treydufrene/meiosis_dev/README.md

# meiosis_dev
development code for meiosis project
