treydufrene/meiosis_dev/LaTeX/cdr/4.2.5.tex

The mechanical parts list and budget is shown in Table \ref{tab:mechbom} below.

\begin{table}[htp]
  \center
  \caption{Mechanical Parts List}
  \label{tab:mechbom}
\begin{tabular}{c|c|c|c|C{2cm}}
Part & Quantity & Individual price & Transaction Cost & Cost to MEIOSIS \\\hline
M3x30mm Screws & 2 & \$5.99 & \$11.98 & \$11.98 \\
M3 Locking nuts & 1 & \$7.99 & \$7.99 & \$7.99 \\
TRiREAK AC Bearing & 7 & \$9.00 & \$63.00 & \$63.00 \\
Thrust Bearing & 1 & \$7.99 & \$7.99 & \$7.99 \\
Skateboard Bearings & 1 & \$5.29 & \$5.29 & \$5.29 \\
MX-64T Servo & 3 & \$299.90 & \$899.70 & \$0 \\
MX-12W Servo & 3 & \$65.90 & \$197.70 & \$197.70 \\
AX-12A Servo* & 1 & \$44.90 & \$44.90 & \$44.90 \\
Hatchbox PLA & 2 Spools & \$19.99/Spool & \$39.98 & \$0 \\
& & \textbf{Total Cost} & \$1,278.53 & \$338.85 \\
\end{tabular}\\
\small{*: Not Yet Purchased}
\end{table}

As shown by Table \ref{tab:mechbom} above, the total cost of the budget is over \$1,200, although the actual cost to the MEIOSIS team is less than this due to the availability of parts in the robotics lab.
