treydufrene/meiosis_dev/LaTeX/cdr/introduction.tex

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

\section*{Notation}\vspace{-\baselineskip}
\renewcommand{\arraystretch}{2.25}
\begin{tabular}{rcl}
\large%
\(
{}^{\text{\scriptsize Frame}}_{\text{\scriptsize From}}~{r}~_{\text{\scriptsize To}}
\)\normalsize &:& Direction Vectors\\
\(
{}^{\text{\scriptsize From}}~{T}~_{\text{\scriptsize To}}
\)\normalsize &:& Direction Cosine (Transformation) Matrices \\
\(c_{\theta_{nm}}\)&:& \( \cos(\theta_n + \theta_m)\)\\
\(s_{\theta_{nm}}\)&:& \( \sin(\theta_n + \theta_m)\) \\
\end{tabular}
\renewcommand{\arraystretch}{1}
\newpage
\pagenumbering{arabic}
\section{Introduction}
Robotics is a rapidly growing field, yet numerous potential innovators for the discipline are never exposed to it. While many industrial style manipulators are available for commercial applications, their cost is so high that they are not practical for educational purposes. With the intention of making robotics education more accessible to classrooms, the Manipulator for Educational Institutions with Open Source Integrated Systems (MEIOSIS) initially aimed to provide robotics classes with an accurate and precise manipulator for cost lower than traditional manipulators. The goal of MEIOSIS is now to provide an accurate and repeatable manipulator, given the capstone team budget. MEIOSIS is designed to be 3D printed by the end-user to increase accessibility of the manipulator and will be modifiable to help create an increased understanding of robotics. The following document details the entirety of the design process, from conceptual design and definition of requirements to final implementation and testing.
