treydufrene/meiosis_dev/LaTeX/cdr/sysdynamics.tex

The motor equation (\ref{eq:fin}) gives an expression for the motor torques, however the system dynamics are defined in terms of geometric joint angles. The inclusion of harmonic gearboxes is taken care of by equation \ref{eq:A}.

\begin{equation}
  \gamma = A\theta\quad \text{where}~~A=\left[\begin{array}{cccccc}
  -1/20 & 0 & {0} & {0} & {0} & {0} \\
   0 & -1/39 & {0} & {0} & {0} & {0} \\
    {0} & {0} & -1/39 & {0} & {0} & {0} \\
    {0} & {0} & {0} & -1/20 & {0} & {0} \\
     {0} & {0} & {0} & {0} & -1/20 & 0\\
      {0} & {0} & {0} & {0} & 0 & -1/20
    \end{array}\right]
\label{eq:A}
\end{equation}
The gear ratios for the harmonics are taken care of by the diagonal entries in the matrix shown in equation \ref{eq:A} above. The motor angles can then be solved for using the inverse of the A matrix, as shown in equation \ref{eq:Ainv}.
\begin{equation}
\theta=A^{-1} \gamma
\label{eq:Ainv}
\end{equation}
It is important to note that the virtual work done by the joint torques ($F_{\gamma}$) and the virtual work done by the motor torques ($F_{\theta}$) are equal. Using equation (\ref{eq:Ainv}), a linear relation between the joint torques and motor torques can be determined.
\[
\begin{aligned}
  \delta W = F_{\theta}^{T} \delta \theta&=F_{\gamma}^{T} \delta \gamma, \text { where } \delta \gamma=A \delta \theta \\
  F_{\theta}^{T} \delta \theta &= F_{\gamma}^{T}(A \delta \theta) \\
  F_{\theta}^{T}&=F_{\gamma}^{T} A\\
  \left(F_{\theta}^{T}\right)^{T}&=\left(F_{\gamma}^{T} A\right)^{T}\\
  F_{\theta}=A^{T} F_{\gamma} &\Leftrightarrow F_{\gamma}=A^{-T} F_{\theta}\qquad\quad
\end{aligned}
\]
Using this equation, a relation can be determined between the motor dynamics and the system dynamics given in equation (\ref{eq:fin}) and equation (\ref{eq:eoms}) respectively.

\[
H(\gamma) \ddot{\gamma}+d(\gamma, \dot{\gamma})+G(\gamma)=-A^{-T}\left(C_1A^{-1} \ddot{\gamma}+C_2 A^{-1} \dot{\gamma}+C_3 \theta_{d}- C_3A^{-1} \gamma\right)
\]
\begin{equation}
\ddot{\gamma}=H(\gamma)^{-1}\left(-A^{-T}\left(C_1 A^{-1} \ddot{\gamma}+C_2 A^{-1} \dot{\gamma}+C_3 \theta_{d}-C_3A^{-1} \gamma\right)-d(\gamma, \dot{\gamma})-G(\gamma)\right)
\label{eq:gddot}
\end{equation}

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
