treydufrene/meiosis_dev/LaTeX/cdr/coverpage.tex

\begin{titlepage}
\flushleft
\doublespacing\center
\Large
% \null\vspace{3cm}
\null\vfill

\textbf{Detailed Design Report}
\vspace{4ex}\normalsize

Trey Dufrene \hfill Zack Johnson \hfill David Orcutt \hfill Alan Wallingford \hfill Ryan Warner
\vfill
\vspace{0.8cm}
  \normalsize
  Submitted in Partial Fulfillment of the Requirements of: \\
  ME420 Detailed Design of Robotic Systems -- Spring 2020\\

  \vspace{0.6cm}
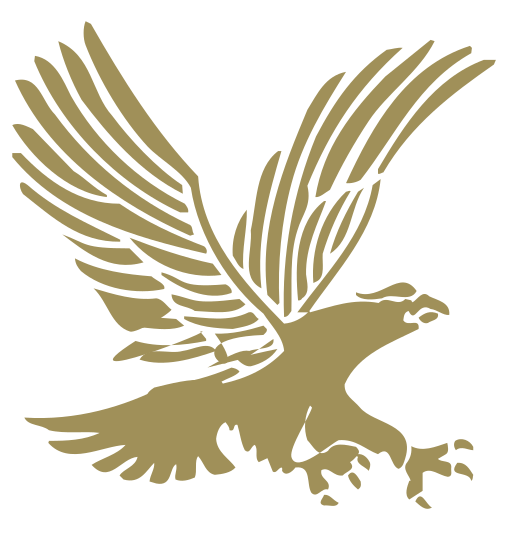
[picture p25: LaTeX/report/images/univ.png]
  
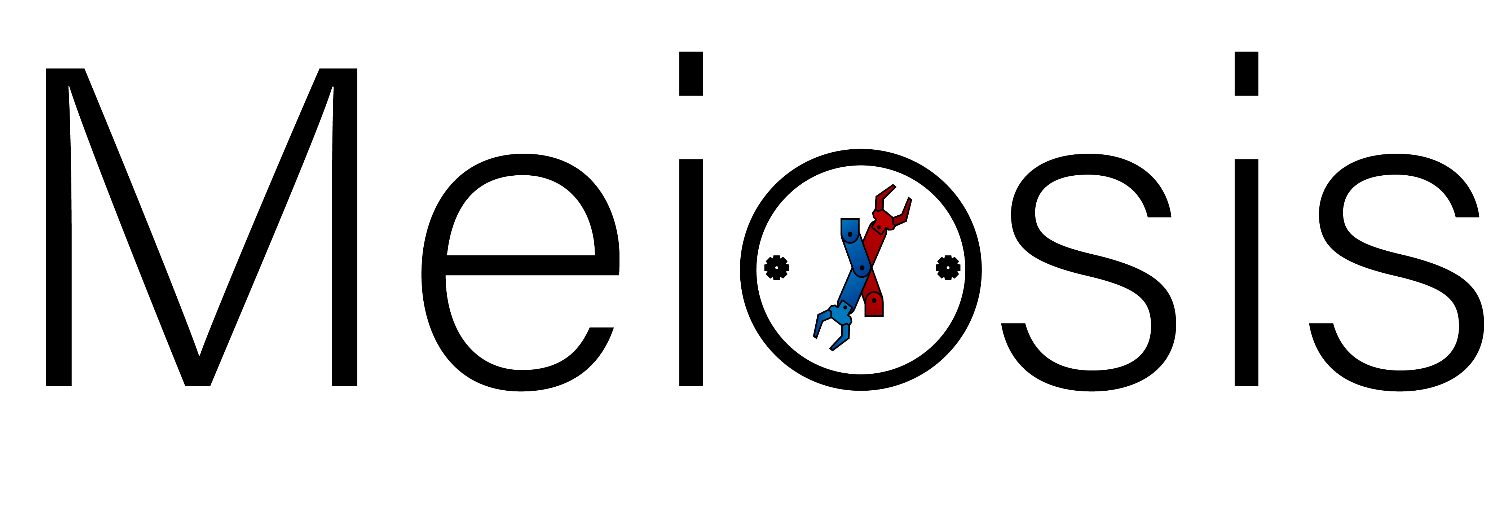
[picture p26: LaTeX/GCD/images/text.png]
  
  \vspace{.2ex}\onehalfspacing
  College of Engineering\\
  Embry-Riddle Aeronautical University\\
  Prescott, AZ\\
\end{titlepage}

% \begin{titlepage}
% \flushleft
% \doublespacing
% \Large
% \textsc{Final Report} \\
% \normalsize
% Trey Dufrene, Alan Wallingford, David Orcutt, Ryan Warner, Zack Johnson
% \vfill
% \center
% \includegraphics[width=.45\textwidth]{logo}
% \vfill
% \flushleft
% ME 407 \\
% Preliminary Design of Robotic Systems \\
% Embry-Riddle Aeronautical University \\
% \vspace{2ex}
% \begin{minipage}[c]{.5\textwidth}
% \flushleft
% \includegraphics[width=.95\textwidth]{erau}
% \end{minipage}%
% \begin{minipage}[c]{.5\textwidth}
% \flushright
% \includegraphics[width=.8\textwidth]{text}
% \end{minipage}
% \end{titlepage}
