treydufrene/meiosis_dev/LaTeX/cdr/hdg.tex

\begin{lstlisting}[frame=lines,style=Matlab-editor,basicstyle = \mlttfamily, caption={H, D, and G Calculations}]
function [H, d, G] = Meiosis_HdG(gamma,gammadot)

    %       Mass Parameters
    %Mass(kg)
    m{1} = 0.13954848;      %Link 1
    m{2} = 1.14358921;      %Link 2
    m{3} = 1.00606970;      %Link 3
    m{4} = 0.26834265;      %Link 4
    m{5} = 0.03933179;      %Link 5
    m{6} = 0.19893937;
    m{7} = 0.24224704;      %Gear 1
    m{8} = 0.24224704;      %Gear 2
    m{9} = 0.05035795;      %Gear 3
    m{10} = 0.05035795;

    %Center of mass for each link (m)
    rcm{1} = [ 0.00000000; 0.00000000;-0.02792483];     %Link 1
    rcm{2} = [ 0.00007758; 0.15623908;-0.00011610];     %Link 2
    rcm{3} = [-0.01528806; 0.07006082; 0.00110335];     %Link 3
    rcm{4} = [ 0.00000000; 0.03163485; 0.00000000];     %Link 4
    rcm{5} = [ 0.00000000; 0.00630115; 0.00000000];     %Link 5
    rcm{6} = [ 0.00000000;-0.03626349;-0.00034373];     %Link 6
    rcm{7} = [-0.02271539;-0.00001560; 0.00001565];     %Gear 1
    rcm{8} = [ 0.02271539;-0.00001560;-0.00001565];     %Gear 2
    rcm{9} = [-0.00678010; 0.00000000; 0.00000000];     %Gear 3
    rcm{10}= [ 0.00678010; 0.00000000; 0.00000000];     %Gear 4

    Gam{1} = rcm{1}*m{1};
    Gam{2} = rcm{2}*m{2};
    Gam{3} = rcm{3}*m{3};
    Gam{4} = rcm{4}*m{4};
    Gam{5} = rcm{5}*m{5};
    Gam{6} = rcm{6}*m{6};
    Gam{7} = rcm{7}*m{7};
    Gam{8} = rcm{8}*m{8};
    Gam{9} = rcm{9}*m{9};
    Gam{10} = rcm{10}*m{10};

    %Inertia Matrices
	J{1} = [ 0.00015462  0.00000000  0.00000000;        %Link 1
	         0.00000000	 0.00016692  0.00000000;
	         0.00000000	 0.00000000  0.00003819];
    J{2} = [ 0.03894999 -0.00002305  0.00000000;        %Link 2
            -0.00002305  0.00589287  0.00001585;
             0.00000000  0.00001585  0.04414151];
    J{3} = [ 0.01143098  0.00169728  0.00000008;        %Link 3
	         0.00169728	 0.00185484 -0.00021794;
	         0.00000008	-0.00021794  0.01259229];
    J{4} = [ 0.00063966  0.00000000  0.00000000;        %Link 4
	         0.00000000	 0.00069715  0.00000000;
	         0.00000000	 0.00000000  0.00108401];
    J{5} = [ 0.00000851  0.00000000  0.00000000;        %Link 5
	         0.00000000	 0.00001467  0.00000000;
	         0.00000000	 0.00000000  0.00002081];
    J{6} = [ 0.00036378  0.00000000  0.00000000;        %Link 6
	         0.00000000	 0.00007212 -0.00000173;
	         0.00000000	-0.00000173  0.00034916];
    J{7} = [ 0.00014269 -0.00000005  0.00000005;        %Gear 1
	        -0.00000005	 0.00029726  0.00000000;
	         0.00000005	 0.00000000  0.00029726];
    J{8} = [ 0.00014269  0.00000005  0.00000005;        %Gear 2
	         0.00000005	 0.00029726  0.00000000;
	         0.00000005	 0.00000000  0.00029726];
    J{9} = [ 0.00003333  0.00000000  0.00000000;        %Gear 3
	         0.00000000	 0.00001986  0.00000000;
	         0.00000000	 0.00000000  0.00001986];
    J{10}= [ 0.00003333  0.00000000  0.00000000;        %Gear 4
	         0.00000000	 0.00001986  0.00000000;
	         0.00000000	 0.00000000  0.00001986];

    %          Forward kinematics
    %Relative Positions
    rBfromI =  [ 0.00000000; 0.00000000; 0.00000000];
    r1fromB =  [ 0.00000000; 0.00000000; 0.12275000];
    r2from1 =  [ 0.00000000; 0.00000000; 0.00000000];
    r3from2 =  [ 0.00000000; 0.26000000; 0.00000000];
    r4from3 =  [ 0.00000000; 0.20000000; 0.00000000];
    r5from4 =  [ 0.00000000; 0.07000000; 0.00000000];
    r6from5 =  [ 0.00000000; 0.09600000; 0.00000000];
    rG1from1 = [ 0.09055000; 0.00000000; 0.00000000];
    rG2from1 = [-0.09055000; 0.00000000; 0.00000000];
    rG3from5 = [ 0.04700000; 0.00000000; 0.00000000];
    rG4from5 = [-0.04700000; 0.00000000; 0.00000000];

    %Store orientations in cell array
    rn{1} = r1fromB;
    rn{2} = r2from1;
    rn{3} = r3from2;
    rn{4} = r4from3;
    rn{5} = r5from4;
    rn{6} = r6from5;
    rn{7} = rG1from1;
    rn{8} = rG2from1;
    rn{9} = rG3from5;
    rn{10} = rG4from5;

    %Orientations wrt I
    TB = eye(3);
    T{1} = TB*rotz(gamma(1));
    T{2} = T{1}*rotx(gamma(2));
    T{3} = T{2}*rotx(gamma(3));
    T{4} = T{3}*roty(gamma(4));
    T{5} = T{4}*rotx(gamma(5));
    T{6} = T{5}*roty(gamma(6));
    T{7} = T{1}*rotx(gamma(1));           %Gear 1
    T{8} = T{1}*rotx(-gamma(1));          %Gear 2
    T{9} = T{5}*rotx(-gamma(6));          %Gear 3
    T{10} = T{5}*rotx(gamma(6));          %Gear 4

    %Positions wrt I
    rB = rBfromI;
    r{1} = rB + TB*r1fromB;
    r{2} = r{1} + T{1}*r2from1;
    r{3} = r{2} + T{2}*r3from2;
    r{4} = r{3} + T{3}*r4from3;
    r{5} = r{4} + T{4}*r5from4;
    r{6} = r{5} + T{5}*r6from5;
    r{7} = r{1} + T{1}*rG1from1;        %Gear 1
    r{8} = r{1} + T{1}*rG2from1;        %Gear 2
    r{9} = r{5} + T{5}*rG3from5;        %Gear 3
    r{10}= r{5} + T{5}*rG4from5;        %Gear 4

    %              Recursive Kinematics
    Jb0 = zeros(6);
    Jbdot0 = zeros(6);

    for ii = 1:10
        if ii == 1
            Jmat = Jb0;
            wI = Jmat(1:3,:)*gammadot;
            [Jb{ii},Jbdot{ii}] = Next_GeoJac_Meiosis(Jb0,Jbdot0,gamma,gammadot,TB,rn{ii},zeros(3,1),wI,ii);
        elseif ii == 7
            Jmat = Jb{1};
            wI = Jmat(1:3,:)*gammadot;
            [Jb{ii},Jbdot{ii}] = Next_GeoJac_Meiosis(Jb{1},Jbdot{1},gamma,gammadot,T{1},rn{ii},zeros(3,1),wI,ii);
        elseif ii == 8
            Jmat = Jb{1};
            wI = Jmat(1:3,:)*gammadot;
            [Jb{ii},Jbdot{ii}] = Next_GeoJac_Meiosis(Jb{1},Jbdot{1},gamma,gammadot,T{1},rn{ii},zeros(3,1),wI,ii);
        elseif ii == 9
            Jmat = Jb{5};
            wI = Jmat(1:3,:)*gammadot;
            [Jb{ii},Jbdot{ii}] = Next_GeoJac_Meiosis(Jb{1},Jbdot{5},gamma,gammadot,T{5},rn{ii},zeros(3,1),wI,ii);
        elseif ii == 10
            Jmat = Jb{5};
            wI = Jmat(1:3,:)*gammadot;
            [Jb{ii},Jbdot{ii}] = Next_GeoJac_Meiosis(Jb{1},Jbdot{5},gamma,gammadot,T{5},rn{ii},zeros(3,1),wI,ii);
        else
            Jmat = Jb{ii-1};
            wI = Jmat(1:3,:)*gammadot;
            [Jb{ii},Jbdot{ii}] = Next_GeoJac_Meiosis(Jb{ii-1},Jbdot{ii-1},gamma,gammadot,T{ii-1},rn{ii},zeros(3,1),wI,ii);
        end

        Jmat = Jb{ii};
        wI = Jmat(1:3,:)*gammadot;

        Hmat = Jb{ii}.'*[J{ii},skew(Gam{ii})*T{ii}.';T{ii}*skew(Gam{ii}).',m{ii}*eye(3)]*Jb{ii};
        dvec = Jb{ii}.'*[J{ii},skew(Gam{ii})*T{ii}.';T{ii}*skew(Gam{ii}).',m{ii}*eye(3)]*Jbdot{ii}*gammadot + Jb{ii}.'*[cross(wI,J{ii}*wI);T{ii}*cross(wI,cross(wI,Gam{ii}))];
        g = Jb{ii}.'*[cross(rcm{ii},T{ii}.'*[0;0;-m{ii}*9.81]);[0;0;-m{ii}*9.81]];

        if ii == 1
            H = Hmat;
            d = dvec;
            G = g;
        else
            H = H + Hmat;
            d = d + dvec;
            G = G + g;
        end
    end

end
\end{lstlisting}
