treydufrene/meiosis_dev/LaTeX/templates/template.tex

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

\begin{document}
\normalem
\input{coverpage}
\pagenumbering{roman}
% \begin{abstract}
  % Wordy words
% \end{abstract}
{\tableofcontents\let\clearpage\relax\listoffigures\let\clearpage\relax\listoftables}
\clearpage
\newpage

% \section*{List Of Acronyms and Abbreviations}

% \begin{tabular}{rl}
%   $G$~:&Center of gravity of the bar \\
%   $\ell_0$~:& Spring unstretched length  \\
%   $\delta$~:& Spring deflection \\
%   $k$~:& Spring constant \\
%   $h_{b}$~:& Distance to bar ($G$) from datum \\
%   $F_s$~:& Force onto bar due to spring\\
%   $A_{n}$~:& Pin reaction in $\theta$ direction\\
%   $A_{t}$~:& Pin reaction in tangential direction \\
%   $\vec{v}_G$~:& Velocity of bar center of gravity\\
%   $\ddot{\theta}$~:& Angular velocity of spring \\
%   $\ddot{\phi}$~:& Angular velocity of bar\\
%   $\ddot{\ell}_s$~:& Radial acceleration of spring \\
% \end{tabular}
% \normalsize
% \flushleft
% \singlespacing
% \newpage

\pagenumbering{arabic}

% A Level:
% \section{}
% B Level:
% \subsection{B Level Heading}
% C Level
% \subsubsection{}

% Example citations:
% \cite{DBLP:journals/corr/JohnsonAL16}
% \cite{DBLP:journals/corr/abs-1803-09820}
% \cite{DBLP:journals/corr/RonnebergerFB15}

% \section{A Level Heading}
% Sample table with tabulated data and reference label
% \begin{table}[htp]
%   \center
%   \caption{DH Table for 6 DOF Manipulator}
%   \label{table:dh}
%   \color{red} bold col headers, table times new roman, 12pt., centered, \color{black} \\
%   \begin{tabular}{C{1cm}|C{1cm}C{2cm}C{1cm}C{1cm}}
%     \textbf{DH} & $d_i$ & $\theta_i$ & $a_i$ & $\alpha_i$ \\ \hline
%     1 & 280 & $q_1 - \pi$ & 0 & $\sfrac{\pi}{2}$ \\
%     2 & 0 & $q_2 + \sfrac{\pi}{2}$ & 210 & 0 \\
%     3 & 0 & $q_3 - \sfrac{\pi}{2}$ & 75 & -$\sfrac{\pi}{2}$ \\
%     4 & 210 & $q_4$ & 0 & $\sfrac{\pi}{2}$ \\
%     5 & 0 & $q_5 - \pi$ & 0 & $\sfrac{\pi}{2}$ \\
%     6 & 70 & $q_6$ & 0 & 0 \\
%   \end{tabular}
% \end{table}
% here is the table reference callout
% \emph{Table \ref{table:dh}} shows the Denavit–Hartenberg parameters for the manipulator.

% Here is a centered mathtype with no number
% $$
% \vec{v}_G =
% \left[\dot{\ell}_s\sin(\theta) + \frac{\ell_b\dot{\phi}\cos(\phi)}{2} +
% \ell_s\dot{\theta}\cos(\theta)\right]\hat{\textrm{\i}} +
% \left[\frac{\ell_b\dot{\phi}\sin(\phi)}{2} -
% \dot{\ell}_s\cos(\theta) + \ell_s\dot{\theta}\sin(\theta)\right]\hat{\textrm{\j}}
% $$

% Here is a centered equation with number and reference label
% \begin{equation}
% \ddot{\theta} = \frac{d}{dt}\left(\frac{\partial\Lag}{\partial\dot{\theta}}\right) -
% \frac{\partial\Lag}{\partial\theta} = \big(Q_{\theta}\big)_{\text{non}}
% \label{eq:lagtheta}
% \end{equation}

% This is some inline mathtype: $u = \frac{1}{2}mv^2$, (notice the fluidity and smaller size than the other mathtype)

% \section{A Level Heading}
% \begin{figure}[h]
%   \centering
%   \includegraphics[width=.75\textwidth]{filename}
%   \caption{Figure with Callouts}
%   \label{fig:figname}
% \end{figure}

% \begin{enumerate}[label=\alph*.]
%   \item Description for callout a
%   \item Description for callout b
% \end{enumerate}

% As seen in \emph{Figure \ref{fig:figname}}

% \newpage
% \bibliographystyle{plain}
% \bibliography{JohnsonAL16,abs-1803-09820,RonnebergerFB15}

% \newpage
% \section*{Acknowledgements \& Attributions}
% \begin{itemize}
%   \item People!
% \end{itemize}
% \newpage

% \newpage
% \appendix
% \renewcommand\thesection{\Roman{section}}
% \renewcommand\thesubsection{\roman{subsection}}
% \section*{Appendix}\label{sec:app}
% Code listing
%\begin{lstlisting}[frame=lines,style=Matlab-editor,basicstyle = \mlttfamily, caption=Example Code
% Code Here
%\end{lstlisting}

% \includepdf[landscape,pages=-]{pdfname}

\end{document}
