treydufrene/meiosis_dev/LaTeX/report/final.pdf

Final Report

Trey Dufrene, Alan Wallingford, David Orcutt, Ryan Warner, Zack Johnson

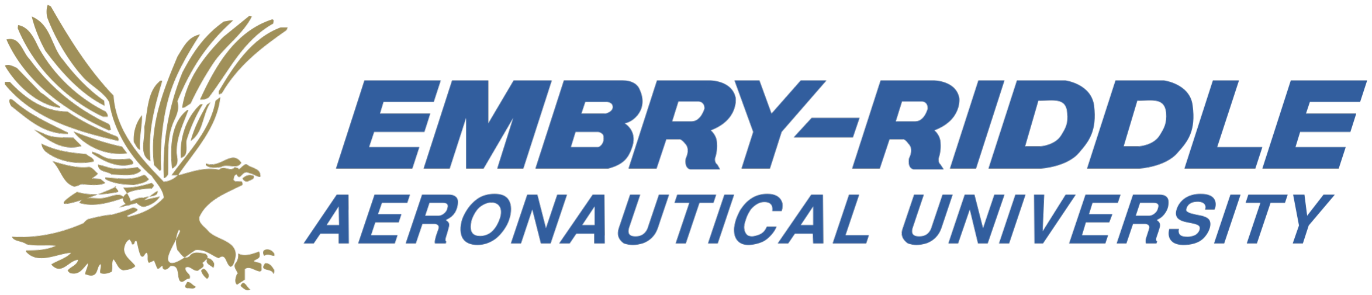
[picture p27: figure]
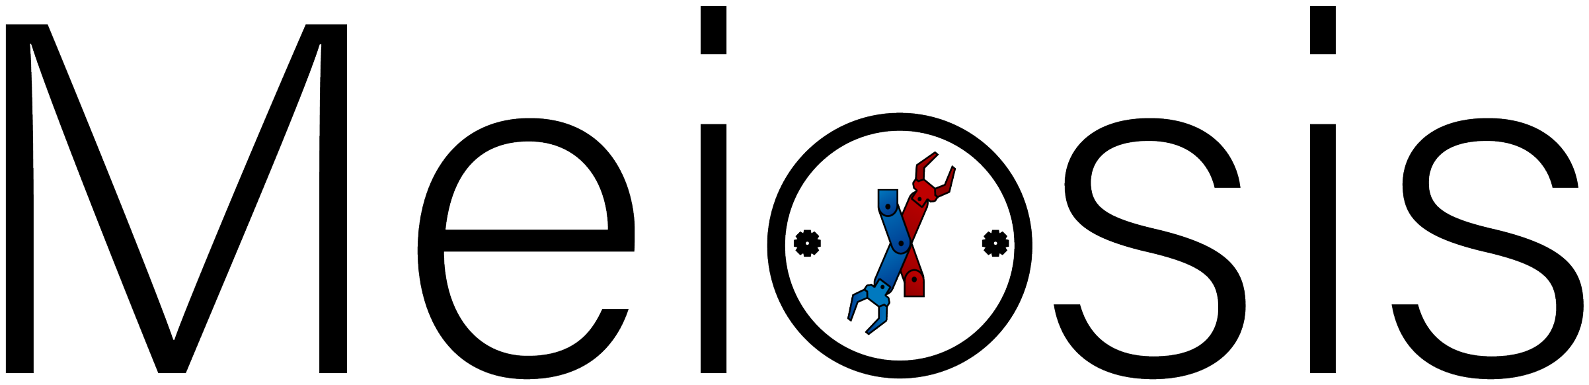
[picture p28: figure]

ME 407

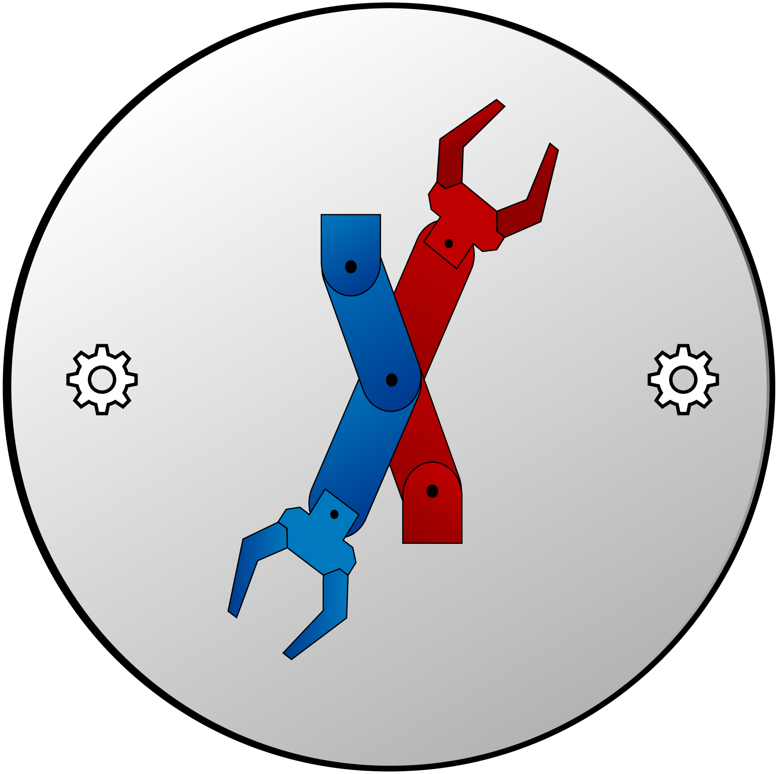
[picture p29: figure]

Preliminary Design of Robotic Systems

Embry-Riddle Aeronautical University

# Contents

1 | Introduction | | 1
2 | Requirements | | 1
3 | Conceptual Design | | 1
4 | Specifications | | 2
4.1 | Introduction | | 2
4.2 | Design Requirements | | 2
4.3 | Hardware | | 3
4.4 | Software | | 6
5 | Preliminary Design | | 8
5.1 | CAD | | 8
5.2 | Forward Kinematics | | 9
5.3 | Velocity Kinematics | | 11
5.4 | Inverse Kinematics | | 11
5.5 | Equations of Motion | | 12
5.6 | Open-Loop Simulation | | 13
5.7 | Control System | | 13
5.8 | Closed-Loop Simulation | | 13
5.9 | ANSYS | | 13
5.10 | Electrical Schematic | | 13
5.11 | Software Flowchart | | 13
5.12 | Project Status and Future | | 13
5.13 | Parts List | | 13
I | Appendix | | 17
i | Drawings | | 17
ii | Salient Code | | 17

# List of Figures

1 | Overview of Physical System | | 2
2 | Elbow Manipulator Configuration with Link Offset | | 4
3 | Kinematic Model Representing Zeroed Configuration | | 5
4 | Coordinate Systems | | 9
5 | Cross Section of Dexterous Workspace Quadrant | | 17

i

## 1 Introduction

## 2 Requirements

— The system shall cost the end-user no more than $1000.

— The system shall be fully dexterous without being kinematically redundant.

— The system end-effector shall maintain a positional accuracy magnitude of ±1 mm and an orientation accuracy of ±5

◦
eigen angle from the base frame.

— The system end-effector shall maintain a pose repeatability magnitude between 0.1 -1.5 mm for the position and ±4

◦
eigen angle from the base frame for the orientation.

— The system’s reachable workspace shall be a hemisphere with a radius of 300-700 mm.

— The system’s dexterous workspace shall contain a hemispherical shell within the reachable workspace with a thickness of 280 mm.

— The system shall have a removable end-effector capable of picking and placing a low-odor chisel tip Expo dry erase marker.

— The system shall be able to write with a low-odor chisel tip Expo dry erase marker.

— The system shall be open source.

— The system shall be capable of operating given only desired end-effector cartesian coordinates specified with respect to the base frame.

## 3 Conceptual Design

## 4 Specifications

### 4.1 Introduction

With the intention of making robotics education more accessible, The Manipulator for Educational Institutions with Open Source Integrated Systems (MEIOSIS) intends to provide high school educators and robot enthusiasts with a low cost manipulator. The system should be usable by novice students. It should also be modifiable to create a sustainably increased understanding of robotics. While MEIOSIS may not fully emulate industrial manipulators, it aims to provide more students with access to robotics education.


Figure 1: Overview of Physical System

The design seen in Figure 1 is based on our conceptual design. It features four links and six joints for rotation and will be referenced throughout this document. The base of the manipulator and end-effector can also be seen in the figure.

### 4.2 Design Requirements

The specifications of the system are strictly based on the requirements defined previously. The requirements are divided into two primary categories, hardware and software.

### 4.3 Hardware

The following requirements and specifications are hardware specific and dictate the physical constaints the system must adhere to.

4.3.1 The system shall cost the end-user no more than $1000.

4.3.1.a The cost for the MEIOSIS team to develop the manipulator shall cost no more than $800.

### 4.3.2 The system shall be fully dexterous without being kinematically

redundant.

4.3.2.a The system shall consist of six rotational joints connected by four links. The last three joints will create a spherical wrist.

As defined [1], “A manipulator having more than six DOF is referred to as a kinematically redundant manipulator (5).” A manipulator with less than six degrees of freedom will not be fully dexterous within it’s workspace. Figure 3 (see subsection 4.3.6, p. 5) shows a six degree-of-freedom rotary manipulator with it’s coordinate frames in zeroed positions. The joint and link locations are seen in Figure 1 (see section 4.1, p. 2).

4.3.2.b The system shall have no link offsets.

Link offsets as seen in Figure 2 are commonly used to avoid singularities. However, having a link offset prevents the manipulator’s dexterous workspace from being a complete hemispherical shell.

As shown in Figure 2, the line directly above the first joint of the manipulator is offset such that the axes of the other joints are unable to become collinear with the base axis; this prevents singularity but causes a void in the detxterous workspace.

### 4.3.3 The system end effector shall maintain a positional accuracy magnitude

of ±1 mm and an orientation accuracy of ±5

- eigen angle from the base frame.

To ensure that the robot has educational value, the accuracy must be defined so that any desired positions and movements are achieved.

4.3.3.a The system shall accommodate a process in which the end user can calibrate the end effector position and orientation to within 0.5 mm and 1 degree of the manipulator’s


Figure 2: Elbow Manipulator Configuration with Link Offset [1]

precision.

The addition of a calibration process allows the removal of any systematic errors, such as drift. The theoretical limit of the calibration process is the difference between the precision and accuracy metrics of the system.

### 4.3.4 The system end effector shall maintain a pose repeatability magnitude

between 0.1—1.5 mm for the position and ±4

- eigen angle from the base frame for the orientation.

4.3.4.a Joint one and two of the system shall possess an angle error of no more than .025 degrees.

Being that joint one and two are the first two rotational elements in the system, their error will propagate the most to the end effector’s position.

4.3.4.b Joint three of the system shall possess an angle error of no more than .03 degrees.

Since joint three is closer to the end effector it’s error will not propagate as severely throughout the system.

4.3.4.c Joints four, five, and six shall possess an angle error of no more than .29 degrees.

The spherical wrist is the closest to the end effector’s final position and therefore has the least error propagation.

### 4.3.5 The system’s reachable workspace shall be a hemisphere with a radius

of 300-700 mm.

This workspace will provide enough movement to manipulate objects in order to perform basic tasks.

4.3.5.a The length of link one, two, three, four, and the wrist shall be 220.8 mm, 250 mm, 200 mm, 80 mm, and 52.5 mm respectively.

This results in a total height of 220.8 mm with a total reach of 582.5 mm in the zeroed configuration as shown in the configuration represented in Figure 3.

### 4.3.6 The system’s dexterous workspace shall contain a hemispherical shell

within the reachable workspace with a thickness of 280 mm.

This workspace will provide enough movement to manipulate objects in order to perform basic tasks. 280mm is slightly greater than the length of letter paper.

4.3.6.a The rotational limit of joint one, two, three, four, five, and six shall be ±180◦
, −9.7

◦
to 177.5

◦
, −150.6

◦
to −19.3

◦

, ±180◦

, −180◦
to −1.6

◦

, and ±180◦
respectively.

The angles stated are with respect to the kinematic model shown in Figure 3. To be fully dexterous within our 280 mm dexterous workspace the manipulator must have the joint angles specified above. The joint limitations were calculated by iteratively verifying the orientation about every point within the quarter hemisphere cross section seen in Figure 5 (see Appendix, p. 17).

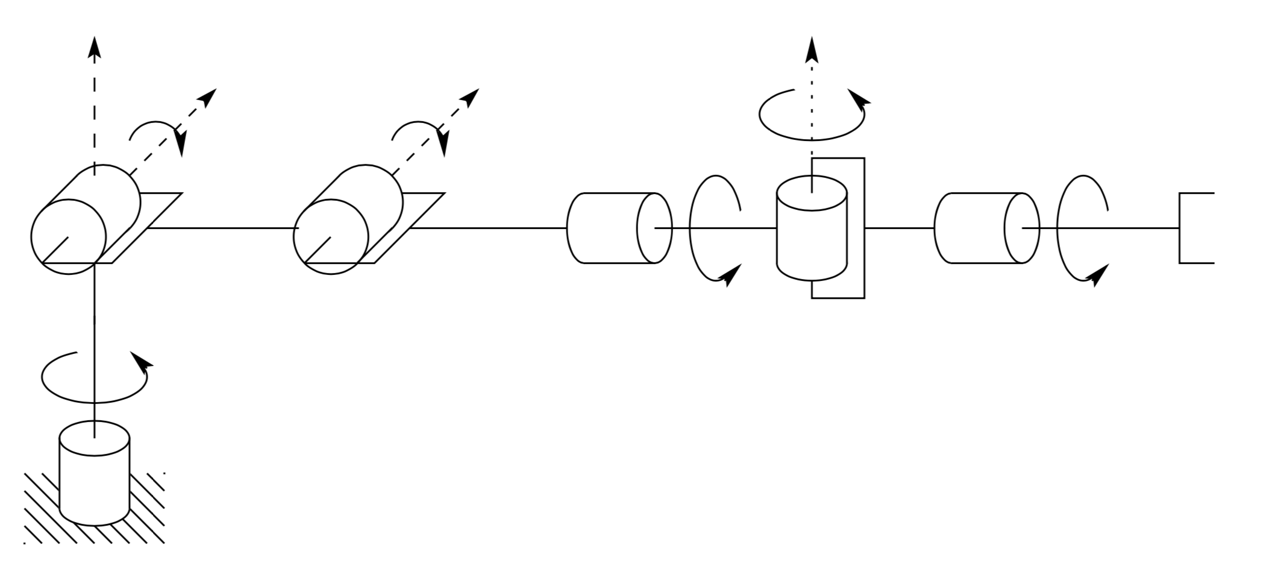
[picture p30: figure]

Figure 3: Kinematic Model Representing Zeroed Configuration [1]

### 4.3.7 The system shall have a removable end effector capable of picking and

placing a low-odor chisel tip Expo dry erase marker.

This creates a robot capable of performing a variety of basic tasks, which enhances its educational value.

4.3.7.a The system shall use a parallel gripper that can close to 18mm.

The diameter of a low-odor chisel tip Expo dry erase marker is approximately 18 mm.

4.3.7.b The end effector shall attach to the manipulator using screws configured in a pattern that can accommodate a Dynamixel AX-12A servo.

It is expected that a majority of end effector styles will have to accommodate for a servo to facilitate actuation, therefore a pattern was chosen to standardize the mounting.

### 4.3.8 The system shall be able to write with a low-odor chisel tip Expo dry

erase marker.

4.3.8.a The end effector shall be able to support 0.004 Newton meter moments about the axes normal to its gripping surfaces.

The coefficient of friction between the Expo marker and paper can be approximated and given the weight of an Expo marker the approximate grip strength of the end effector can be calculated.

### 4.4 Software

The following requirements and specifications are software specific and determine the at-tributes of the operating system.

4.4.1 The system shall be open source.

This will create an easily obtainable, low cost method of distributing the system’s source code, which may be modified for personal use.

4.4.1.a The software shall be hosted publicly on an online repository and maintain an MIT license for distribution.

This allows the end-user to freely download and modify the code without licensing. The MIT license disregards any legal obligation to code upkeep and documentation by the original author.

### 4.4.2 The system shall be capable of operating given only desired end effector

cartesian coordinates specified with respect to the base frame.

4.4.2.a The system shall have a user interface capable of accepting the end-effector’s desired cartesian position and Euler angle orientation as a six element row vector.

The system software interface facilitates an untrained user to operate without the advanced knoledge of the system’s kinematics.

4.4.2.b The system shall be capable of performing floating point arithmetic.

The solution for the inverse kinematics requires the ability to perform high level arithmetic with little error.

## 5 Preliminary Design

### 5.1 CAD

### 5.2 Forward Kinematics

The forward kinematics of the manipulator are described by the equations below, where the reference coordinate frames are given by Figure (4).

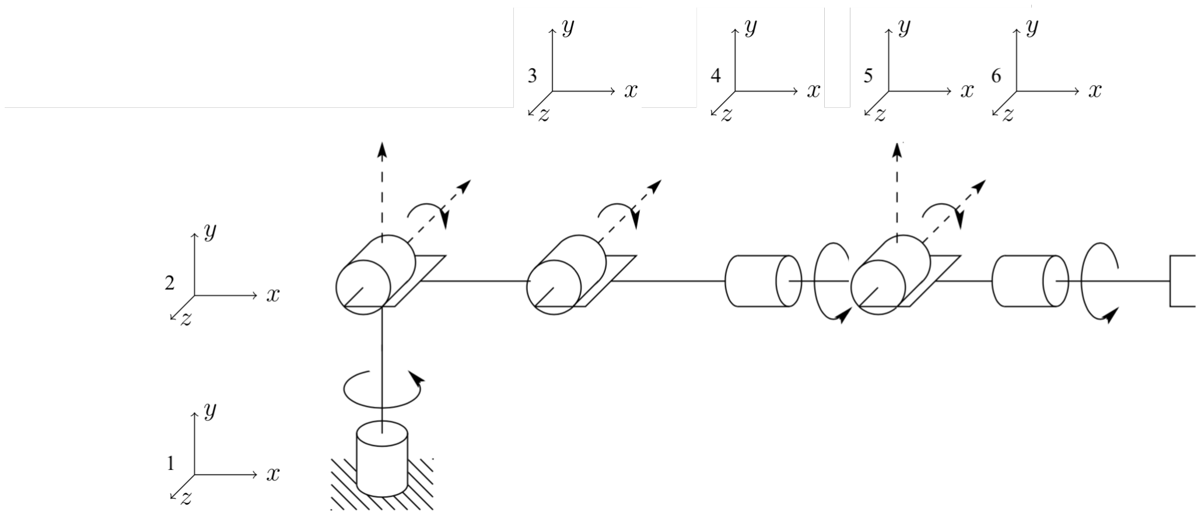
[picture p31: figure]

Figure 4: Coordinate Systems

Given the lengths of each of the manipulator links,

I
Br1 =

0
0
`b

1/1 r2 =

0
0
`1

2/2 r3 =

0
`2
0

3/3 r4 =

0
`3
0

4/4 r5 =

0
`4
0

5/5 r6 =

0
`5
0

The position of each link relative to the inertial frame is given as:

I
Br1 = Br1

I
Br2 = r1 +

IT1
1/1 r2

I
Br3 = r2 +

IT2
2/2 r3

I
Br4 = r3 +

IT3
3/3 r4

I
Br5 = r4 +

IT4
4/4 r5

I
Br6 = r5 +

IT5
5/5 r6

I
Br1 =

0
0
`b

I
Br2 =

0
0
`b + `1

I
Br3 =

−`2cθ2
sθ1
`2cθ12
`b + `1 + `2sθ2

I
Br4 =

−sθ1

(`3cθ23 + `2cθ2

)
cθ1

(`3cθ23 + `2cθ2

)
`1 + `b + `3sθ23 + `2sθ2

I
Br5 =

−sθ1

(`3cθ23 + `4cθ23 + `2cθ2

)
cθ1

(`3cθ23 + `4cθ23 + `2cθ2

)
`1 + `b + `3sθ23 + `4sθ23 + `2sθ2

I
Br6 =

`5cθ1
sθ4

sθ5 − `4cθ23 sθ1 − `2cθ2

sθ1 − `5cθ23 cθ5

sθ1 − `3cθ23 sθ1
+ `5cθ2
cθ4

sθ1

sθ3

sθ5 + `5cθ3
cθ4

sθ1

sθ2

sθ5
`5(sθ5

(sθ1

sθ4 − cθ4

(cθ1
cθ2

sθ3 + cθ1
cθ3

sθ2

)) − cθ5

(cθ1
sθ2

sθ3 − cθ1
cθ2

cθ3

))
− `3(cθ1
sθ2

sθ3 − cθ1
cθ2

cθ3

) − `4(cθ1
sθ2

sθ3 − cθ1
cθ2

cθ3

) + `2cθ1
cθ2

`1 + `b + `3sθ23 + `4sθ23 + `2sθ2 +

`5cθ23 sθ45
2

+ `5sθ23 cθ5 −

`5sθ4−θ5
cθ23
2

Given the direction cosine matrices,

rotx(θ) =

1 | 0 | 0
0 cos(θ) − sin(θ)
0 sin(θ) cos(θ)

- , roty(θ) =

1 | 0 | 0
0 cos(θ) − sin(θ)
0 sin(θ) cos(θ)

rotz(θ) =

cos(θ) | 0 | sin(θ)
0 | 1 | 0
− sin(θ) cos(θ) | 0

The orientation of each link with respect to the inertial frame is given as:

IT1 = rotz(θ1)

IT2 = rotz(θ1) rotx(θ2)

IT3 = rotz(θ1) rotx(θ2) rotx(θ3)

IT4 = rotz(θ1) rotx(θ2) rotx(θ3) roty(θ4)

IT5 = rotz(θ1) rotx(θ2) rotx(θ3) roty(θ4) rotx(θ5)

IT6 = rotz(θ1) rotx(θ2) rotx(θ3) roty(θ4) rotx(θ5) roty(θ6)

IT1 =

cθ1 | −sθ1 | 0
sθ1
cθ1 | 0
0 | 0 | 1

IT2 =

cθ1 −cθ2
sθ1

sθ1

sθ2
sθ1

cθ1

cθ2 −cθ1
sθ2
0 sθ2
cθ2

IT3 =

cθ1 −cθ23 sθ1
sθ23 sθ1
sθ1
cθ23 cθ1 | −sθ23 cθ1
0 | sθ23 | cθ23

IT4 =

cθ1

cθ4 − sθ23 sθ1

sθ4 −cθ23 sθ1
cθ1

sθ4 + sθ23 cθ4
sθ1
cθ4

sθ1 + sθ23 cθ1
sθ4

cθ23 cθ1

sθ1

sθ4 − sθ23 cθ1
cθ4

−cθ23 sθ4
sθ23 | cθ23 cθ4

IT5 =

cθ1

cθ4 − sθ23 sθ1
sθ4

sθ5

(cθ1
sθ4 + sθ23 cθ4
sθ1

) − cθ23 cθ5
sθ1

cθ5

(cθ1
sθ4 + sθ23 cθ4
sθ1

) + cθ23 sθ1
sθ5
cθ4

sθ1 + sθ23 cθ1
sθ4

sθ5

(sθ1

sθ4 − sθ23 cθ1
cθ4

) + cθ23 cθ1
cθ5

cθ5

(sθ1

sθ4 − sθ23 cθ1
cθ4

) − cθ23 cθ1
sθ5

−cθ23 sθ4
sθ23 cθ5 + cθ23 cθ4
sθ5

cθ23 cθ4

cθ5 − sθ23 sθ5

IT6 =

IT6(1,1)

IT6(1,2)

IT6(1,3)

IT6(2,1)

IT6(2,2)

IT6(2,3)

IT6(3,1)

IT6(3,2)

IT6(3,3)

IT6(1,1) = cθ6
(cθ1

cθ4 − sθ23 sθ1
sθ4

) − sθ6

(cθ5

(cθ1
sθ4 + sθ23 cθ4
sθ1

) + cθ23 sθ1
sθ5

)

IT6(1,2) = sθ5
(cθ1
sθ4 + sθ23 cθ4
sθ1

) − cθ23 cθ5
sθ1

IT6(1,3) = cθ6
(cθ5

(cθ1
sθ4 + sθ23 cθ4
sθ1

) + cθ23 sθ1
sθ5

) + sθ6

(cθ1

cθ4 − sθ23 sθ1
sθ4

)

IT6(2,1) = cθ6
(cθ4
sθ1 + sθ23 cθ1
sθ4

) − sθ6

(cθ5

(sθ1

sθ4 − sθ23 cθ1
cθ4

) − cθ23 cθ1
sθ5

)

IT6(2,2) = sθ5
(sθ1

sθ4 − sθ23 cθ1
cθ4

) + cθ23 cθ1
cθ5

IT6(2,3) = sθ6
(cθ4
sθ1 + sθ23 cθ1
sθ4

) + cθ6
(cθ5
(sθ1
sθ4 − sθ23 cθ1
cθ4

) − cθ23 cθ1
sθ5

)

IT6(3,1) = sθ6
(sθ23 sθ5 − cθ23 cθ4
cθ5

) − cθ23 cθ6
sθ4

IT6(3,2) = sθ23 cθ5 + cθ23 cθ4
sθ5

IT6(3,3) = cθ6
(sθ23 sθ5 − cθ23 cθ4
cθ5

) − cθ23 sθ4
sθ6

### 5.3 Velocity Kinematics

### 5.4 Inverse Kinematics

The inverse kinematics can be calculated given desired position and orientation vectors, o and R, respecitvely.
h
xc | yc | zc

i
= o , R =

r11 | r12 | r13
r21 | r22 | r23
r31 | r32 | r33

Inverse Position :
θ1 = atan2 (xc, yc) − atan2 d, q
x

2
c + y

2

c − d
2
− π/2

θ2 = atan2
zc − `1,

q
x

2
c + y

2

c − d
2
− atan2 (`3s3, `2 + `3c3)

θ3 = atan2(−

√
1 − D²

, D)

where D ≡

x

2
c + y

2
c − d

2 + (zc − `1)

2 − `
2
2 − `

2
3
2`2`3
Inverse Orientation :
IT3 = rotz(θ1) rotx(θ2) rotx(θ3)

3T6 =

IT

T
3 R
θ4 = atan2
3T6(1,2),

3T6(3,2)

θ5 = atan2
3T6(3,2)/c4,

3T6(2,2)

θ6 = atan2
3T6(2,1), −

3T6(2,3)

### 5.5 Equations of Motion

H(γ)¨γ + d(γ, γ˙) + G(γ) + B( ˙γ) + Csgn( ˙γ) = F | (1)

JB =

ITB(:, 3)T
·

∂
∂γ

I
TB(:, 2)

ITB(:, 1)T
·

∂
∂γ

I
TB(:, 3)

ITB(:, 2)T
·

∂
∂γ

I
TB(:, 1)

=

"
B
BωI

I
Br˙B

B
BΓ =B

B rcmmb , S˚(ω)r = (ω × r)

G(γ) ≡

∂U(

I
r(γ))

∂γ !T

UB =

h
0 0 g

i I
BrBmB +

I TB

B
BΓ

H(γ) = X

N

B

JB(γ)

T

B

BJ S˚(
B
BΓ)IT

T
B
ITBS˚(
B
BΓ)T | mBI

- JB(γ) | (2)

d(γ, γ˙) = X

N

B

JB(γ)

T

B

BJ S˚(
B

BΓ)IT

T
B
ITBS˚(
B
BΓ)T | mBI

- J˙
B(γ, γ˙) ˙γ+JB(γ)

T

B

BωI ×B
B J

B
B ωI

ITB

B
BωI × (

B

BωI ×B

B Γ)

(3)

### 5.6 Open-Loop Simulation

### 5.7 Control System

### 5.8 Closed-Loop Simulation

### 5.9 ANSYS

### 5.10 Electrical Schematic

### 5.11 Software Flowchart

### 5.12 Project Status and Future

### 5.13 Parts List

Given robot dynamics described by H(γ)¨γ + n(γ, γ˙) = τ , the torque, τ , provided by the servo motors is necessary to solve the closed loop dynamics of the system. Assuming the servo is driven by a D.C. motor with proportional derivative control,

τa = Kia = Ja

¨θa + ba
˙θa + τL | (4)

Where τa is the actuator torque, K is the back-EMF constant, ia is the motor current, Ja is the armature inertia, θa,

˙θa,

¨θa is the motor position and it’s first and second time derivatives, respectively, ba is the viscous friction coefficient, and τL is the torque available for the actuator to do work. The basic equation for a motor is known to be:

Va = iaRa + K ˙θa | (5)

Where Va is the voltage applied to the actuator and Ra is the armature resistance. Given a gearbox with in/out ratio N and efficiency η,

θa

τin

θ =

θa
N
τout = τinNη N

The motor equation (4) can be expressed in the output coordinates:

Kia = JaN ¨θ + baN ˙θ +

τ
Nη

Substituing into equation (5) and solving for ia:

ia =

JaN
K

¨θ + baN ˙θ +

τ
Nη

Va =

RaJaN
K

¨θ +

RabaN
K

˙θ +

Ra
KNη
τ + KN ˙θ | (6)

Assuming P.D. control, Va = Kp(θ − θd) + Kd

˙θ, where θd is the desired orientation of the actuator, the following solution is found by setting the P.D. solution equal to (6). After collecting like terms:

RaJaN
K

¨θ +

RaJaN
K

− Kd + KN
˙θ − Kpθ = −Kpθd −

Ra
KNη
τ | (7)

The following parameters of the system can be obtained by applying a step input to the system with τ = 0 and measuring the characteristics of it’s response. Denoting ζ as the damping ratio and ωn as the natural frequency of the system,

% Overshoot =

θmax − θss

θss | !
× 100 , | ζ =

− ln(%OS/100)
q
π

2 + ln²
(%OS/100)

, ωn =

π
Tp

√
1 − ζ
2

Given θmax, θss, and Tp as measured parameters of the system’s max output, steady state, and time to peak, respectively.

Refactoring equation (7) and equating with the general solution for a second order system given by ¨θ + 2ζωn
˙θ + ω
2
n

θ = ω

2
n

θd,

2ζωn =

ba
Ja

−

KKd
RaJaN

+

K²
RaJa

, ω²
n =

−KKp
RaJaN

(8)

Performing a similar experiment as previously described, except with a known inertial load τ = Jm

¨θ, the following parameters can be found:

αm ≡ 2ζωn =

RabaN²

η − KKdNη + K²N²
η
RaJaN²η + RaJm

, βm ≡ ωn = −

KKpNη
RaJaN²η + RaJm

(9)

1 −(α1J1 + β1J1)
1 −(α2J2 + β2J2)

RabaN²

η − KKdNη + K²N²
η − KKpNη
RaJaN²η

1
JaN²η

=

α1 + β1
α2 + β2

(10)

Finally, with multiple datasets (varying inertial loads, Jm) the coefficients of the second order system equation can be found using the least squares solution of (10).

## Acknowledgements & Attributions

We would like to acknowledge the following people for their contibutions to creating this report?

— Dr. Isenberg

— Dr. Schipper

## I Appendix

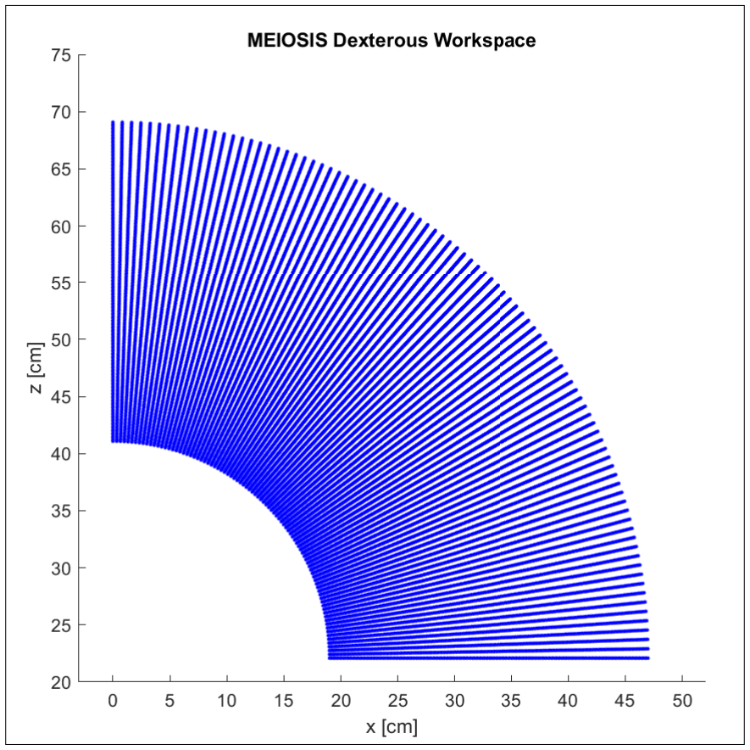
[picture p32: figure]

Figure 5: Cross Section of Dexterous Workspace Quadrant

i | Drawings
ii | Salient Code

# References

[1] S. Hutchinson M. Spong and M. Vidyasager. Robot Modeling and Control. 2006.
