treydufrene/meiosis_dev/LaTeX/specs/specs.pdf

Specifications

Trey Dufrene, Zack Johnson, David Orcutt, Alan Wallingford, Ryan Warner


ME 407

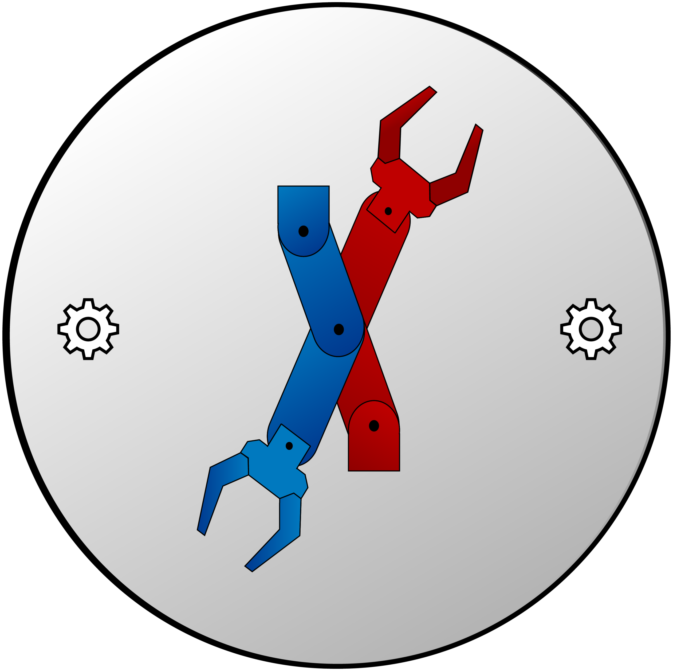
[picture p33: figure]

Preliminary Design of Robotic Systems

Embry-Riddle Aeronautical University

# Contents

1 | Introduction | | 1
2 | Design Requirements | | 1
2.1 | Hardware | | 1
2.2 | Software | | 4

# List of Figures

1 | Overview of Physical System | | 1
2 | Elbow Manipulator Configuration with Link Offset | | 2
3 | Kinematic Model Representing Zeroed Configuration | | 4
4 | Cross Section of Dexterous Workspace Quadrant | | 6

i

## 1 Introduction

With the intention of making robotics education more accessible, The Manipulator for Educational Institutions with Open Source Integrated Systems (MEIOSIS) intends to provide high school educators and robot enthusiasts with a low cost manipulator. The system should be usable by novice students. It should also be modifiable to create a sustainably increased understanding of robotics. While MEIOSIS may not fully emulate industrial manipulators, it aims to provide more students with access to robotics education.

The design which will be referenced throughout this document can be seen in Figure 1.


Figure 1: Overview of Physical System

The design seen in Figure 1 is based on our conceptual design. It features four links and six joints for rotation and will be referenced throughout this document. The base of the manipulator and end-effector can also be seen in the figure.

## 2 Design Requirements

The specifications of the system are strictly based on the previously defined requirements. The requirements are divided into two categories: hardware and software.

### 2.1 Hardware

The following requirements and specifications are hardware specific, dictating the physical system’s constraints.
2.1.1 The system shall cost the end-user no more than $1000.

2.1.1.a The cost for the MEIOSIS team to develop the manipulator shall be no more than $800.

### 2.1.2 The system shall be fully dexterous without being kinematically

redundant.

2.1.2.a The system shall consist of six rotational joints connected by four links. The last three joints will create a spherical wrist.
By definition, “A manipulator having more than six DOF is referred to as a kinematically redundant manipulator [1, pp. 5].” A manipulator with less than six degrees of freedom (DOF) will not be fully dexterous within it’s workspace. Figure 3 (see subsection 2.1.6, p.
4) shows a six degree-of-freedom rotary manipulator with it’s coordinate frames in zeroed positions. The joint and link locations are shown in Figure 1 (see section 1, p. 1). 2.1.2.b The system shall have no link offsets.
Link offsets as seen in Figure 2 are commonly used to avoid singularities. However, having a link offset prevents the manipulator’s dexterous workspace from being a complete hemispherical shell.


Figure 2: Elbow Manipulator Configuration with Link Offset [1]

As shown in Figure 2, the line directly above the first joint of the manipulator is offset such that the axes of the other joints are unable to become collinear with the base axis; this prevents singularity but causes a void in the detxterous workspace.

### 2.1.3 The system end-effector shall maintain a positional accuracy magnitude

of ±1 mm and an orientation accuracy of ±5

- eigen angle from the base frame.

To ensure that the robot has educational value, the accuracy must be defined so that any desired positions and movements are achieved.
2.1.3.a The system shall accommodate a process in which the end user can calibrate the end-effector’s position and orientation to within 0.5 mm and 1 degree of the manipulator’s precision.

The addition of a calibration process allows the removal of any systematic errors, such as drift. The theoretical limit of the calibration process is the difference between the precision and accuracy metrics of the system.

### 2.1.4 The system end-effector shall maintain a pose repeatability magnitude

between 0.1—1.5 mm for the position and ±4

- eigen angle from the base frame for the orientation.

2.1.4.a Joints one and two of the system shall possess an angular error of no more than .025 degrees.
Since joints one and two are the first two rotational elements in the system, their error will propagate the most to the end-effector’s position.
2.1.4.b Joint three of the system shall possess an angle error of no more than .03 degrees. Since joint three is closer to the end-effector it’s error will not propagate as severely throughout the system.
2.1.4.c Joints four, five, and six shall possess an angle error of no more than .29 degrees. The spherical wrist is the closest to the end-effector’s final position and therefore has the least error propagation.

### 2.1.5 The system’s reachable workspace shall be a hemisphere with a radius

of 300-700 mm.

This workspace will provide enough movement to manipulate objects in order to perform basic tasks.
2.1.5.a The length of link one, two, three, four, and the wrist shall be 220.8 mm, 250 mm, 200 mm, 80 mm, and 52.5 mm respectively.

### 2.1.6 The system’s dexterous workspace shall contain a hemispherical shell

within the reachable workspace with a thickness of 280 mm.

This workspace will provide enough movement to manipulate objects in order to perform basic tasks. 280mm is slightly greater than the length of letter paper.
2.1.6.a The rotational limit of joint one, two, three, four, five, and six shall be ±180◦
,
−9.7

◦
to 177.5

◦
, −150.6

◦
to −19.3

◦

, ±180◦

, −180◦
to −1.6

◦

, and ±180◦
respectively.
The angles stated are with respect to the kinematic model shown in Figure 3. To be fully dexterous within the 280 mm dexterous workspace, the manipulator must have the joint angles specified above. The joint limitations were calculated by iteratively verifying the orientation about every point within the quarter hemisphere cross section seen in Figure 4 (see Appendix, p. 6).
The kinematic model in Figure 4 shows the zeroed configuration for a six degree of freedom robot with only rotational joints. This is the reference configuration for specifications 2.1.2.a, 2.1.5.a, and 2.1.6a.


Figure 3: Kinematic Model Representing Zeroed Configuration [1]

### 2.1.7 The system shall have a removable end-effector capable of picking and

placing a low-odor chisel tip Expo dry erase marker.

A removable end-effector creates a robot capable of performing a variety of basic tasks, which enhances its educational value.
2.1.7.a The system shall use a gripper that can close to 18mm.
The diameter of a low-odor chisel tip Expo dry erase marker is approximately 18 mm. 2.1.7.b The end-effector shall attach to the manipulator using screws configured in a pattern that can accommodate a Dynamixel AX-12A servo.
It is expected a majority of end-effectors will be actuated by a servo, therefore a specific servo’s mounting pattern was chosen to standardize the mounting.

### 2.1.8 The system shall be able to write with a low-odor chisel tip Expo dry

erase marker.

2.1.8.a The end-effector shall be able to support 0.004 Newton meter moments about the axes normal to its gripping surfaces.
The coefficient of friction between the Expo marker and paper can be approximated and given the weight of an Expo marker the approximate moments acting on the end-effector can be calculated.

### 2.2 Software

The following requirements and specifications are software specific and determine the attributes of the operating system.

2.2.1 The system shall be open source.

Open source software creates an easily obtainable, low cost method of distributing the system’s source code, which may be modified for personal use.
2.2.1.a The software shall be hosted publicly on an online repository and maintain an MIT license for distribution.

An MIT license allows the end-user to freely download and modify the code without licensing. The MIT does not legally obligate the original author maintain the code and documentation.

### 2.2.2 The system shall be capable of operating given only desired end-effector

cartesian coordinates specified with respect to the base frame.

2.2.2.a The system shall have a user interface capable of accepting the end-effector’s desired cartesian position and Euler angle orientation as a six element row vector.
The system software interface allows an untrained user to operate the manipulator without advanced knowledge of the system’s kinematics.
2.2.2.b The system shall be capable of performing floating point arithmetic.
The solution for the inverse kinematics requires high level arithmetic to be preformed with little error.

## Appendix

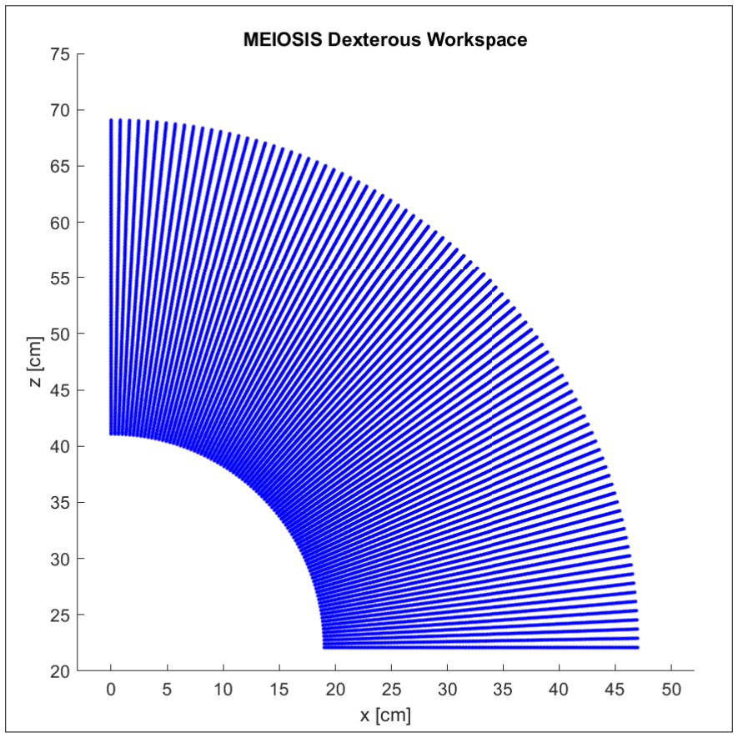
[picture p34: figure]

Figure 4: Cross Section of Dexterous Workspace Quadrant

The plot shown in Figure 4 exhibits a cross-section of the dexterous workspace defined by requirement 2.1.6 and shows how specification 2.1.6.a was calculated. The MATLAB script that created this plot was made to show red points where the robot is not fully dexterous and the lack of red dots shows that the robot is fully dexterous within the calculated area. This also drives specification 2.1.2.b as the workspace would have red points with a link offset.

# References

[1] S. Hutchinson M. Spong and M. Vidyasager. Robot Modeling and Control. 2006.
