treydufrene/meiosis_dev/LaTeX/cdr/cdr.pdf

## Detailed Design Report

Trey Dufrene | Zack Johnson | David Orcutt | Alan Wallingford | Ryan Warner

Submitted in Partial Fulfillment of the Requirements of:

ME420 Detailed Design of Robotic Systems – Spring 2020

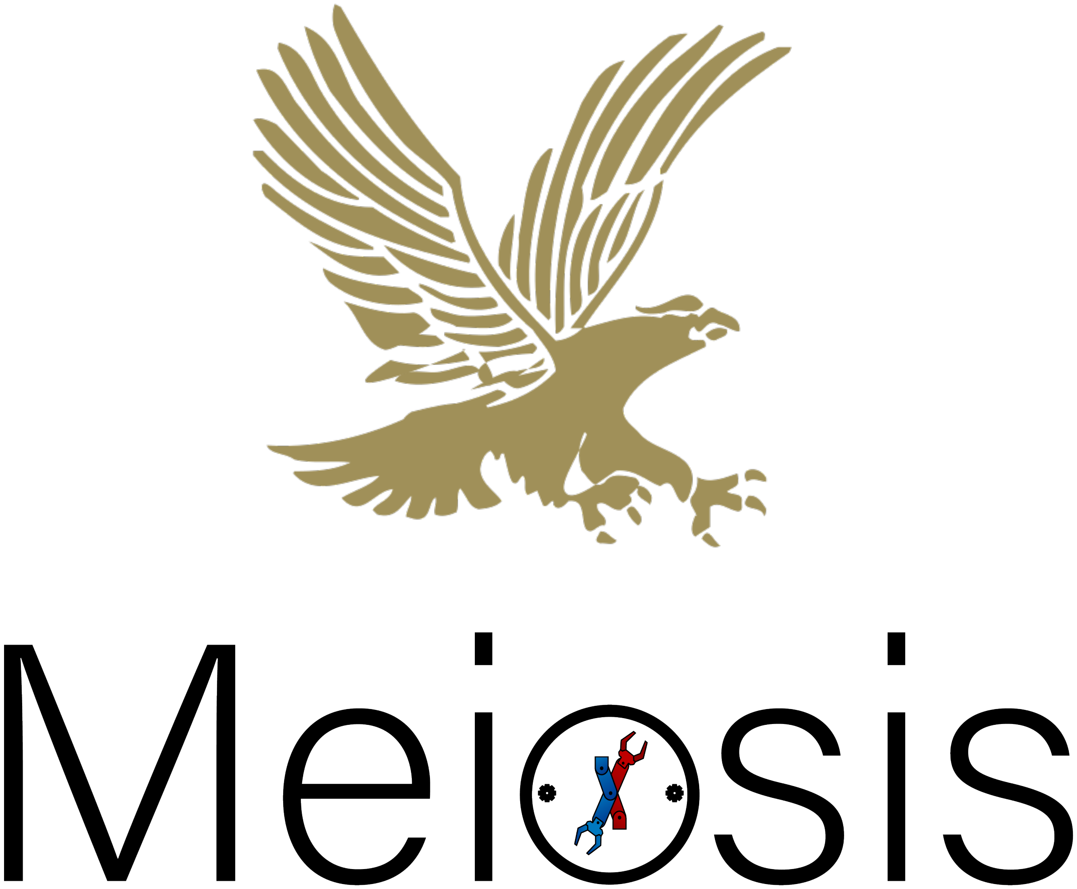
[picture p36: figure]

College of Engineering
Embry-Riddle Aeronautical University Prescott, AZ

Abstract

The Manipulator for Educational Institutions with Open Source Integrated Systems (MEIO-SIS) aims to increase the accessibility of robotics to secondary educational institutions and hobbyists. Accordantly, the manipulator is 3D printed in PLA with aluminum tube supports and costs the end-user less than $1000. The manipulator has six links and a base. The base houses a Raspberry Pi 3B and power supply. The Raspberry Pi controls seven Dynamixel smart servos with position feedback and proportional derivative control. Six MX-12W servos actuate six rotational joints, while one AX-12A servo actuates the removable end-effector. They provide the manipulator a position repeatability within 2mm of the previous pose. The manipulator can draw as well as perform pick and place operations within its dexterous workspace which is a hemispherical sub-shell of the reachable workspace of 280 mm thickness. The manipulator’s operation is controlled by open-source software.

# Contents

i

# List of Figures

1 | Harmonic Gearbox Locations | | 1
2 | ExplodedViewoftheHarmonicGearbox | | 2
3 | Motor Locations and Orientations | | 5
4 | Closed-Loop Control Simulation Animation Snapshots | | 7
5 | Joint Angles vs Time in Closed-Loop Simulation | | 7
6 | T-Bar ANSYS FEA | | 8
7 | ANSYS Simulated Forces Image Capture | | 9
8 | ANSYS FEA of Dynamical Loading Scenario | | 10
9 | ANSYS Fatigue Test | | 10
10 | Software Flowchart | | 13

ii

# List of Tables

1 | MEIOSIS Bill of Materials with Costs | | 12
2 | End-User Bill of Materials with Costs | | 12

iii

## List Of Acronyms and Abbreviations

FK : Forward Kinematics
IK : Inverse Kinematics
PD : Proportional Derivative

## Notation

Frame
From | r To | : Direction Vectors
From T To | : Direction Cosine (Transformation) Matrices
| cθnm | : cos(θn + θm)
| sθnm | : sin(θn + θm)

iv

## Preliminary and Detailed Design

## 1 Electrical System

## 2 Mechanical System

Description of Mechanical Design

One of the main differences between the conceptual mechanical design and the final design is the inclusion of 3D-printed harmonic gearboxes. The previous designs utilized a combination of standard spur gears and timing belts. It was determined that neither of these options provided the necessary precision without also introducing backlash into the system, which is nearly impossible to correct for with our feedback configuration. The solution was to design and implement a harmonic drive system. The harmonic gearbox locations are shown below in Figure 1

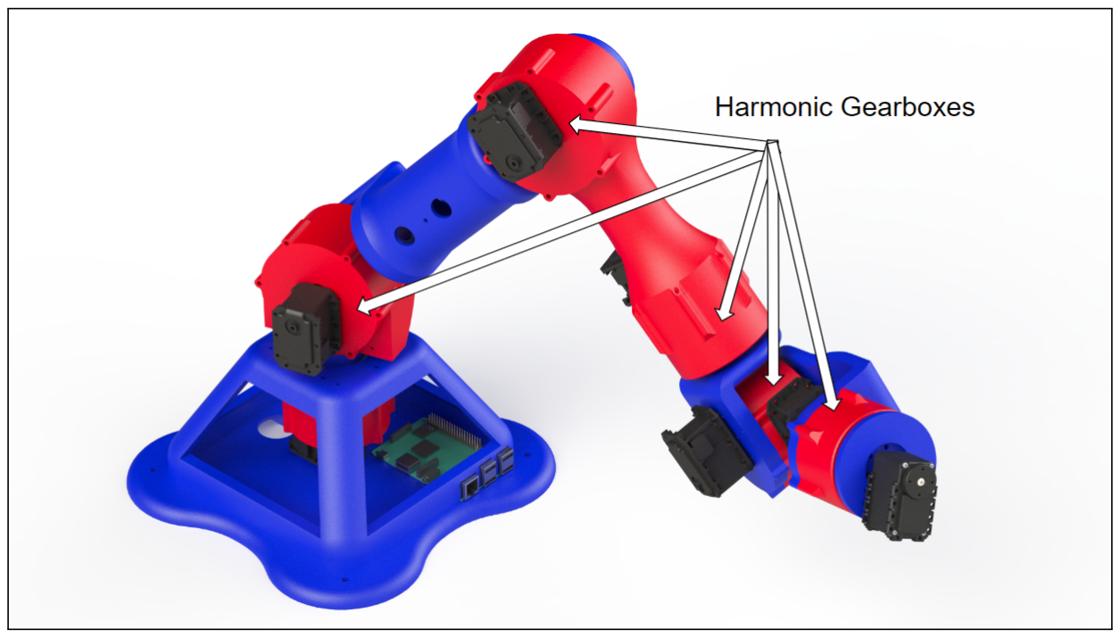
[picture p37: figure]

Figure 1: Harmonic Gearbox Locations

As seen in Figure 1, each joint only requires a single actuator, which is a configuration not seen in the previous design. This is possible because harmonic drives allow for very high gear ratios with minimal backlash. The first prototype harmonic drive was provided by a posting on Thingiverse [citation]. This design was meant to be driven by a stepper motor and provided a gear ratio of 39:1. However, the gearboxes implemented in the manipulator need to be driven by a smart servo. Because the smart servo cannot drive as fast as a stepper motor, the ratio of 39:1 resulted in joint movement that was extremely slow. Additionally, given the link lengths and precision of the servos, only a gear ratio of 20:1 was necessary to meet the precision requirements of the system. For these reasons, a second harmonic drive was designed to provide the proper gear ratio of 20:1. Figure 2 provides an exploded view of the main structural components of the newest harmonic drive.

As seen in Figure 2, the basic harmonic drive design features an outer housing, a stiff output shaft, a flexible gear, and a bearing holder assembly. When fully assembled, the bearing

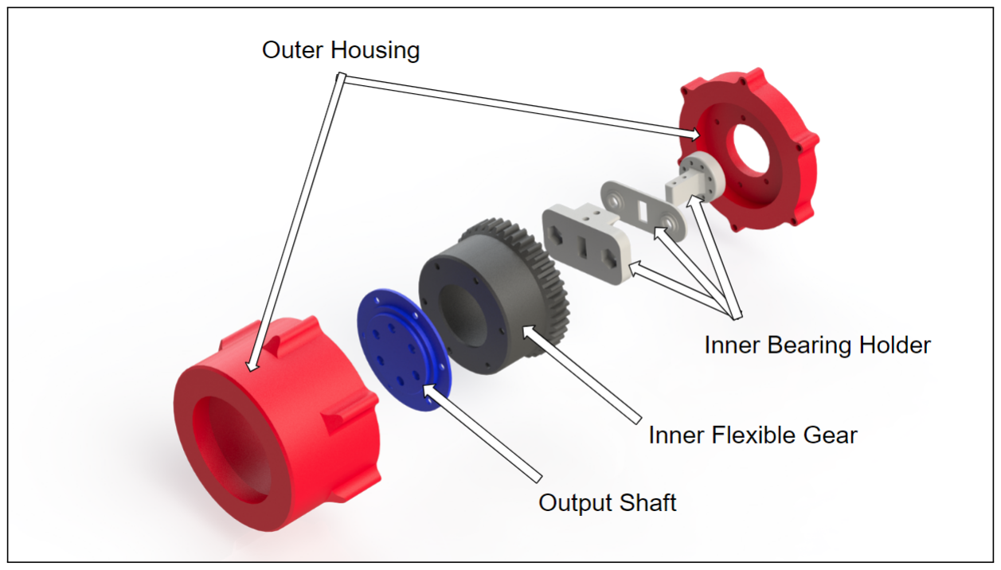
[picture p38: figure]

Figure 2: ExplodedViewoftheHarmonicGearbox

holder sits on the inside of the flexible gear. As the servo drives the inner bearing holder, a continuous meshing of teeth occurs between the flexible gear and the set of teeth that are built into the outer housing. Because the inner set of teeth has two less teeth than the outer set (the inside has 40 while the outside has 42), the inner gear will move forward by two teeth per rotation of the bearing holder. This results in 1/20th of a rotation of the flexible gear per full rotation of the bearing holder. With the output shaft being attached to the flexible gear, the whole harmonic drive provides a ratio of 20:1.

Equations of Motion

Given robot dynamics described by H(γ)¨γ + d(γ, γ˙) + G(γ) = Fγ, the equations of motion for the manipulator can be determined. Solving this equation for the acceleration, γ¨, gives:

γ¨ = H(γ)

−1
(Fγ − d(γ, γ˙) − G(γ)) | (1)

Where H is the system mass matrix, Fγ is the vector of generalized forces, d is the vector of centripital and coriolis effects, and G is gravitational effects.

H(γ) = X

N

B

JB(γ)

T

B

BJ S˚(
B

BΓ)IT

T
B

ITBS˚(
B
BΓ)T | mBI

- JB(γ) ,

B

BΓ =B

B rcmmb , S˚(ω)r = (ω × r)

d(γ, γ˙) = X

N

B

JB(γ)

T

B

BJ S˚(
B

BΓ)IT

T
B

ITBS˚(
B
BΓ)T | mBI

- J˙
B(γ, γ˙) ˙γ+JB(γ)

T

B

BωI ×B
B J

B
B ωI

ITB

B
BωI × (

B
BωI ×B

B Γ)

G(γ) =

∂U(

I
r(γ))
∂γ | !T
, | UB =

h
0 0 g

i I
BrBmB +

I TB

B
BΓ

Where JB is the jacobian of the body, Γ is the vector of first mass moments, mB is the mass of the body, and B
BωI is the rotational velocity of the body relative to the inertial frame.

Actuator Dynamics

Given robot dynamics described by H(γ)¨γ + n(γ, γ˙) = τ , the torque, τ , provided by the servo motors is necessary to solve the closed loop dynamics of the system. Assuming the servo is driven by a D.C. motor with proportional derivative control,

τa = Kia = Ja

¨θa + ba

˙θa + τL | (2)

Where τa is the actuator torque, K is the back-EMF constant, ia is the motor current, Ja is the armature inertia, θa,

˙θa,

¨θa is the motor position and it’s first and second time derivatives respectively, ba is the viscous friction coefficient, and τL is the torque available for the actuator to do work. The basic equation for a motor is known to be:

Va = iaRa + K ˙θa | (3)

Where Va is the voltage applied to the actuator and Ra is the armature resistance. Given a gearbox with in/out ratio N and efficiency η,

θa

τin

θ =

θa
N
τout = τinNη N

The motor equation (2) can be expressed in the output coordinates:

Kia = JaN ¨θ + baN ˙θ +

τ
Nη

Substituing into equation (3) and solving for ia:

ia =

JaN
K

¨θ + baN ˙θ +

τ
Nη

Va =

RaJaN
K

¨θ +

RabaN
K

˙θ +

Ra
KNη
τ + KN ˙θ | (4)

Assuming PD control, Va = Kp(θ − θd) + Kd

˙θ, where θd is the desired orientation of the actuator, the following solution is found by setting the PD solution equal to equation (4). After collecting like terms:

RaJaN
K

¨θ +

RaJaN
K

− Kd + KN
˙θ − Kpθ = −Kpθd −

Ra
KNη
τ | (5)

The following parameters of the system can be obtained by applying a step input to the system with τ = 0 and measuring the characteristics of it’s response. Denoting ζ as the damping ratio and ωn as the natural frequency of the system,

% Overshoot =

θmax − θss

θss | !
× 100 , | ζ =

− ln(%OS/100)
q
π

2 + ln²
(%OS/100)

, ωn =

π
Tp

√
1 − ζ
2

Given θmax, θss, and Tp as measured parameters of the system’s max output, steady state, and time to peak, respectively.

Refactoring equation (5) and equating with the general solution for a second order system given by ¨θ + 2ζωn

˙θ + ω
2
n

θ = ω

2
n

θd, the following solutions are found:

2ζωn =

ba
Ja

−

KKd
RaJaN

+

K²
RaJa
(6) ω

2
n =

−KKp
RaJaN

(7)

Performing a similar experiment as previously described, except with a known inertial load τ = Jm

¨θ, the following parameters can be found:

αm ≡ 2ζωn =

RabaN²

η − KKdNη + K²N²
η
RaJaN²η + RaJm

, βm ≡ ωn = −

KKpNη
RaJaN²η + RaJm

1 −(α1J1 + β1J1)
1 −(α2J2 + β2J2)

RabaN²

η − KKdNη + K²N²
| η − KKpNη
RaJaN²η

1
JaN²η

=

α1 + β1
α2 + β2

(8)

With multiple datasets (varying inertial loads, Jm), the solutions of equation (8) can be found using the least-squares method, yeilding

RabaN − KKd + K²Nη − KKp
RaJaN

(9)

1
JaN²η

(10)

Finally, the coefficients of the second order system (11) are known:

JaN

2
η

!

| | {z | }
1⁄(10) = C1

¨θ +

RabaN²

η − KKdNη + K²N²
η
Ra

!

| | {z | }
(6)⁄(10) = C2

˙θ −

KKpNη
Ra

| | {z | }
(7)⁄(10) = C3

θ +

KKpNη
Ra

| | {z | }
(7)⁄(10) = C3

θd = −τ

(11)
The MATLAB code implementing this process can be found in the Appendix (see section 3,
p. 20, Listing 3). The torque provided by the servo can now be solved for, given the current position (θ), velocity ( ˙θ), angular acceleration (¨θ), and desired position (θd) are known.

Given the equation of motion for the dynamical response of the system (1), substituting in the solution obtained for the motor dynamics and solving for the acceleration,
H + JaN

2
η

−1

" B −
RabaN²

η − KKdNη + K²N²
η
Ra

!
γ˙ −

KKpNη
Ra
(γd − γ) − n
= ¨γ

Where
n(γ, γ˙) = d(γ, γ˙) + G(γ) + Csgn( ˙γ)

The motor equation (11) gives an expression for the motor torques, however the system dynamics are defined in terms of geometric joint angles. The inclusion of differential drive systems means that the joint angles, γ, do not directly correspond to motor rotations, θ, as shown in Figure 3.

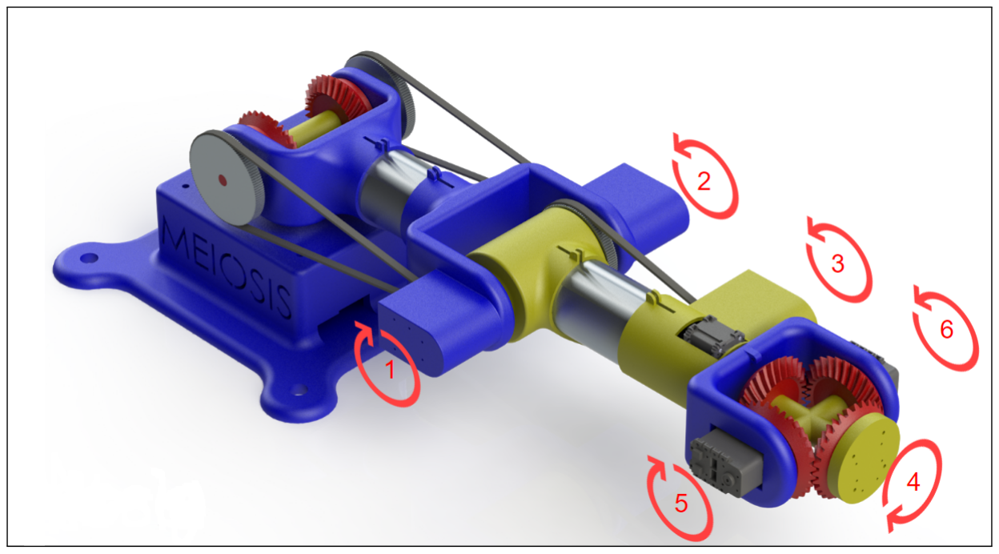
[picture p39: figure]

Figure 3: Motor Locations and Orientations

Figure 3 shows the motor positions and relative orientations. This layout was used to define

a linear relation between the joint angles and the motor rotations, described in equation (12).

γ = Aθ where A =

1/(2N) | 1/(2N) | 0 | 0 | 0 | 0
1/(2N) −1/(2N) | 0 | 0 | 0 | 0
0 | 0 | −1/N 0 | 0 | 0
0 | 0 | 0 | 1 | 0 | 0
0 | 0 | 0 | 0 −1/2 1/2
0 | 0 | 0 | 0 | 1/2 | 1/2

(12)

Equation (12) can be used to map the joint angles to the motor angles. The gear ratio of 1:10 is represented by the variable N. Similarly, the motor angles can be determined by multiplying both sides of equation (12) by the inverse of matrix A, giving the following relation.
θ = A

−1
γ | (13)

It is important to note that the virtual work done by the joint torques (Fγ) and the virtual work done by the motor torques (Fθ) are equal. Using equation (13), a linear relation between the joint torques and motor torques can be determined.

δW = F

T
θ

δθ = F

T
γ

δγ, where δγ = Aδθ

F

T
θ

δθ = F

T
γ

(Aδθ)

F

T
θ = F

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
Fθ = A

TFγ ⇔ Fγ = A

−TFθ

Using this equation, a relation can be determined between the motor dynamics and the system dynamics given in equation (11) and equation (1) respectively.

H(γ)¨γ + d(γ, γ˙) + G(γ) = −A

−T

C1A

−1
γ¨ + C2A

−1
γ˙ + C3θd − C3A

−1
γ

γ¨ = H(γ)

−1

−A

−T

C1A

−1
γ¨ + C2A

−1
γ˙ + C3θd − C3A

−1
γ
− d(γ, γ˙) − G(γ)
(14)

Because this equation includes the motor model, which in turn includes an internal PD controller, this equation can be integrated to solve for the system response given a desired motor angle input, θd. However, doing so will not result in the desired system response. This control scheme does not have any compensation for the inertia of the links, and it is also lacking gravity compensation. This can be remedied by modifying the input to the motors, θd. A new input, u, is defined such that gravity can be compensated. Thus, the motor input term in equation (14) must include both compensation for gravity and the desired motor angle.
A

−T C3u = G(γ) + d(γ, γ˙) + A

−T C3θd

u =

A

−T C3

−1
(G(γ) + d(γ, γ˙)) + θd | (15)

With this new motor input, the closed loop control system equations of motion are given as:

γ¨ = H(γ)

−1

−A

−T

C1A

−1
γ¨ + C2A

−1
γ˙ + C3u − C3A

−1
γ
− d(γ, γ˙) − G(γ)
| (16)

Equation (16) can then be integrated to solve for the system response given desired motor angles.

ANSYS

With 100% infill, 3D printed PLA has a maximum shear stress of 13.6 kpsi. The manipulator applies a load of 13N in the negative y-direction. Without gears in the base differential, the differential support would bear the load on its bearing mounts. Figure 6 shows the

manipulator’s differential support could experience up to 97 kPa or 0.014 kpsi of shear stress, which is less than the maximum shear stress of PLA with 100% infill. Since some of the manipulator’s mass is supported by the gears, the actual shear experienced by the differential support will be less.

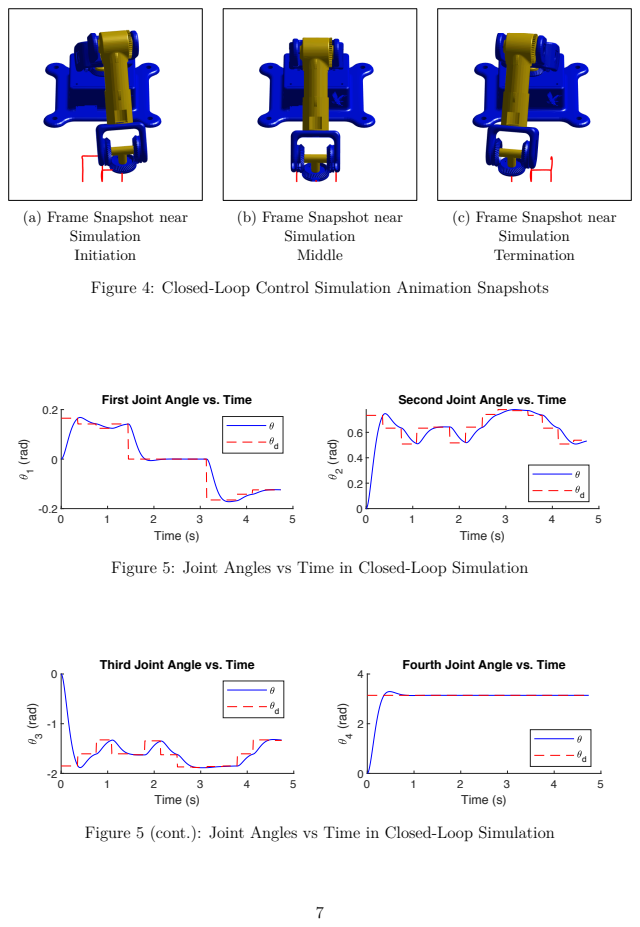
[picture p40: page 13]
Simulation Initiation; Simulation Middle; Simulation Termination; Time (s); 1 (rad); 2 (rad); 3 (rad); 4 (rad); Figure 5 (cont.): Joint Angles vs Time; in Closed-Loop Simulation

(a) Frame Snapshot near

(b) Frame Snapshot near

(c) Frame Snapshot near

Figure 4: Closed-Loop Control Simulation Animation Snapshots

First Joint Angle vs. Time

Second Joint Angle vs. Time

Figure 5: Joint Angles vs Time in Closed-Loop Simulation

Third Joint Angle vs. Time

Fourth Joint Angle vs. Time

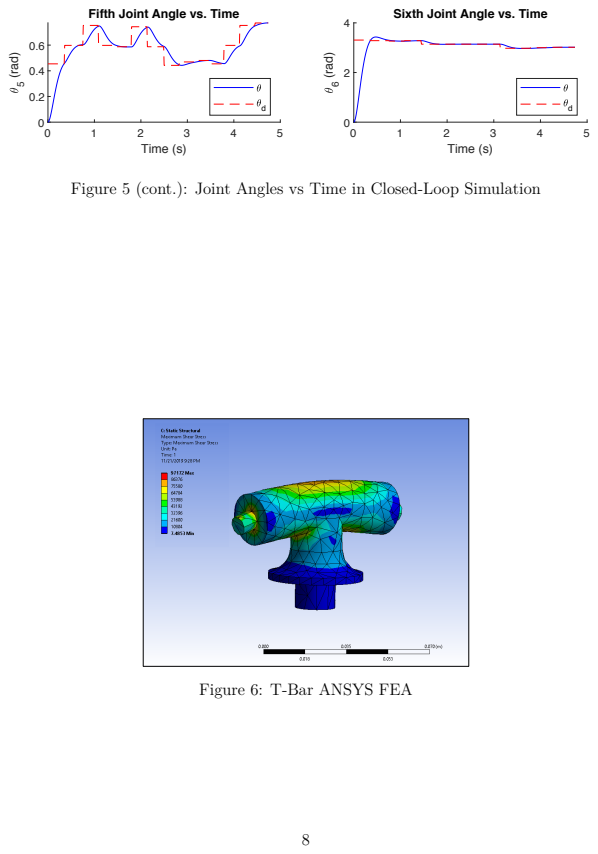
[picture p41: page 14]
Time (s); 5 (rad); 6 (rad)

Fifth Joint Angle vs. Time

Sixth Joint Angle vs. Time

Figure 5 (cont.): Joint Angles vs Time in Closed-Loop Simulation

Figure 6: T-Bar ANSYS FEA

To simulate a dynamical loading situation where the manipulator would be under the largest amount of stress, gravitational forces and an outward force (parallel to the arm direction in it’s zeroed configuration) were applied to the structure. This situation represents the worst-case loading scenario, such as the manipulator swinging while outstretched. The supports and simulated forces can be seen in the ANSYS image capture shown in Figure 7.


Figure 7: ANSYS Simulated Forces Image Capture

As shown in Figure 7, the red arrow is the outward force simulating centrifugal forces, the

yellow arrow represents gravity acting at the manipulator’s center of mass, and the yellow highlighted faces show the fixed support at the base.

The dynamical loadings resulted in a maximum shear stress at the shoulder differential bearing, as seen in Figure 8a; a close-up image of the bearing analysis can be seen in Figure
8b.

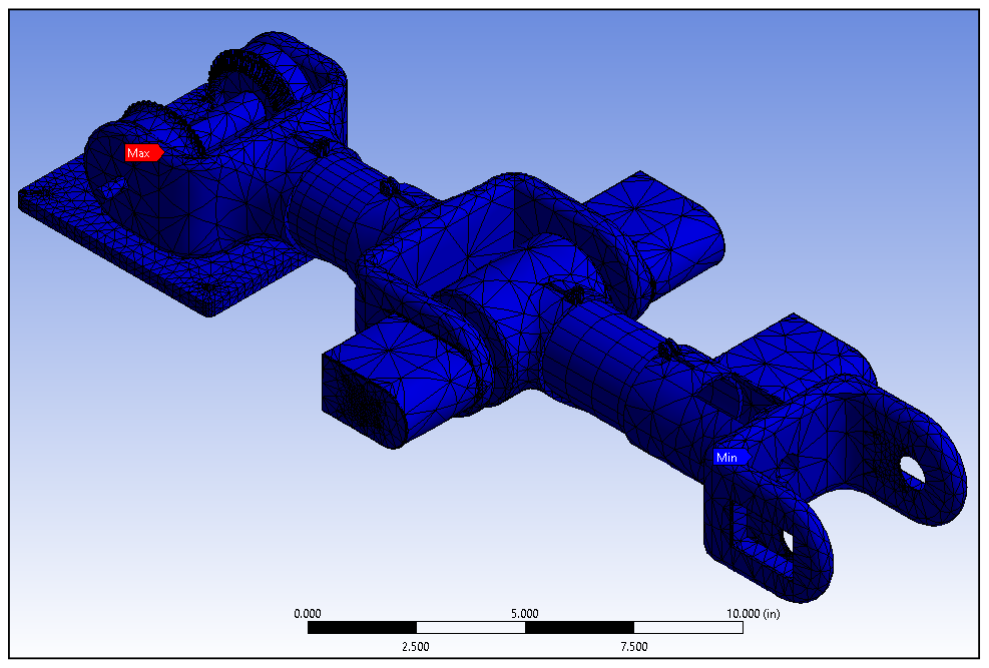
[picture p42: figure]

(a) ANSYS Full View of Maximum Shear | (b) ANSYS Bearing Shear Stress Close-up

Figure 8: ANSYS FEA of Dynamical Loading Scenario

To further validate that the structure is capable of handling alternating stresses, a fatigue test was also performed showing the life of the manipulator handles a minimum of 1e6 cycles, as seen in Figure 9, showing it is unlikely to fail due to material yeilding.

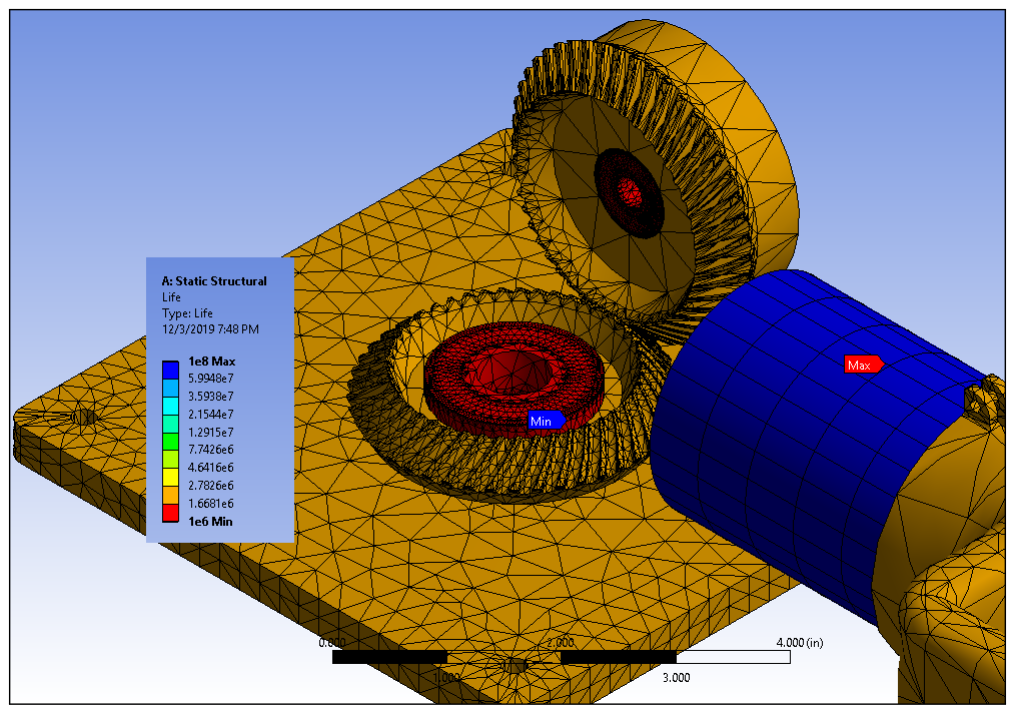
[picture p43: figure]

Figure 9: ANSYS Fatigue Test

As seen in Figure 9, the lower bearing of the differential drive on the shoulder of the manip-

ulator would be the most likely component to fail under repeating loadings.

Parts list and budget

Parts List

Table 1 lists the parts MEIOSIS will require to build the manipulator. The total cost is $629.22, including shipping. Specification 1.1b requires MEIOSOS’s cost to develop the manipulator be less than $800. In addition to pulley belts for the current configuration, Table 1 allocates $20 for two additional belt sizes to increase joint 1/2’s and joint 3’s torque

by a factor of 10. The belts must be purchased in packs of 3 from Automation Direct and two more belt sizes may be required for the two pulley design to allow the servos to be mounted without interfering with the base. Table 1 also accounts for increased cable lengths of 500

mm to communication bus signals from motor 2 to 3 and motor 3 to 4. And cable lengths of 350 mm to communication bus signals from motor 5 to 6. Motors are identified in [MOTOR ORIENTATION FIGURE]. Aside from electronic hardware, Table 2 for physical hardware. To allow screw mounting in plastic with metal threads, Table 2 accounts for 100 threaded

press-fit inserts. The manipulator will require between 21 and 46 inserts.The majority of inserts attach MX-12W servos to the manipulator. Mounting hardware accompanies each servo. Since purchasing six sets of pulleys would put MEIOSIS over the $800 budget, they are printed.

In addition to the costs listed in Table 1, Table 2 shows further costs for the end-user

highlighted in blue. Since the Embry Riddle robotics lab has 3D printing available without affecting MEIOSIS’s $800 budget, Table 2 accounts for outsourced 3D printing costs sufficient

to print the entire manipulator with six sets of pulleys. If the end-user owns a 3D printer, the 3D printing cost would effectively reduce to filament cost. Additionally, Table 2 assumes

the end-user does not already possess an AX-12A servo to be used with the end-effector. Further, Table 2 assumes the manipulator would be more accessible to end-users by using a

proprietary U2D2 communication module in lieu of a soldered or bread-board circuit. The robotics lab has an AX-12A servo and U2D2 communication module MEIOSIS will use. With the aforementioned additional costs, the MEIOSIS manipulator costs the end-user $1,007.98 including shipping costs. While $1,007.98 is slightly above the maximum cost of $1000 from specification 1.1a, it provides greater accessibility, which may be diminished by assuming end-users poses 3D printers.

Table 1: MEIOSIS Bill of Materials with Costs

Part | Retailer | Quantity | Unit Cost (USD) | Total Cost (USD)

3 pack, 300 tooth

| Automation Direct | 1 | 11.5 | 11.5
3 pack, 208 tooth | | 1 | 9.5 | 28.5
Base second belts | | 1 | 10 | 10
Link 3 second belts | | 1 | 10 | 10
MX-12W
| Trossen Robotics | 6 | 65.9 | 395.4
500 mm, 1/2 pulleys | | 2 | 3.95 | 7.9
350 mm, 3 pulley | | 1 | 2.95 | 2.95
EE | | 1 | 24.95 | 24.95
Pi 3 B | Amazon | 1 | 37.99 | 37.99
Bearings | | 1 | 8.99 | 8.99
2 Sch 10 12" Al tube | Industrial Metal Sales | 1 | 2.99 | 2.99
12 V, 5 V power supply | Digi-Key Electronics | 1 | 43.21 | 43.21

Automation Direct

| Shipping | — | — | 0
Trossen Robotics | | | | 13.15
Amazon | | | | 0
Industrial Metal Sales | | | | 26.36
Digi-Key | | | | 8.99
| | | Total | 629.22

Table 2: End-User Bill of Materials with Costs

Part | Retailer | Quantity | Unit Cost
| | | (USD)

Total Cost
(USD)
Aforementioned
Costs | Table 1 | — | —

629.22

U2D2

Trossen
Robotics | 1 | 49.9 | 49.9

EE with servo

Trossen
Robotics | 1 | 64.95 | 64.95

3D PLA
outsourcing
(incl. shipping)
Craft Cloud | 1 | 288.86 | 288.86
Total | 1007.98

## 3 Software

Flowcharts

The software the system will need will take in a row vector of position, orientation, path type, and end effector function information for all points to be traveled through and run the manipulator through the desired points following the specified paths requested. To do this, the user will first be asked what the number of points being input will be so that a few data structures can be preallocated. The user will then be asked if the manipulator will be writing or doing pick and place, and store the response. If the user is doing pick and place, the user will be asked for the full point data consisting of the x, y, and z location in millimeters, the phi, theta, and psi angles in degrees, the path type, and the end effector function. If the user is doing writing, only the x, y, and z locations will be requested. The orientation of the point will be defaulted in the “down” orientation since the marker will be held vertically, the path type will be set to cartesian straight line, and the end effector function will be set to stay unchanged. When all the desired points have been input, the software will then create intermediate points every centimeter between points whose paths are specified as cartesian straight line and store the new path points in a different data structure. After the path has been created, each point will be run through inverse kinematics to get the required joint angles to achieve the position and will be stored as the motor data for each point. If the user is writing with the manipulator, the user will be prompted to press a key to close the end effector to grab the marker. The user will then be prompted to press a key to begin, at which point the software will send the motor data to each servo for the first point that the system is trying to reach, wait till the servos are in the desired position, run the end effector function if there is one, and then repeat the process with the next set of motor data until all the points have been traveled through. When the last point has been reached, the program will prompt the user to input the number of desired points and wait for the input to start the process over again. The software the system uses takes in a row vector of position, orientation, path type, and end effector function information for all points to be traveled through and runs the manipulator through the desired points following the specified paths requested. The general overview of the code is shown in Figure 10.

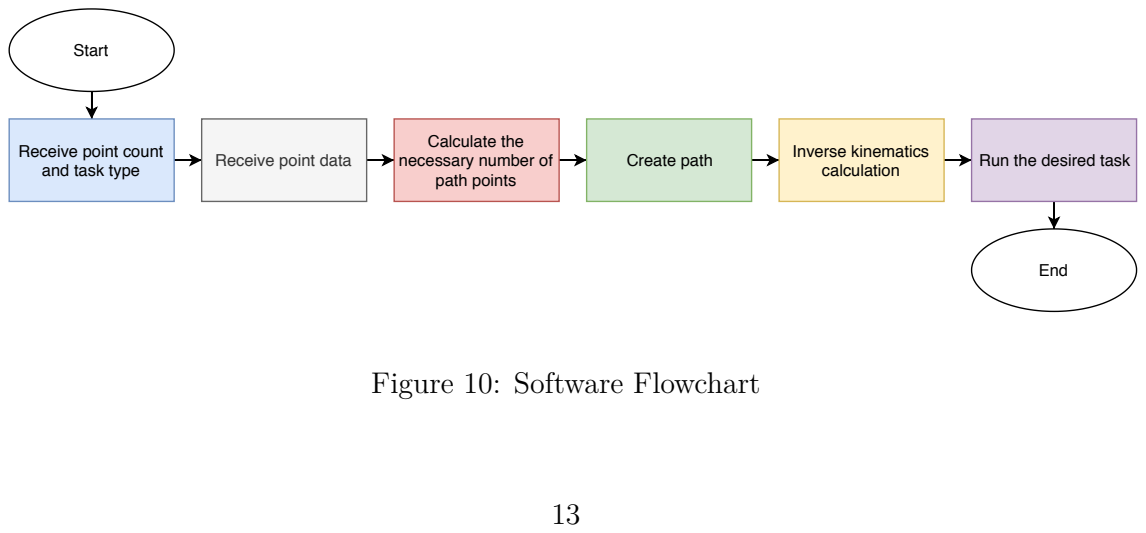
[picture p44: figure]
Start; Receive point count; and task type; Receive point data; Calculate the necessary number of path points; Create path; Inverse kinematics; calculation; Run the desired task; End; Figure 10: Software Flowchart

Figure 10 shows that the software for the manipulator is broken up into six subsections, two

sections that receive data, three that do calculations, and one that runs the specified task.

The first subsection of the software works to receive the number of points the user is inputting as well as the general task the user is completing, shown in Figure 10a.

Task definition
"c"

Writing or pick and
place?

Ask user for number
of points being input

Receive point
count "x"

pointCount=x
currentPoint=0
pointData=zeros(8,x)
i = 1

intPts =
zeros(1,pointCount)

Figure 10a: Software Flowchart Subsection 1

Figure 10a specifies that the software prompts the user for the number of points that the

manipulator will travel through and stores the input as a variable, in this case ‘x’. The ‘x’ variable is only used to help preallocate data vectors so that the size of the vector does not change with each input. The software also receives the task specification as either a 0 for cartesian straight line pathing or a 1 for a straight line in the joint space and stores this value in the variable ‘c’.

The second general block in the software flowchart works to receive and store the necessary data for the points the user is inputting depending on the path type as seen in Figure 10b.

Evaluate "c"

Ask user for point i
position, orientation,
and path type

currentPoint =
pointCount?

Receive point
information "y"

pointData(:,i) = y
currentPoint++
i++

Ask user for point i
position

currentPoint =
pointCount?

Receive point
information "y"

pointData(1:3,i) = y
pointData(4:6,i) =
"down"
pointData(7:8,i) = 0

currentPoint++
i++

i = 2

Writing
0

Pick and
Place
1

Y

Y

N

N

Figure 10b: Software Flowchart Subsection 2

Figure 10b shows that the path type variable ‘c’ is used to determine what information is

necessary to collect. If the user is doing a writing task, the software only collects the x, y, and z distances for the point and assumes that the end effector orientation will be facing down so that the marker is vertical. If the user is doing pick and place, the software prompts the user for the x, y, z, phi, theta, psi, path type, and end effector data. The software loops until all the points have been input.

The next block in the software flowchart calculates the total points necessary to complete the task. The overview for this section can be seen in Figure 10c.

Evaluate
pointData(7,i)

Calculate magnitude
of distance between
pointData(1:3,i-1)
and pointData(1:3,i)

Divide distance by
10, round down to
nearest whole
number "x"

intPts(i) = x

i++ | i = pointCount?

newPts =
zeros(8,L)
i = 2
k = 2

L = sum(intPts) +
pointCount

1

N | Y

0

Figure 10c: Software Flowchart Subsection 3

As seen in Figure 10c, the section of software calculates the distance between the current

point and the previous point if the path type is cartesian straight line and divides the distance by ten to find the number of centimeters between the two points. This value is stored as the necessary number of intermediate points, and the software will loop through until every point has been checked. The section of code also stores the total number of points that will be used as the variable level for later use.

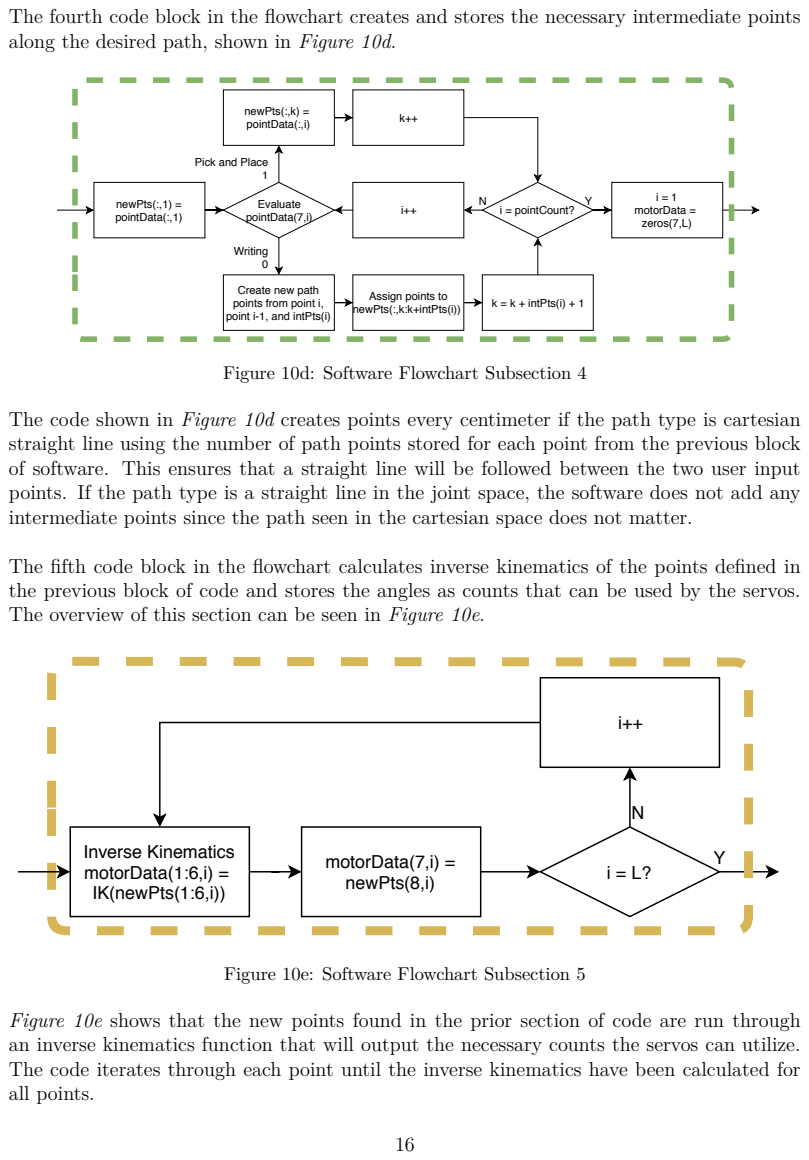
[picture p45: page 22]
newPts(:,1) = pointData(:,1); Evaluate pointData(7,i); newPts(:,k) = pointData(:,i); newPts(:,k:k+intPts(i)); k = k + intPts(i) + 1; i = pointCount?; i = 1 motorData = zeros(7,L); Writing 0; Inverse Kinematics motorData(1:6,i) = IK(newPts(1:6,i)); motorData(7,i) =; newPts(8,i)

The fourth code block in the flowchart creates and stores the necessary intermediate points
along the desired path, shown in Figure 10d.

Pick and Place

Create new path
points from point i,
point i-1, and intPts(i)

Assign points to

Figure 10d: Software Flowchart Subsection 4

The code shown in Figure 10d creates points every centimeter if the path type is cartesian
straight line using the number of path points stored for each point from the previous block
of software. This ensures that a straight line will be followed between the two user input
points. If the path type is a straight line in the joint space, the software does not add any
intermediate points since the path seen in the cartesian space does not matter.

The fifth code block in the flowchart calculates inverse kinematics of the points defined in
the previous block of code and stores the angles as counts that can be used by the servos.
The overview of this section can be seen in Figure 10e.

Figure 10e: Software Flowchart Subsection 5

Figure 10e shows that the new points found in the prior section of code are run through
an inverse kinematics function that will output the necessary counts the servos can utilize.
The code iterates through each point until the inverse kinematics have been calculated for
all points.

The final block in the software diagram runs the manipulator through the desired task, with this section of code requiring user input at certain stages depending on the path type, seen
in Figure 10f.

Evaluate "c"

Prompt user to press
"space" to grab
marker

Close end effector

i = 1
Prompt user to begin

Send newPoints(:,i)
to motors

i = pointCount?

Are motors at | i++
correct angle?
User input | End effector function

0

1

Y

N

Y

N

User input

Figure 10f: Software Flowchart Subsection 6

The code in Figure 10f prompts the user to press space to close the end effector and grab

the marker if drawing was the specified task, otherwise the software jumps straight into prompting the user to begin the task, and when the user begins the task the counts for each position are sent to the servos one at a time. The counts for the next position are not sent to the servos until the servos have reached the desired positions and the end effector function has been completed if there is one.

Description of control system

Implementation

The implementation of the software control algorithm described in the software flowcharts was not able to be finished to completion, although the basic control scheme of the manipulator was established with Python scripts. The MATLAB code written for simulation of the manipulator, such as the inverse kinematics calculations, were converted to Python and successfully implemented. Since only two joints of the manipulator were written, a two link inverse kinematics function was implemented as well as servo control algorithms to ease future programming. Snippets of the servo control scheme as well as the two link arm inverse kinematics can be seen in Listings 1 & 2.

Listing 1: twolink.py
def twoLinkIK ( x , y ) :

l 1 = 265.0
l 2 = 165.0
D = ( x∗∗2 + y∗∗2 − l 1 ∗∗2 − l 2 ∗∗2 )/ (2∗ l 1 ∗ l 2 )
t h e ta2 = atan2 ( s q r t ( 1 . 0 − D∗∗2 ) ,D)
t h e ta1 = atan2 ( y , x ) − atan2 ( l 2 ∗ s i n ( t h e ta2 ) , l 1+l 2 ∗ co s ( t h e ta2 ) ) pr int ( d e g r e e s ( t h e ta1 ) , d e g r e e s ( t h e ta2 ) )
return [ d e g r e e s ( t h e ta1 ) , d e g r e e s ( t h e ta2 ) ]

The meiosis_servo.py file contains several methods composed in an attempt to simplify and expedite future programming.

Listing 2: meiosis_servo.py

## ! / u s r / b i n / env py thon # −∗− c o d i ng : u t f −8 −∗−

## " " " b a s i c r e a d a b l e s e r v o commands " " "

from dynamixel_sdk import ∗
def setJA ( s e l f , IDLIST , a ngl e ) : i f ( type ( IDLIST ) == int ) : IDLIST = [ IDLIST ]
i f ( type ( a ngl e ) == int ) :
a ngl e = [ a ngl e ]
for i in range ( 0 , len ( IDLIST ) ) :
s e l f . s e tPo s ( IDLIST [ i ] , int (round( a ngl e [ i ] ∗ g e a ri d x [ i ] . . . + o f f s e t [ i ] ) ) )
pr int ( int (round( a ngl e [ i ] ∗ g e a ri d x [ i ] + o f f s e t [ i ] ) ) )

The setJA method shown above is an example of how a basic function needed for future programming was methodically created in an attempt to ease the burden of the final manipulator implementation. All methods were created with versatility in mind; the testing performed was limited to a two link manipulator since that is all that was physically available, but the underlying programming would remain very similar when all six joints were physically implemented.

# References

[1] Trossen robotics. URL https:// www.trossenrobotics.com/ .
[2] Embry-riddle aeronautical university-prescott. URL https:// www.
collegetuitioncompare.com/ edu/ 104586/ embry-riddle-aeronautical-university-prescott/ .
[3] Range of robot cost – robot system cost series. URL
https:// motioncontrolsrobotics.com/ range-robot-cost/ .
[4] Sawyer: Rethink robotics unveils new robot. URL https:// spectrum.ieee.org/
automaton/ robotics/ industrial-robots/ sawyer-rethink-robotics-new-robot.
[5] Pla density. URL
https:// all3dp.com/ 2/ pla-density-what-s-the-density-of-pla-filament-plastic/ .
[6] Michael Zeltkevic 1. Runge-kutta methods, 04 1998. URL http:// web.mit.edu/ 10.001/
Web/ Course_Notes/ Differential_Equations_Notes/ node5.html.
[7] S. Hutchinson M. Spong and M. Vidyasager. Robot Modeling and Control. 2006.
[8] ROBOTIS. Ax-12a e-manual, 2019. URL
http:// emanual.robotis.com/ docs/ en/ dxl/ ax/ ax-12a/ .

A Appendix

A.I Salient Code

Listing 3: Actuator Dynamics MATLAB Code 1 % dynamixel motor model experiment 2 close all;clear;clc
3
4 % test loads mass moments of inertia
5 m = [.146 .088 0.108]; | % mass (kg)
6 b = [.61277 .37227 0.28257]; | % length (m)
7 h = [.01915 0.01915 0.0299]; | % height (m)
8 J = (1/12)*m.*(h.^2 + b.^2);
9
10 % path to csv files relative to script
11 datapath = 'data/AX12A/';
12 files = dir(strcat(datapath,'*.csv')); 13 numFiles = length(files);
14 % initialize variables
15 [damp, wn, Tp] = deal(zeros(numFiles,1));
16
17 for ii = 1:numFiles
18 | % load experimental data, skip 5 header lines
19 | M = csvread(strcat(datapath, files(ii).name),5,0);
20 | % clean data by removing outliers
21 | nani = (find(diff(M(:,1)) > 100));
22 | M(nani,:) = [];
23 | % show response
24 | figure();
25 | plot(M(:,1),M(:,2))
26 | title('Experimental Data')
27 | % find % OS
28 | peak = max(M(:,2)); | % peak value
29 | peaki = find(M(:,2)==peak, 1, 'first'); | % peak value index
30 | ss = M(end,2); | % steady state
31 | os = ((peak − ss) / ss) * 100; | % % OS
32 | % damping ratio
33 | damp(ii) = −log(os/100) / sqrt(pi^2 + log(os/100)^2);
34 | % find where the motor begins responding
35 | start = M(find(diff(M(:,2)) > 1, 1, 'first'), 1);
36 | % time to peak
37 | Tp(ii) = (M(peaki,1) − start) / 1000;
38 | % natural frequency
39 | wn(ii) = pi / (sqrt(1 − damp(ii)^2)*Tp(ii));
40 end

41
42 sol = zeros(4,1);
43 % no load case, 2*zeta*omega_n
44 sol(1) = 2*mean(damp(end−2:end))*mean(wn(end−2:end)); 45 % no load case, omega_n^2
46 sol(2) = mean(wn(end−2:end))^2;
47
48 % obtain average damping ratio and natural frequencies for load cases 49 zeta = [mean(damp(1:3));mean(damp(4:6));mean(damp(7:9))];
50 omegan = [mean(wn(1:3));mean(wn(4:6));mean(wn(7:9))];
51
52 alpha = 2.*zeta.*omegan;
53 beta = omegan.^2;
54 A = zeros(3,2);
55 b = zeros(3,1);
56
57 for jj = 1:3
58 | A(jj,:) = [1, −(alpha(jj)*J(jj) + beta(jj)*J(jj))];
59 | b(jj) = alpha(jj) + beta(jj);
60 end
61
62 sol(3:4) = A \ b;
