treydufrene/meiosis_dev/LaTeX/cdr/images/eblock.pdf

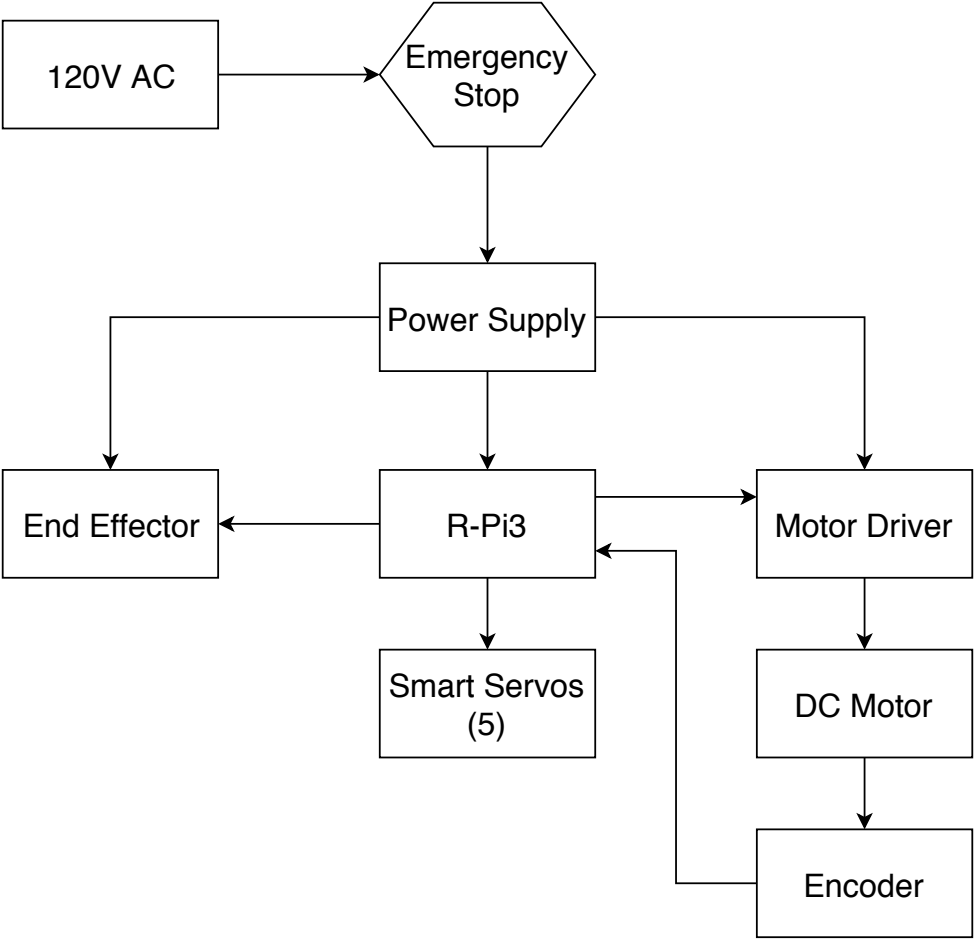
[picture p46: figure]
Power Supply; Smart Servos (5); End Effector; Emergency Stop; DC Motor; Motor Driver; Encoder
