treydufrene/meiosis_dev/LaTeX/specs/coverpage.tex

\begin{titlepage}
\flushleft
\doublespacing
\Large
\textsc{Specifications} \\
\normalsize
Trey Dufrene, Zack Johnson, David Orcutt, Alan Wallingford, Ryan Warner
\vfill
\center
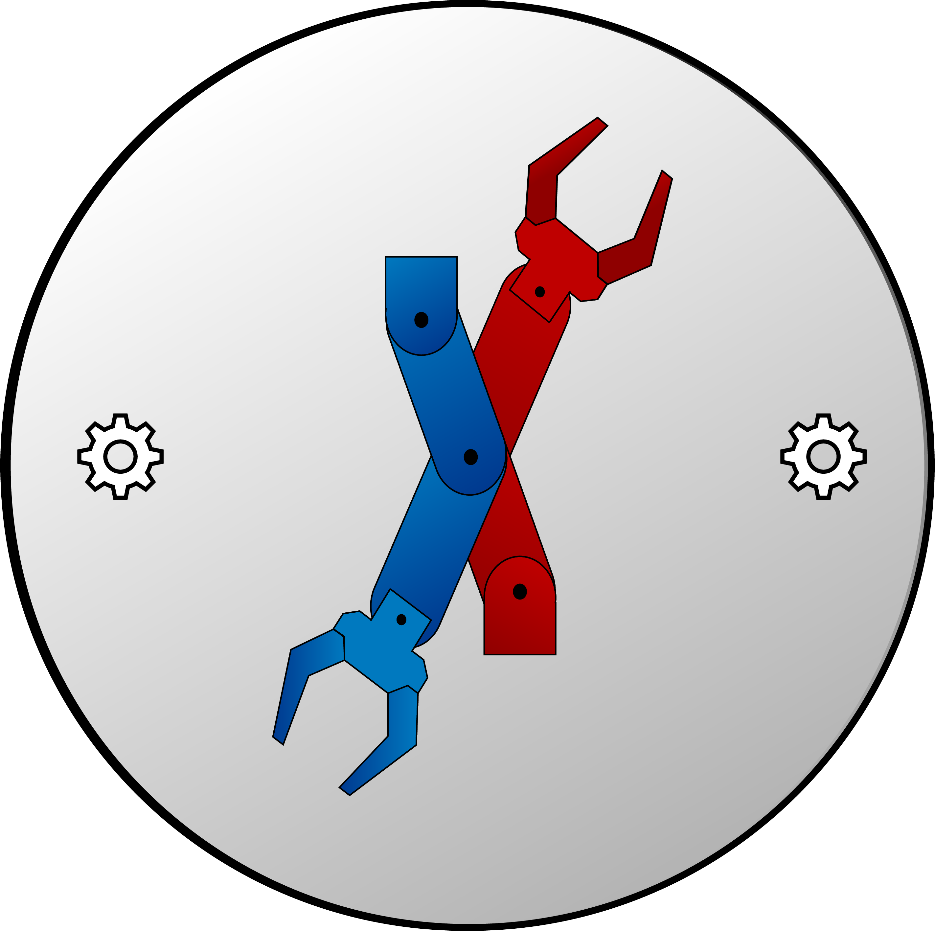
[picture p47: LaTeX/GCD/images/logo.png]

\vfill
\flushleft
ME 407 \\
Preliminary Design of Robotic Systems \\
Embry-Riddle Aeronautical University \\
\vspace{2ex}
\begin{minipage}[c]{.5\textwidth}
\flushleft
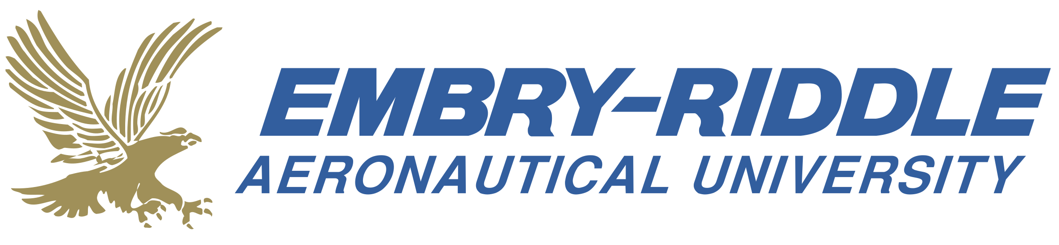
[picture p48: LaTeX/GCD/images/erau.png]

\end{minipage}%
\begin{minipage}[c]{.5\textwidth}
\flushright

\end{minipage}
\end{titlepage}
