treydufrene/meiosis_dev/LaTeX/style/coverpage.tex

\begin{titlepage}
\flushleft
\doublespacing
\Large
\textsc{Document Title} \normalsize\color{red} 16pt. times new roman, small caps left adjusted\color{black}\\
\normalsize
Trey Dufrene, Alan Wallingford, David Orcutt, Ryan Warner, Zack Johnson \color{red} (Times New Roman, 12pt., single-spaced, left aligned) \color{black}
\vfill
\center

\vfill
\flushleft
ME 407 \color{red} (Times New Roman, 12 pt., single-spaced, left aligned) \color{black}\\
Preliminary Design of Robotic Systems \\
Embry-Riddle Aeronautical University \\
\vspace{2ex}
\begin{minipage}[c]{.5\textwidth}
\flushleft

\end{minipage}%
\begin{minipage}[c]{.5\textwidth}
\flushright

\end{minipage}
\end{titlepage}
