treydufrene/meiosis_dev/MATLAB/Conceptual Design/DexterityWithOffset.pdf

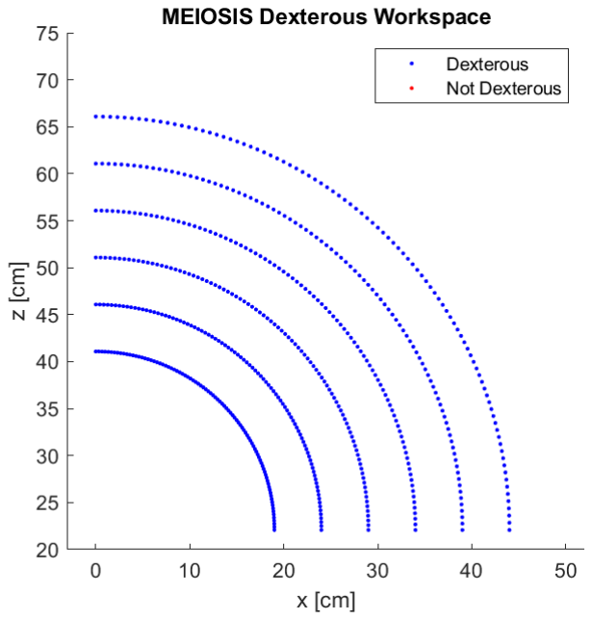
[picture p50: figure]
