treydufrene/meiosis_dev/MATLAB/Conceptual Design/MEIOSIS_dexterity.pdf

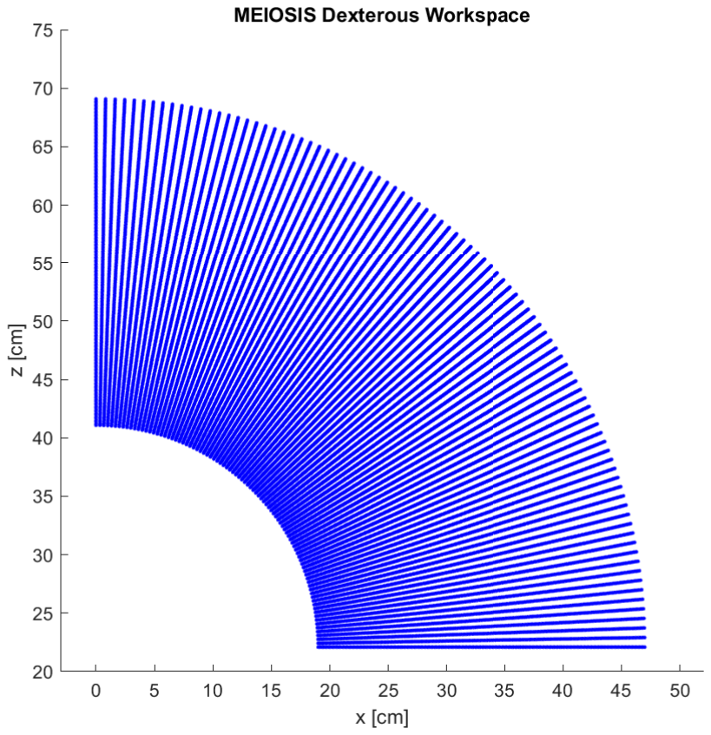
[picture p51: figure]
