treydufrene/meiosis_dev/LaTeX/style/style.pdf

Document Title 16pt. times new roman, small caps left adjusted

Trey Dufrene, Alan Wallingford, David Orcutt, Ryan Warner, Zack Johnson (Times New

Roman, 12pt., single-spaced, left aligned)


ME 407 (Times New Roman, 12 pt., single-spaced, left aligned)

Preliminary Design of Robotic Systems

Embry-Riddle Aeronautical University


Abstract

(↑ bold) 12pt times new roman centered horiz & vert, full line space between header and text Lorem ipsum dolor sit amet, consectetuer adipiscing elit. Etiam lobortis facilisis sem. Nullam nec mi et neque pharetra sollicitudin. Praesent imperdiet mi nec ante. Donec ullamcorper, felis non sodales commodo, lectus velit ultrices augue, a dignissim nibh lectus placerat pede. Vivamus nunc nunc, molestie ut, ultricies vel, semper in, velit. Ut porttitor. Praesent in sapien. Lorem ipsum dolor sit amet, consectetuer adipiscing elit. Duis fringilla tristique neque. Sed interdum libero ut metus. Pellentesque placerat. Nam rutrum augue a leo. Morbi sed elit sit amet ante lobortis sollicitudin. Praesent blandit blandit mauris. Praesent lectus tellus, aliquet aliquam, luctus a, egestas a, turpis. Mauris lacinia lorem sit amet ipsum. Nunc quis urna dictum turpis accumsan semper.

no page number

# Contents

1 | A Level Heading | | 1
2 | A Level Heading | | 1
2.1 | B Level Heading | | 1
2.2 | Example for Bulleted List | | 2
2.3 | Example for Numbered List | | 2
2.4 | Example for Descriptive List | | 3
3 | A Level Heading | | 3
4 | A Level Heading | | 4
5 | A Level Heading | | 6

# List of Figures

1 | Numerical Solution Motion Behavior Plot, (θo : 0, φo : 0) | | 5
2 | Figure with Callouts | | 6

# List of Tables

1 | DH Table for 6 DOF Manipulator | | 3

latex table of contents, list of figures and table format with report document style

centered page numbers, roman numeral for frontmatter, arabic for rest

i

## List Of Acronyms and Abbreviations

(↑ bold) 12pt times new roman centered horiz & vert, full line space between header and text
G : Center of gravity of the bar
`0 : Spring unstretched length
δ : Spring deflection
k : Spring constant
hb : Distance to bar (G) from datum Fs : Force onto bar due to spring
An : Pin reaction in θ direction
At
: Pin reaction in tangential direction ~vG : Velocity of bar center of gravity ¨θ : Angular velocity of spring
φ¨ : Angular velocity of bar
¨`s : Radial acceleration of spring
← | margins 1 inch all around →

ii

## 1 A Level Heading

↑ left adjusted all headings arabic numbering ,full line space between headers and text Lorem ipsum dolor sit amet, consectetuer adipiscing elit. Etiam lobortis facilisis sem. Nullam nec mi et neque pharetra sollicitudin. Praesent imperdiet mi nec ante. Donec ullamcorper, felis non sodales commodo, lectus velit ultrices augue, a dignissim nibh lectus placerat pede. Vivamus nunc nunc, molestie ut, ultricies vel, semper in, velit. Ut porttitor. Praesent in sapien. Lorem ipsum dolor sit amet, consectetuer adipiscing elit. Duis fringilla tristique neque. Sed interdum libero ut metus. Pellentesque placerat. Nam rutrum augue a leo. Morbi sed elit sit amet ante lobortis sollicitudin. Praesent blandit blandit mauris. Praesent lectus tellus, aliquet aliquam, luctus a, egestas a, turpis. Mauris lacinia lorem sit amet ipsum. Nunc quis urna dictum turpis accumsan semper. [1] 12pt. Times New Roman single spaced

## 2 A Level Heading

Lorem ipsum dolor sit amet, consectetuer adipiscing elit. Etiam lobortis facilisis sem. Nullam nec mi et neque pharetra sollicitudin. Praesent imperdiet mi nec ante. Donec ullamcorper, felis non sodales commodo, lectus velit ultrices augue, a dignissim nibh lectus placerat pede. Vivamus nunc nunc, molestie ut, ultricies vel, semper in, velit. Ut porttitor. Praesent in sapien. Lorem ipsum dolor sit amet, consectetuer adipiscing elit. Duis fringilla tristique neque. Sed interdum libero ut metus. Pellentesque placerat. Nam rutrum augue a leo. Morbi sed elit sit amet ante lobortis sollicitudin. Praesent blandit blandit mauris. Praesent lectus tellus, aliquet aliquam, luctus a, egestas a, turpis. Mauris lacinia lorem sit amet ipsum. Nunc quis urna dictum turpis accumsan semper. [2]

### 2.1 B Level Heading

Lorem ipsum dolor sit amet, consectetuer adipiscing elit. Etiam lobortis facilisis sem. Nullam nec mi et neque pharetra sollicitudin. Praesent imperdiet mi nec ante. Donec ullamcorper, felis non sodales commodo, lectus velit ultrices augue, a dignissim nibh lectus placerat pede. Vivamus nunc nunc, molestie ut, ultricies vel, semper in, velit. Ut porttitor. Praesent in sapien. Lorem ipsum dolor sit amet, consectetuer adipiscing elit. Duis fringilla tristique neque. Sed interdum libero ut metus. Pellentesque placerat. Nam rutrum augue a leo. Morbi sed elit sit amet ante lobortis sollicitudin. Praesent blandit blandit mauris. Praesent lectus tellus, aliquet aliquam, luctus a, egestas a, turpis. Mauris lacinia lorem sit amet ipsum. Nunc quis urna dictum turpis accumsan semper. [3]

C Level Heading

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

1

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

C Level Heading

Lorem ipsum dolor sit amet, consectetuer adipiscing elit. Etiam lobortis facilisis sem. Nullam nec mi et neque pharetra sollicitudin. Praesent imperdiet mi nec ante. Donec ullamcorper, felis non sodales commodo, lectus velit ultrices augue, a dignissim nibh lectus placerat pede. Vivamus nunc nunc, molestie ut, ultricies vel, semper in, velit. Ut porttitor. Praesent in sapien. Lorem ipsum dolor sit amet, consectetuer adipiscing elit. Duis fringilla tristique neque. Sed interdum libero ut metus. Pellentesque placerat. Nam rutrum augue a leo. Morbi sed elit sit amet ante lobortis sollicitudin. Praesent blandit blandit mauris. Praesent lectus tellus, aliquet aliquam, luctus a, egestas a, turpis. Mauris lacinia lorem sit amet ipsum. Nunc quis urna dictum turpis accumsan semper.
2.1.0.a D level heading
By definition, “A manipulator having more than six DOF is referred to as a kinematically redundant manipulator [1, pp. 5].”

### 2.2 Example for Bulleted List

bullets are 3 dashed lines

— First itemtext

— Second itemtext

— Last itemtext

— First itemtext

— Second itemtext

### 2.3 Example for Numbered List

2.3.0.a First itemtext

2.3.0.b Second itemtext

2.3.0.c Last itemtext

2.3.0.d First itemtext

2.3.0.e Second itemtext

2

### 2.4 Example for Descriptive List

First itemtext

Second itemtext

Last itemtext

First itemtext

Second itemtext

## 3 A Level Heading

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

Table 1: DH Table for 6 DOF Manipulator

bold col headers, table times new roman, 12pt., centered,
DH | di | θi | ai | αi
1 | 280 | q1 − π | 0 | π/2
2 | 0 | q2 + π/2 | 210 | 0
3 | 0 | q3 − π/2 | 75 | -π/2
4 | 210 | q4 | 0 | π/2
5 | 0 | q5 − π | 0 | π/2
6 | 70 | q6 | 0 | 0

Table 1 (italisized callouts)shows the Denavit–Hartenberg parameters for the manipulator. Lorem ipsum dolor sit amet, consectetuer adipiscing elit. Etiam lobortis facilisis sem. Nullam nec mi et neque pharetra sollicitudin. Praesent imperdiet mi nec ante. Donec ullamcorper, felis non sodales commodo, lectus velit ultrices augue, a dignissim nibh lectus placerat pede. Vivamus nunc nunc, molestie ut, ultricies vel, semper in, velit. Ut porttitor. Praesent in sapien. Lorem ipsum dolor sit amet, consectetuer adipiscing elit. Duis fringilla tristique neque. Sed interdum libero ut metus. Pellentesque placerat. Nam rutrum augue a leo. Morbi sed elit sit amet ante lobortis sollicitudin. Praesent blandit blandit mauris. Praesent lectus tellus, aliquet aliquam, luctus a, egestas a, turpis. Mauris lacinia lorem sit amet ipsum. Nunc quis urna dictum turpis accumsan semper.

3

Taking the time derivative,

~vG =

"

˙`s sin(θ) + `bφ˙ cos(φ)

2

+ `s

˙θ cos(θ)

ˆı +

"

`bφ˙ sin(φ)

2

− ˙`s cos(θ) + `s
˙θ sin(θ)
ˆ

Since the moment of inertia I for a uniform slender bar rotating about its end is 1 12

m`²
and ω = φ˙
,

T2 =

1
2

mb(~vG · ~vG) + 1
24

mb`

2

bφ˙²

Total Kinetic Energy: | equations 12pt, centered, numbered on right
| T = T1 + T2 =
| 1
| 2 mb(~vG · ~vG) + 1
| 24 mb`
| 2

bφ˙²
(1)

¨θ =

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
∂θ =
Qθ

non

(2)

φ¨ =

d
dt

∂L
∂φ˙

!
−

∂L
∂φ =
Qφ

non

(3)

## 4 A Level Heading

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

4

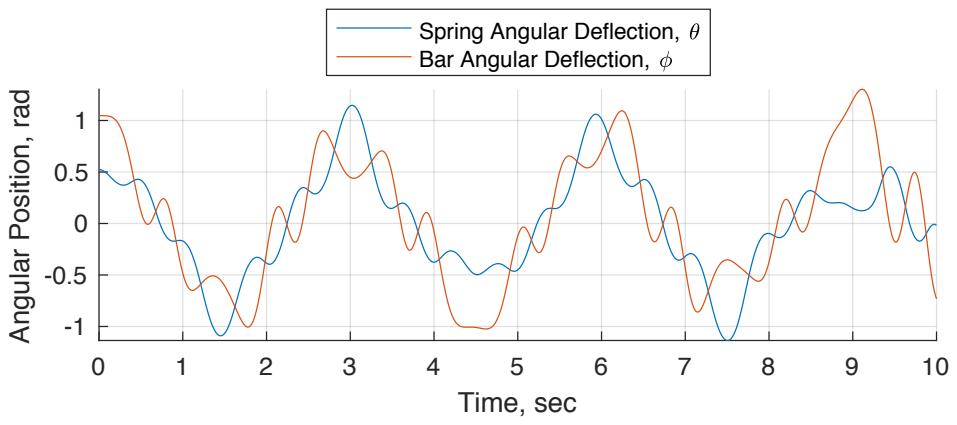
[picture p52: figure]
Time, sec; Angular Position, rad; Spring Angular Deflection, Bar Angular Deflection,

Figure 1: Numerical Solution Motion Behavior Plot, (θo : 0, φo : 0)

Figure 1 shows the relationship between Lorem ipsum dolor sit amet, consectetuer adipiscing elit. Etiam lobortis facilisis sem. Nullam nec mi et neque pharetra sollicitudin. Praesent imperdiet mi nec ante. Donec ullamcorper, felis non sodales commodo, lectus velit ultrices augue, a dignissim nibh lectus placerat pede. Vivamus nunc nunc, molestie ut, ultricies vel, semper in, velit. Ut porttitor. Praesent in sapien. Lorem ipsum dolor sit amet, consectetuer adipiscing elit. Duis fringilla tristique neque. Sed interdum libero ut metus. Pellentesque placerat. Nam rutrum augue a leo. Morbi sed elit sit amet ante lobortis sollicitudin. Praesent blandit blandit mauris. Praesent lectus tellus, aliquet aliquam, luctus a, egestas a, turpis. Mauris lacinia lorem sit amet ipsum. Nunc quis urna dictum turpis accumsan semper.

5

## 5 A Level Heading

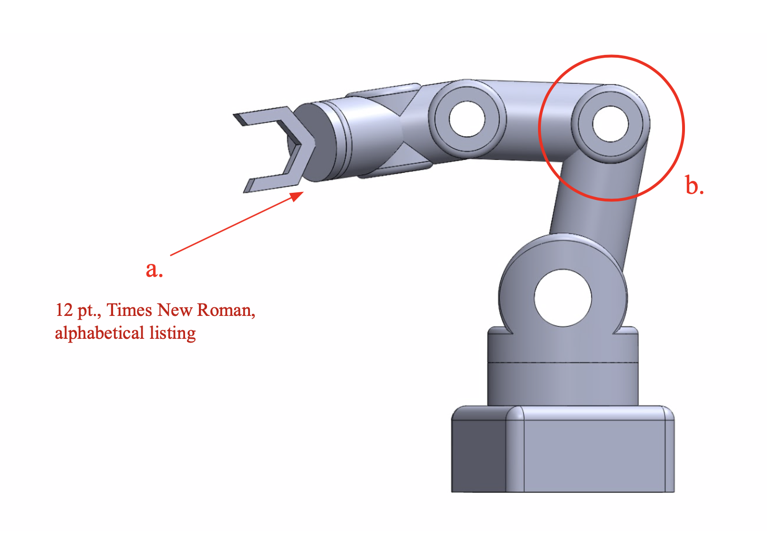
[picture p53: figure]

Figure 2: Figure with Callouts

a. Description for callout a
b. Description for callout b
As seen in Figure 2, callout a. is blah.
Lorem ipsum dolor sit amet, consectetuer adipiscing elit. Etiam lobortis facilisis sem. Nullam nec mi et neque pharetra sollicitudin. Praesent imperdiet mi nec ante. Donec ullamcorper, felis non sodales commodo, lectus velit ultrices augue, a dignissim nibh lectus placerat pede. Vivamus nunc nunc, molestie ut, ultricies vel, semper in, velit. Ut porttitor. Praesent in sapien. Lorem ipsum dolor sit amet, consectetuer adipiscing elit. Duis fringilla tristique neque. Sed interdum libero ut metus. Pellentesque placerat. Nam rutrum augue a leo. Morbi sed elit sit amet ante lobortis sollicitudin. Praesent blandit blandit mauris. Praesent lectus tellus, aliquet aliquam, luctus a, egestas a, turpis. Mauris lacinia lorem sit amet ipsum. Nunc quis urna dictum turpis accumsan semper.

6

# References

[1] Justin Johnson, Alexandre Alahi, and Fei-Fei Li. Perceptual losses for real-time style transfer and super-resolution. CoRR, abs/1603.08155, 2016.
[2] Olaf Ronneberger, Philipp Fischer, and Thomas Brox. U-net: Convolutional networks for biomedical image segmentation. CoRR, abs/1505.04597, 2015.
[3] Leslie N. Smith. A disciplined approach to neural network hyper-parameters: Part 1 -learning rate, batch size, momentum, and weight decay. CoRR, abs/1803.09820, 2018.

12pt times new roman left justified
all references follow IEEE formatting

7

## Acknowledgements & Attributions

— First itemtext

— Second itemtext

— Last itemtext

— First itemtext

— Second itemtext

8

## Appendix

Listing 1: Example Code Listing 1 Lagrangian = T − V;
2 % Partial of Lagrange Eq. w.r.t. thetadot
3 dLdthetadot = diff(Lagrangian,thetadot);
4 dLdthetadot_subbed = subs(dLdthetadot, [thetat, thetadot, phit, phidot,... 5 l1t, l1dot], [theta, diff(theta,t), phi, diff(phi,t), l1, diff(l1,t)]); 6 % Time derivative of Partial of Lagrange Eq. w.r.t. thetadot
7 ddLdthetadotdt = diff(dLdthetadot_subbed,t);
8 % Partial of Lagrange Eq. w.r.t. theta
9 dLdtheta = diff(Lagrangian,thetat);
10 % Theta EOM
11 eqn(1) = ddLdthetadotdt − dLdtheta == 0;

9

1

(Blank Slide)

Logo 0.07 in. from left, 4.83 in from top, 50% transparency

Slide number, arabic, lower right hand corner

# Title Slide

# Subtitle

Arial, 52 pt., centered

Arial, 28 pt., centered, dark gray 3 (#595959)

# Section Header Slide

3

Arial, 36 pt., centered

Title and Body Slide Arial, 28 pt., left aligned

Body Text Arial, 18 pt., dark gray 3 (#595959)

- First level Arial, 18 pt., [dark gray 3 (#595959)] (all levels)
- Second level [Arial, 14 pt.] (Second — Ninth levels)

## ■ Third level - Fourth level - Fifth level ■ Sixth level - Seventh level - Eighth level ■ Ninth level

4

Title and Two Columns Arial, 28 pt., left aligned

Normal body text Arial, 14 pt., dark gray 3 (#595959) | Normal body text Arial, 14 pt., dark gray 3 (#595959)

5

Title Only Slide Arial, 28 pt., left aligned

6

# One Column Text

Arial, 24 pt., centered over column

Normal Body Text Arial, 12 pt., left aligned

- First level Arial, 12 pt. (all levels)

### - Second Level ■ Third level ● Fourth level

7

Main Point Slide Arial, 48 pt., left aligned

8

# Section Title

Arial, 42 pt., centered, left side

# Subtitle

Arial, 21 pt., centered, dark gray 3 (#595959)

Description Arial, 18 pt., left aligned, right side

9

# Caption Slide

Arial, 18 pt., centered, dark gray 3 (#595959)

10

# xx% Slide

Arial, 120 pt., centered

# Subtitle

Arial, 18 pt., centered, dark gray 3 (#595959)

11

# Question Slide

12

Arial, 36 pt., centered
(Section Header Slide)

# Figure Formatting

13

### Figure Title [1]

(Arial 12 pt. Font,
centered below figure)

References Slide Arial, 28 pt., left aligned (Title and Two column slide)

Normal body text Arial, 14 pt., dark gray 3 (#595959) | Normal body text Arial, 14 pt., dark gray 3 (#595959)

14

Acknowledgement Slide Arial, 28 pt., left aligned (title and body slide)

Body Text Arial, 18 pt., dark gray 3 (#595959)

- First level Arial, 18 pt., [dark gray 3 (#595959)] (all levels)
- Second level [Arial, 14 pt.] (Second — Ninth levels)

## ■ Third level - Fourth level - Fifth level ■ Sixth level - Seventh level - Eighth level ■ Ninth level

15

# Table Formatting

16

Column Header Arial, 10 pt., bold | Col. Header 2
123 Arial, 10 pt. | 123
456 | 456
789 | 789
Total | 1368
