treydufrene/meiosis_dev/LaTeX/style/presentation.pdf

(Blank Slide)

Logo 0.07 in. from left, 4.83 in from top, 50% transparency

Slide number, arabic, lower right hand corner

# Title Slide

# Subtitle

Arial, 52 pt., centered

Arial, 28 pt., centered, dark gray 3 (#595959)

# Section Header Slide

Arial, 36 pt., centered

Title and Body Slide Arial, 28 pt., left aligned

Body Text Arial, 18 pt., dark gray 3 (#595959)

- First level Arial, 18 pt., [dark gray 3 (#595959)] (all levels)
- Second level [Arial, 14 pt.] (Second — Ninth levels)

### ■ Third level - Fourth level - Fifth level ■ Sixth level - Seventh level - Eighth level ■ Ninth level

Title and Two Columns Arial, 28 pt., left aligned

Normal body text Arial, 14 pt., dark gray 3 (#595959) | Normal body text Arial, 14 pt., dark gray 3 (#595959)

Title Only Slide Arial, 28 pt., left aligned

# One Column Text

Arial, 24 pt., centered over column

Normal Body Text Arial, 12 pt., left aligned

- First level Arial, 12 pt. (all levels)
- Second Level
■ Third level ● Fourth level

Main Point Slide Arial, 48 pt., left aligned

# Section Title

Arial, 42 pt., centered, left side

# Subtitle

Arial, 21 pt., centered, dark gray 3 (#595959)

Description Arial, 18 pt., left aligned, right side

## Caption Slide

Arial, 18 pt., centered, dark gray 3 (#595959)

# xx% Slide

Arial, 120 pt., centered

## Subtitle

Arial, 18 pt., centered, dark gray 3 (#595959)

# Question Slide

Arial, 36 pt., centered
(Section Header Slide)

# Figure Formatting

Figure Title [1]
(Arial 12 pt. Font,
centered below figure)

References Slide Arial, 28 pt., left aligned (Title and Two column slide)

Normal body text Arial, 14 pt., dark gray 3 (#595959) | Normal body text Arial, 14 pt., dark gray 3 (#595959)

Acknowledgement Slide Arial, 28 pt., left aligned (title and body slide)

Body Text Arial, 18 pt., dark gray 3 (#595959)

- First level Arial, 18 pt., [dark gray 3 (#595959)] (all levels)
- Second level [Arial, 14 pt.] (Second — Ninth levels)

### ■ Third level - Fourth level - Fifth level ■ Sixth level - Seventh level - Eighth level ■ Ninth level

# Table Formatting

Column Header Arial, 10 pt., bold | Col. Header 2
123 Arial, 10 pt. | 123
456 | 456
789 | 789
Total | 1368
