treydufrene/meiosis_dev/LaTeX/cdr/images/gantt2.pdf

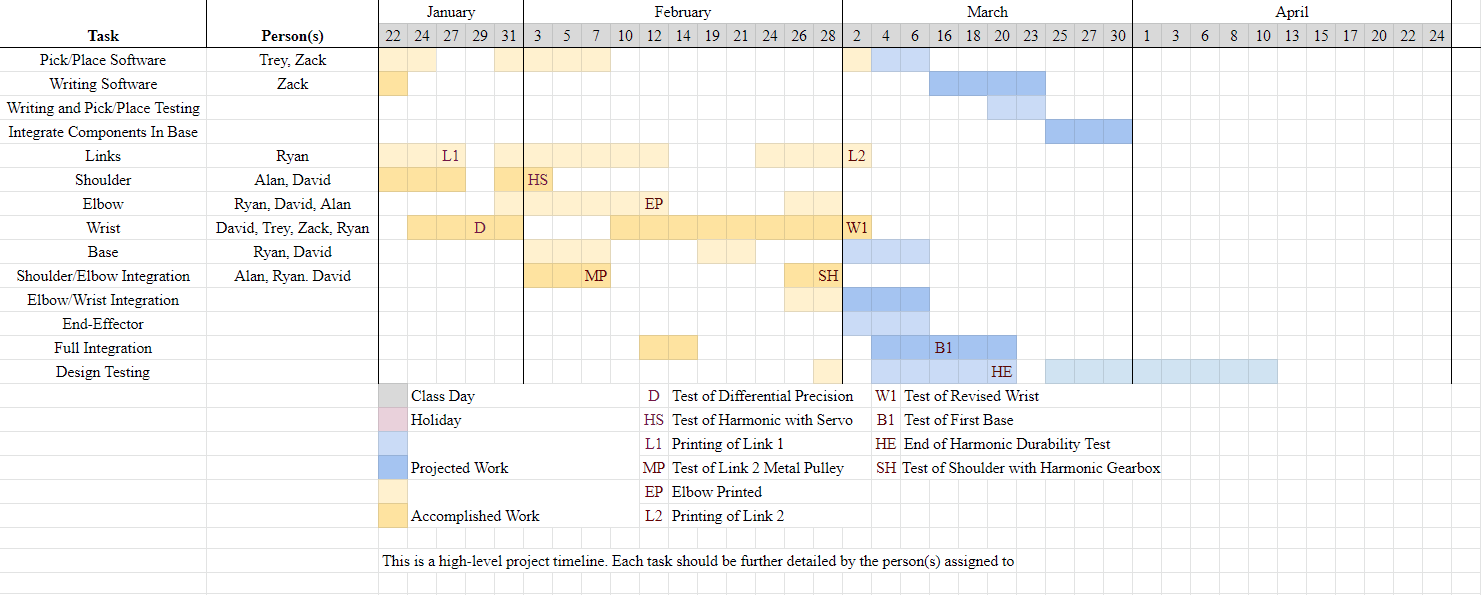
[picture p54: page 1]
