treydufrene/meiosis_dev/LaTeX/cdr/images/gantt.pdf

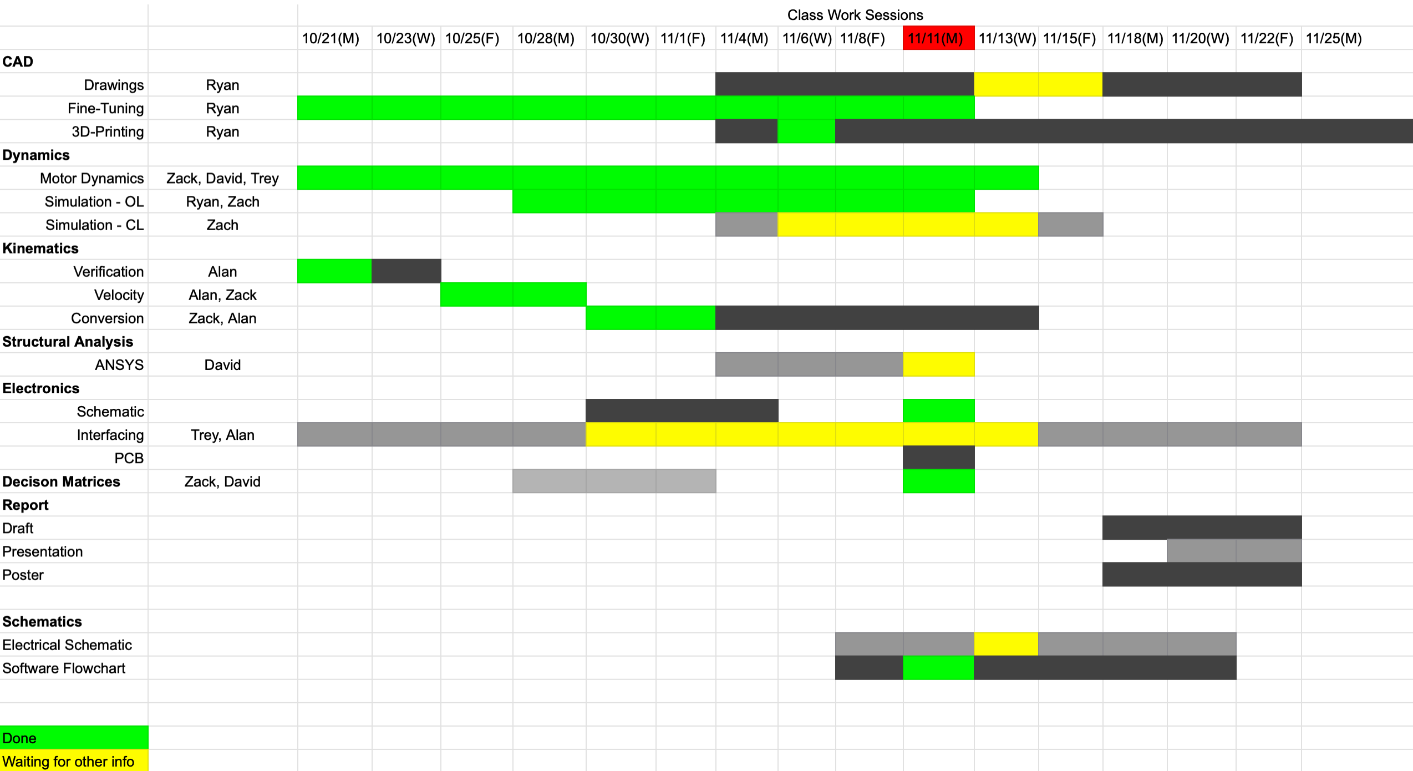
[picture p55: page 1]
