treydufrene/meiosis_dev/LaTeX/cdr/images/clsnap1.pdf

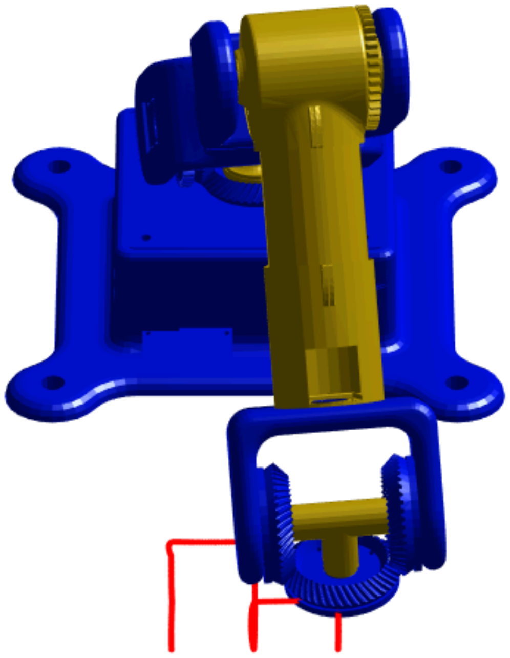
[picture p56: page 1]
