treydufrene/meiosis_dev/LaTeX/cdr/images/clsnap2.pdf

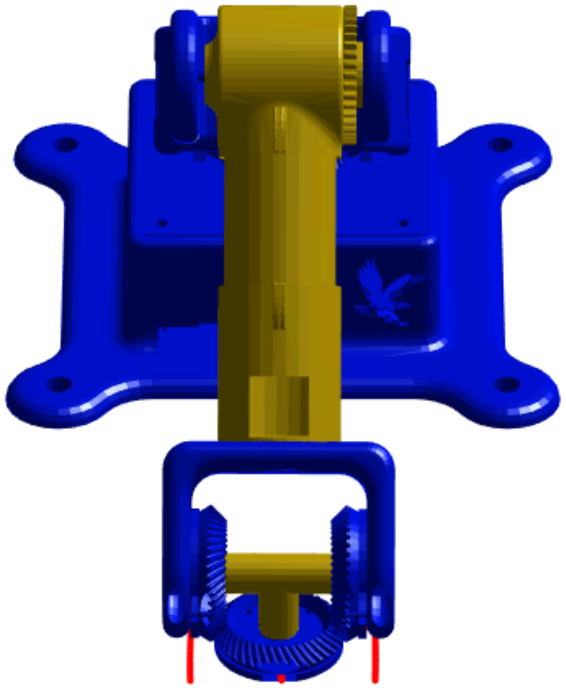
[picture p57: page 1]
