treydufrene/meiosis_dev/LaTeX/cdr/images/clsnap3.pdf

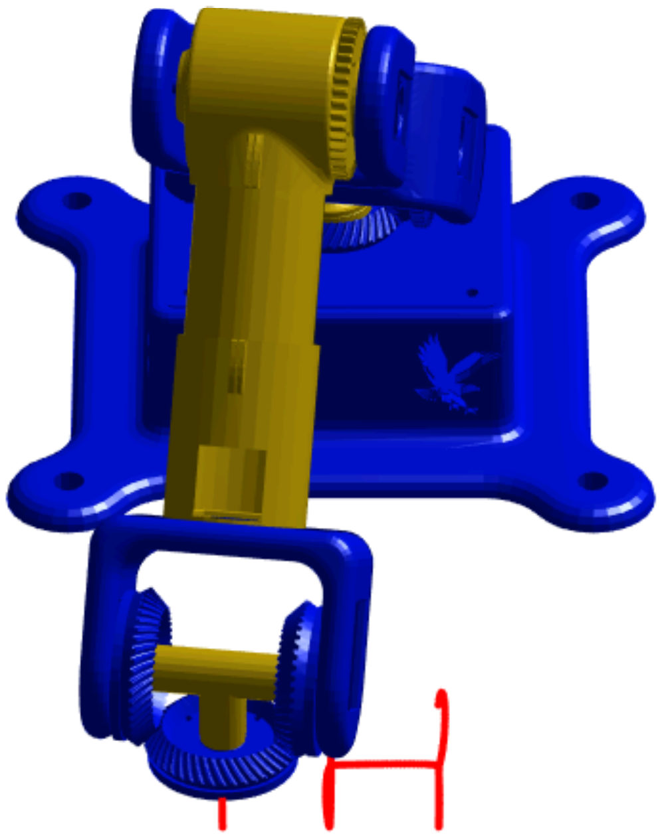
[picture p58: page 1]
