treydufrene/meiosis_dev/LaTeX/cdr/images/olsnap1.pdf

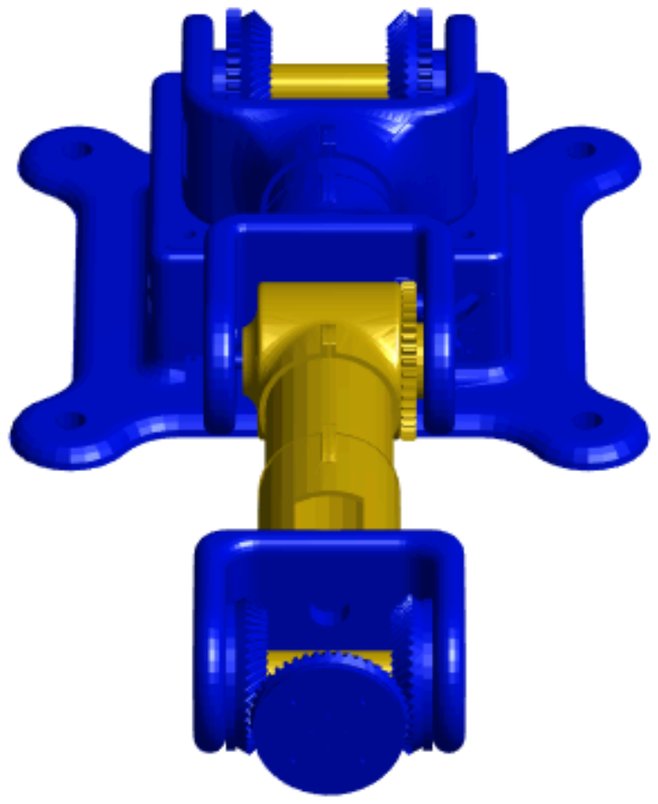
[picture p59: page 1]
