treydufrene/meiosis_dev/LaTeX/cdr/images/olsnap2.pdf

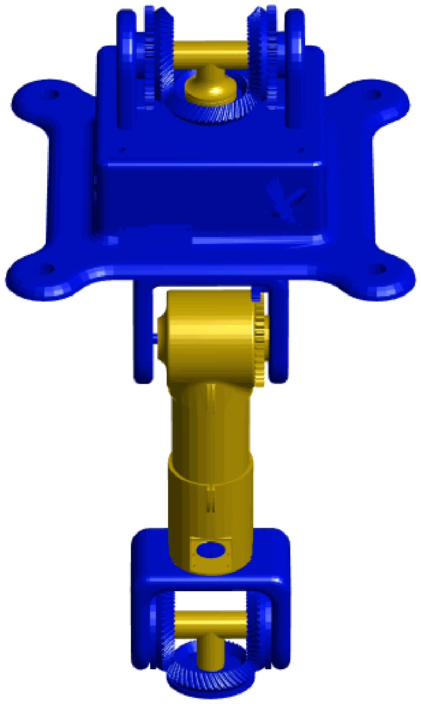
[picture p60: page 1]
