treydufrene/meiosis_dev/LaTeX/cdr/images/dex.pdf

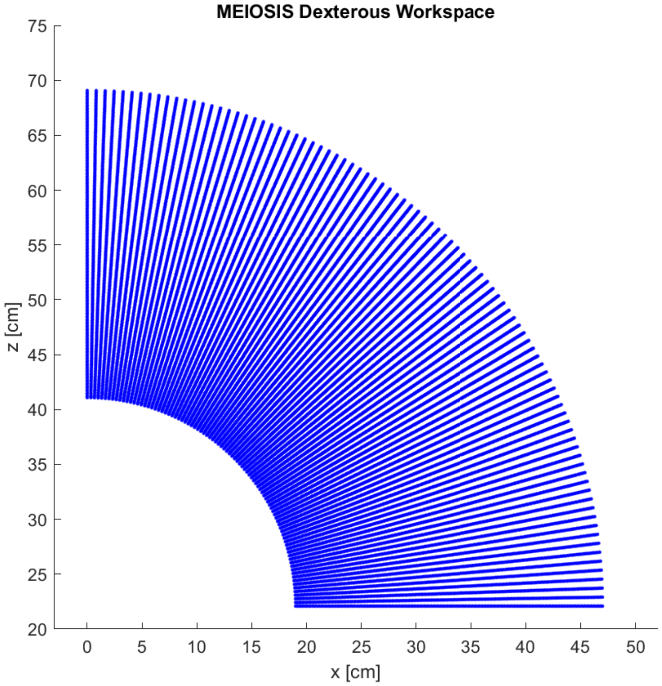
[picture p61: page 1]
