treydufrene/meiosis_dev/LaTeX/cdr/images/ansys_bearing copy.png

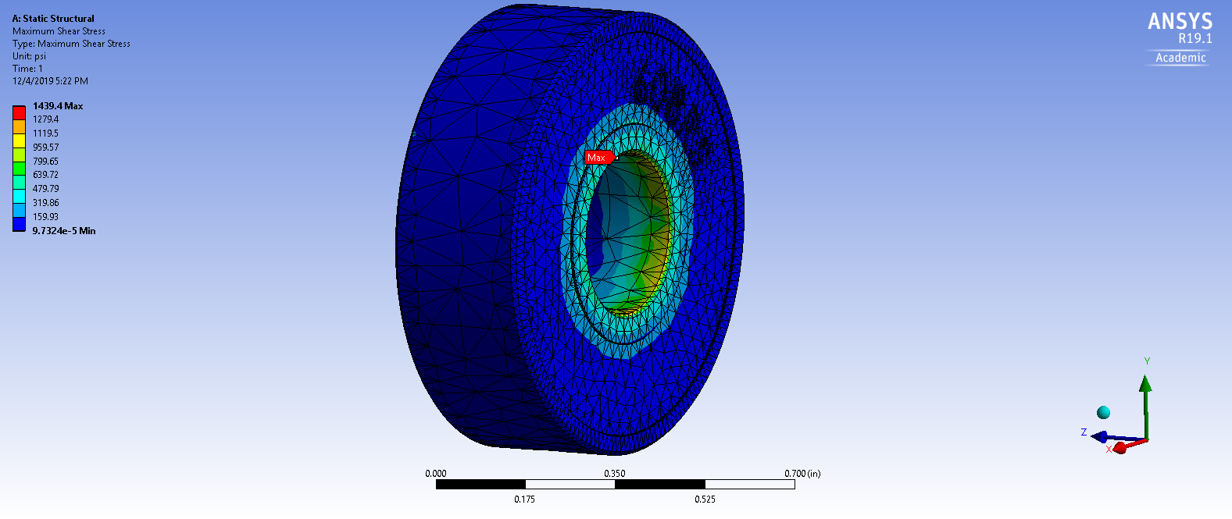
LaTeX/cdr/images/ansys_bearing copy.png
