treydufrene/meiosis_dev/LaTeX/cdr/images/ansys_fos.png

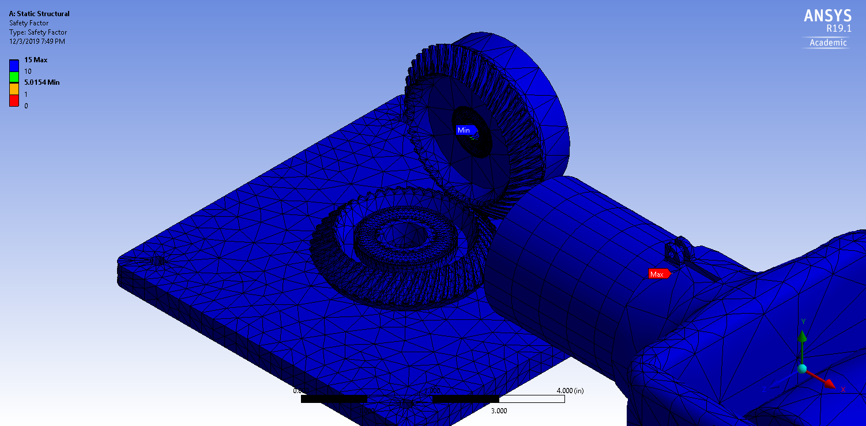
LaTeX/cdr/images/ansys_fos.png
