treydufrene/meiosis_dev/LaTeX/cdr/images/ansys_full copy.png

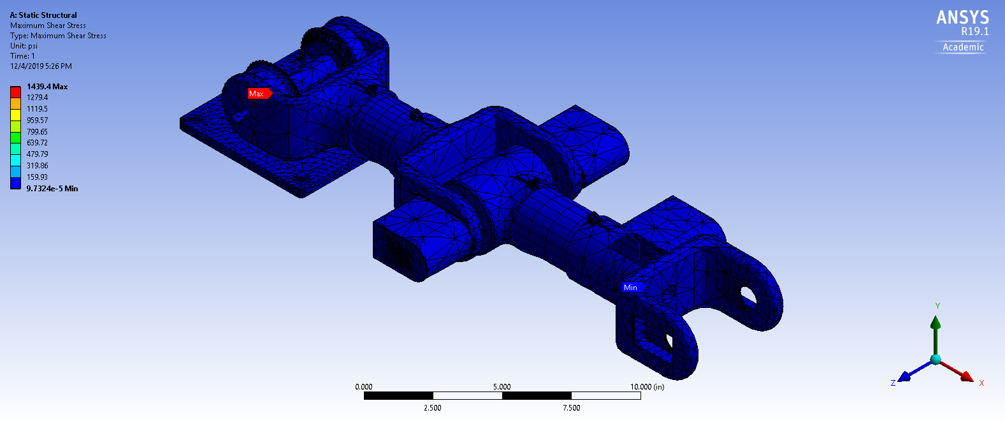
LaTeX/cdr/images/ansys_full copy.png
