treydufrene/meiosis_dev/LaTeX/cdr/images/callouts.png

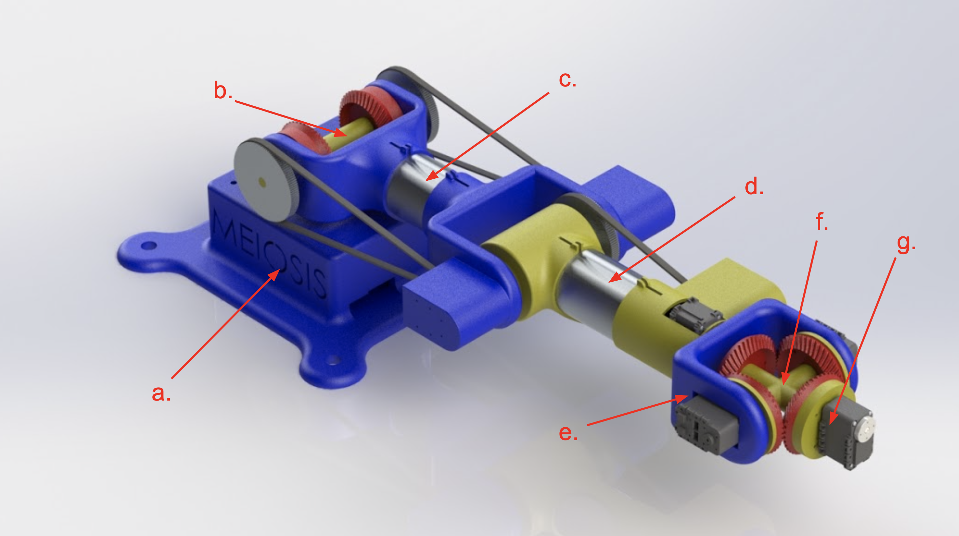
LaTeX/cdr/images/callouts.png
