treydufrene/meiosis_dev/LaTeX/cdr/images/coord.png

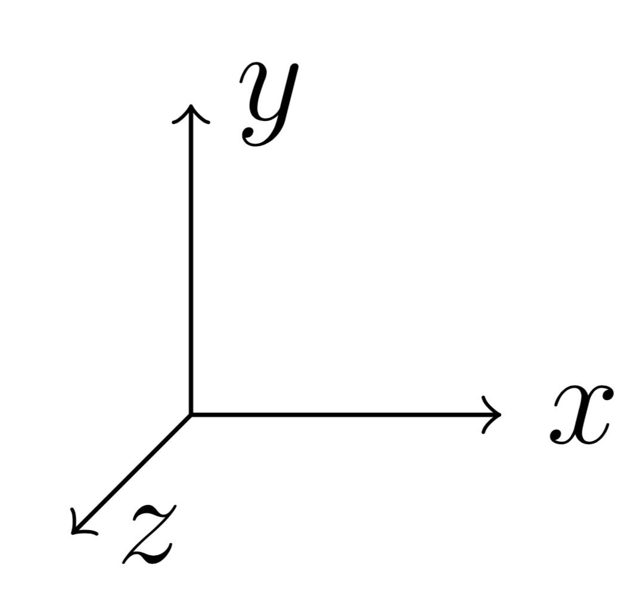
LaTeX/cdr/images/coord.png
