treydufrene/meiosis_dev/LaTeX/cdr/images/linkx.png

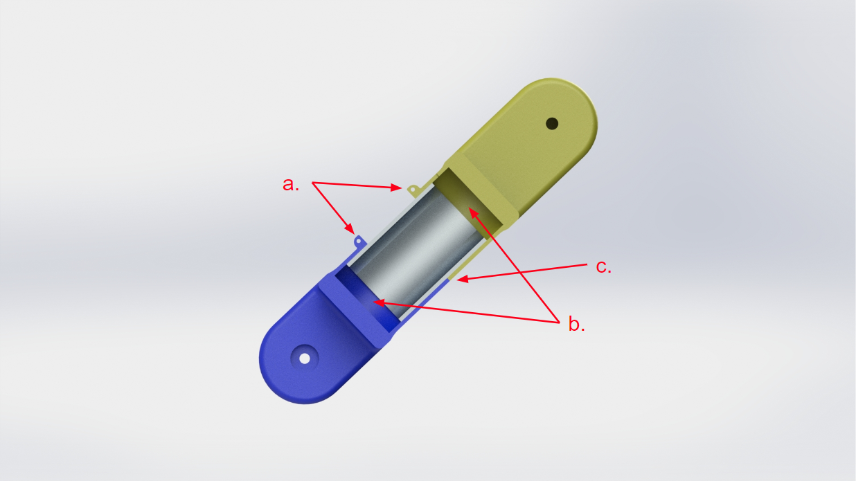
LaTeX/cdr/images/linkx.png
