treydufrene/meiosis_dev/LaTeX/cdr/images/meiosis.JPG

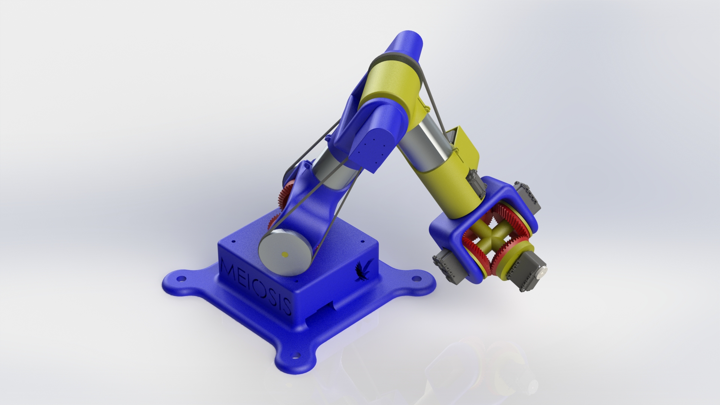
LaTeX/cdr/images/meiosis.JPG
