treydufrene/meiosis_dev/LaTeX/cdr/images/meiosis_zeroed_wdim.JPG

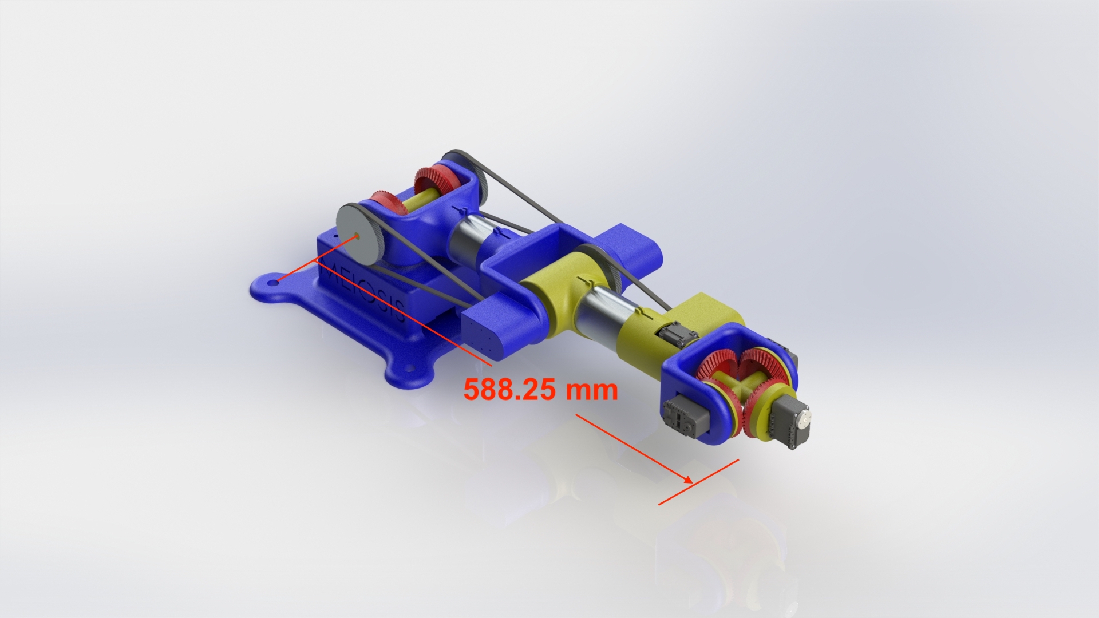
LaTeX/cdr/images/meiosis_zeroed_wdim.JPG
