treydufrene/meiosis_dev/LaTeX/cdr/images/overall_render.png

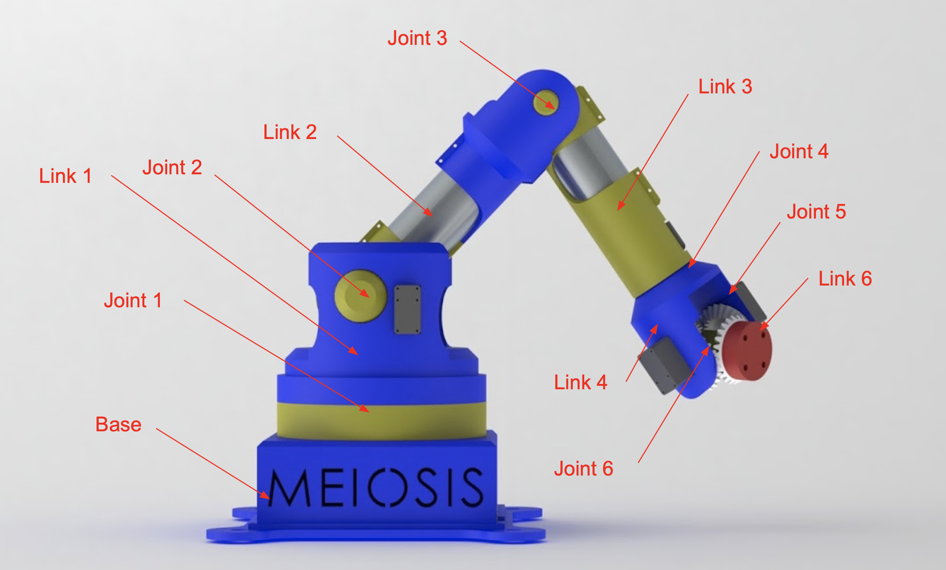
LaTeX/cdr/images/overall_render.png
