treydufrene/meiosis_dev/LaTeX/cdr/images/zero.png

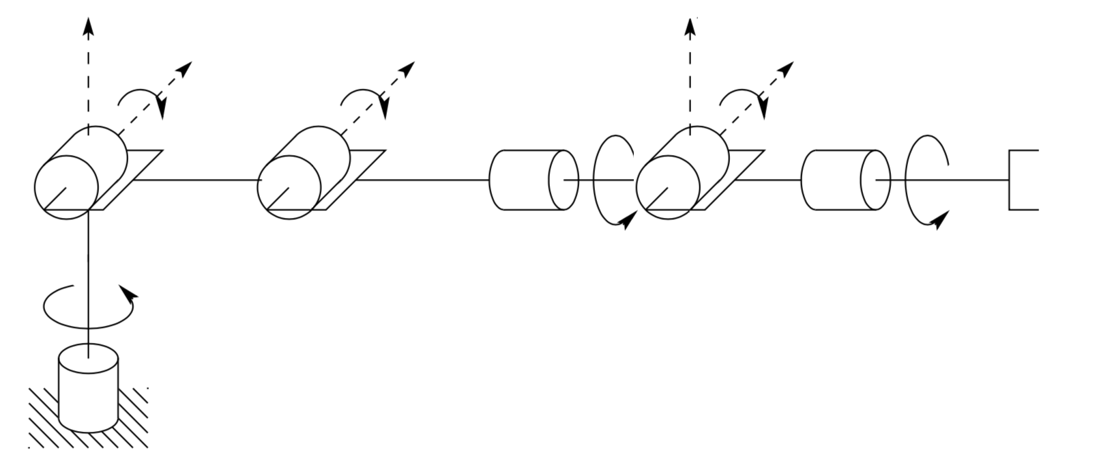
LaTeX/cdr/images/zero.png
