treydufrene/meiosis_dev/MATLAB/Open Loop Animation/STL2/Base.SLDASM

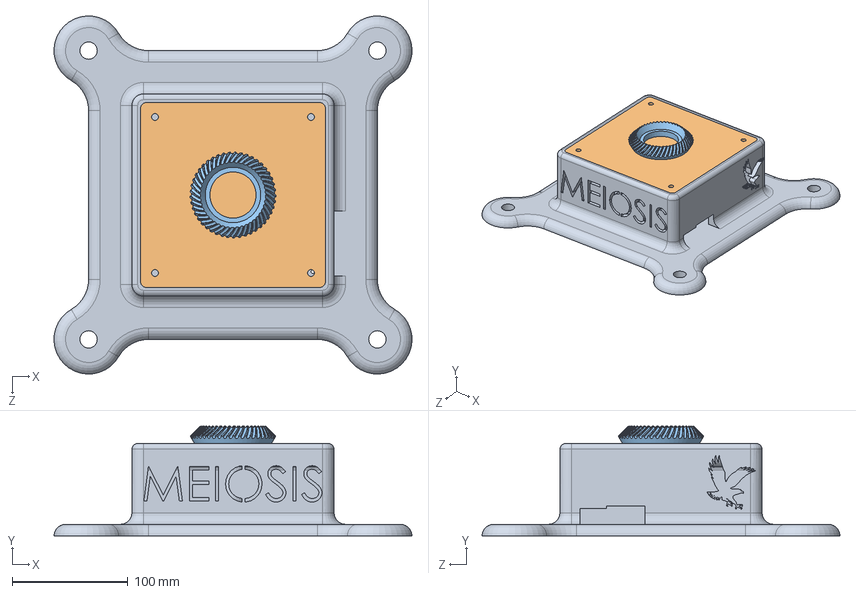
[picture p72: CAD file, 2019-11-11]
MATLAB/Open Loop Animation/STL2/Base.SLDASM
309.9 x 95.0 x 309.9 mm
Base_Bottom
Base_Top_diff
Bevel_Horizontal
