treydufrene/meiosis_dev/MATLAB/Circle Test Animation Final/STL/Link3.STL

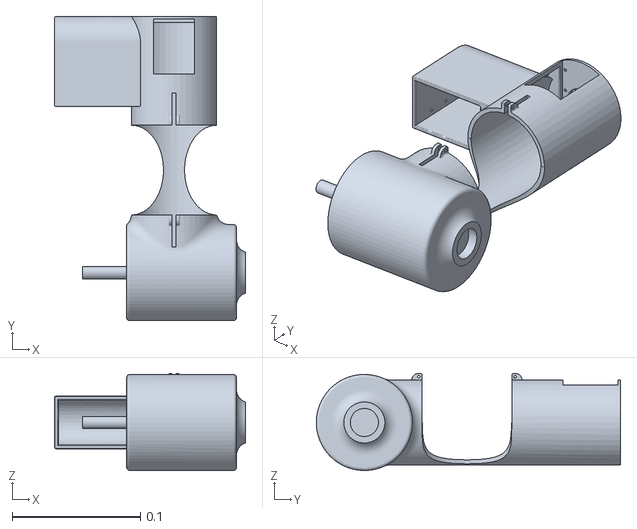
[picture p73: CAD file, 2020-01-22]
MATLAB/Circle Test Animation Final/STL/Link3.STL
0.149 x 0.238 x 0.0757
