treydufrene/meiosis_dev/MATLAB/Conceptual Design/STL/Link1.STL

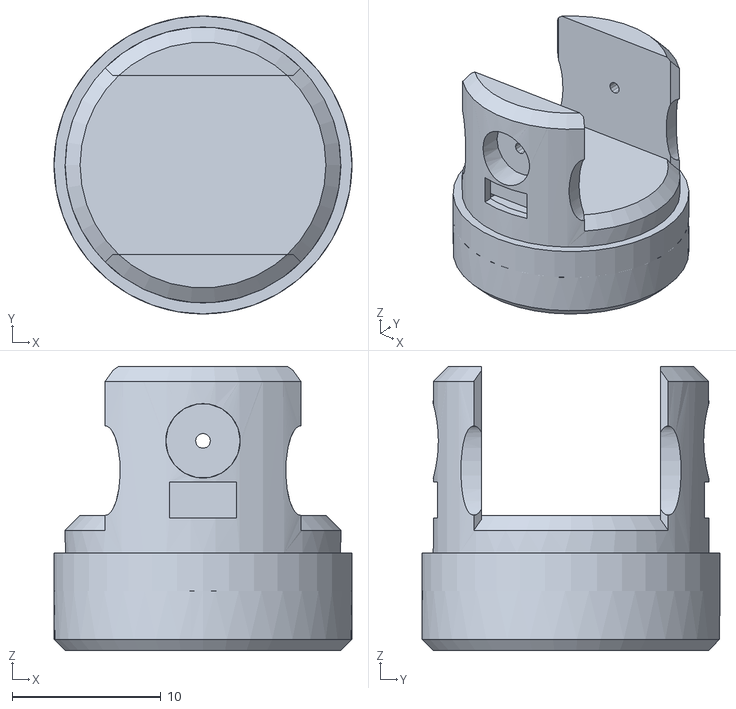
[picture p74: CAD file, 2019-10-14]
MATLAB/Conceptual Design/STL/Link1.STL
20.0 x 20.0 x 19.1
