treydufrene/meiosis_dev/MATLAB/Circle Test Animation Final/STL/Link6.STL

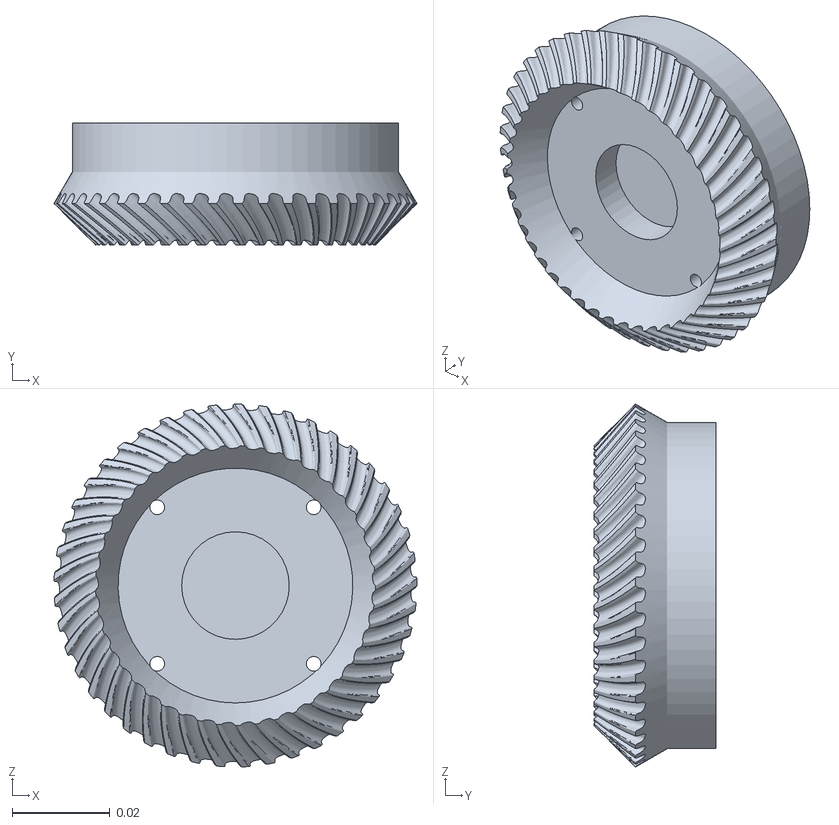
[picture p75: CAD file, 2020-01-22]
MATLAB/Circle Test Animation Final/STL/Link6.STL
0.0742 x 0.025 x 0.0742
