treydufrene/meiosis_dev/MATLAB/Conceptual Design/STL/Link4.STL

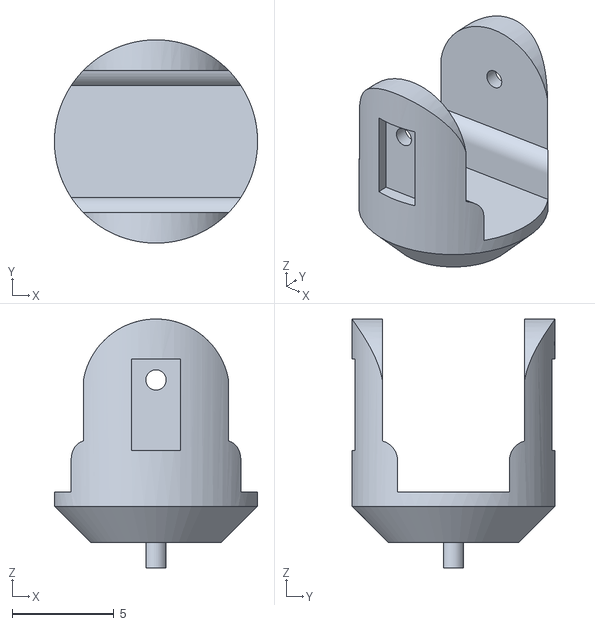
[picture p76: CAD file, 2019-10-14]
MATLAB/Conceptual Design/STL/Link4.STL
10.00 x 10.0 x 12.2
