treydufrene/meiosis_dev/MATLAB/Circle Test Animation Final/STL/Gear2.STL

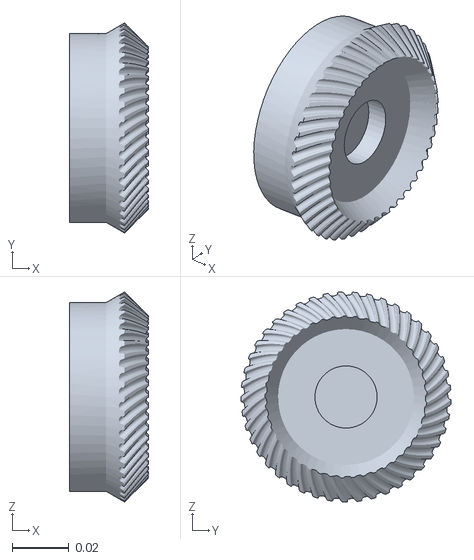
[picture p77: CAD file, 2019-12-04]
MATLAB/Circle Test Animation Final/STL/Gear2.STL
0.028 x 0.0742 x 0.0742
