treydufrene/meiosis_dev/MATLAB/Conceptual Design/STL/Link2.STL

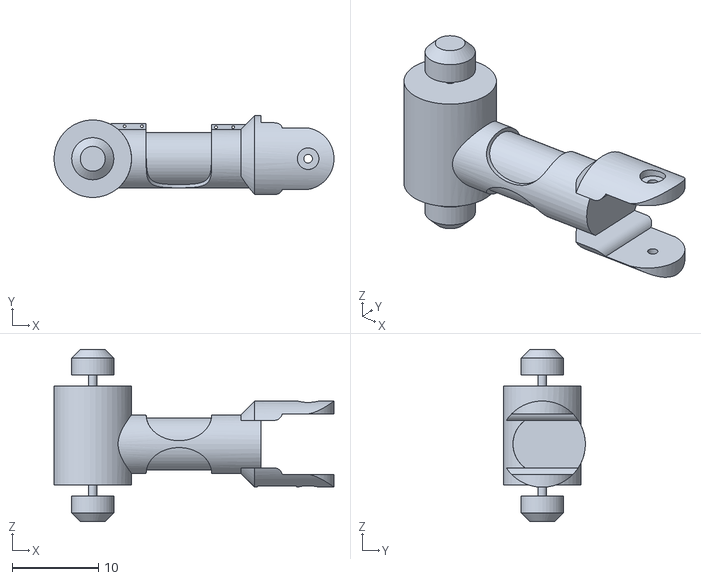
[picture p78: CAD file, 2019-10-14]
MATLAB/Conceptual Design/STL/Link2.STL
32.5 x 9.49 x 20.0
