treydufrene/meiosis_dev/MATLAB/Circle Test Animation Final/STL/Pulley1.STL

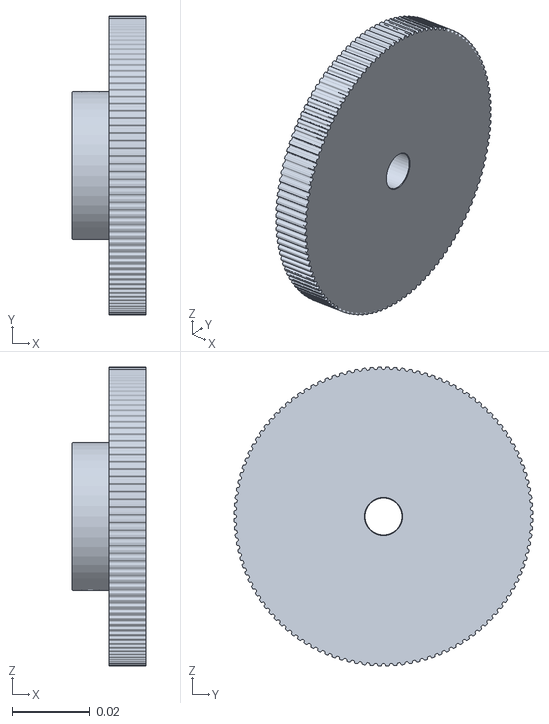
[picture p79: CAD file, 2019-12-04]
MATLAB/Circle Test Animation Final/STL/Pulley1.STL
0.0191 x 0.0771 x 0.0771
