treydufrene/meiosis_dev/MATLAB/Closed Loop Animation/STL2/Link2.STL

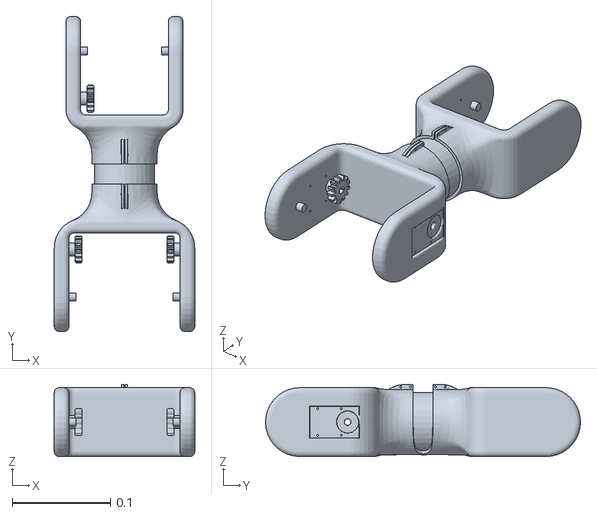
[picture p80: CAD file, 2019-11-11]
MATLAB/Closed Loop Animation/STL2/Link2.STL
0.143 x 0.32 x 0.0732
