treydufrene/meiosis_dev/MATLAB/Conceptual Design/STL/Link3.STL

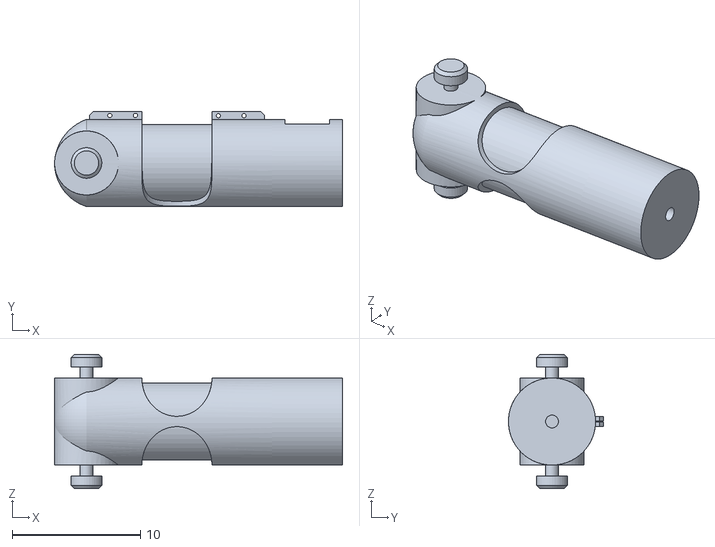
[picture p81: CAD file, 2019-10-14]
MATLAB/Conceptual Design/STL/Link3.STL
22.5 x 7.43 x 10.5
