treydufrene/meiosis_dev/MATLAB/Conceptual Design/STL/Link6.STL

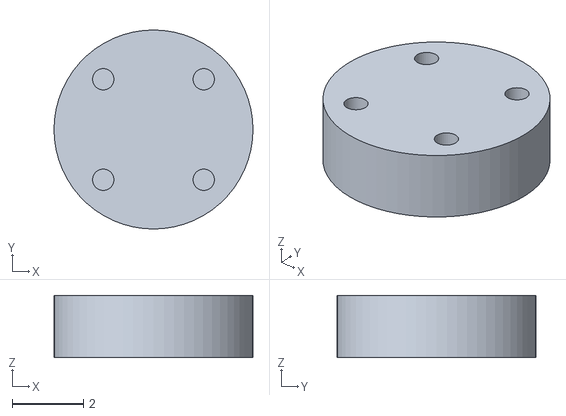
[picture p82: CAD file, 2019-10-14]
MATLAB/Conceptual Design/STL/Link6.STL
5.60 x 5.60 x 1.75
