treydufrene/meiosis_dev/MATLAB/Conceptual Design/STL/Link5.STL

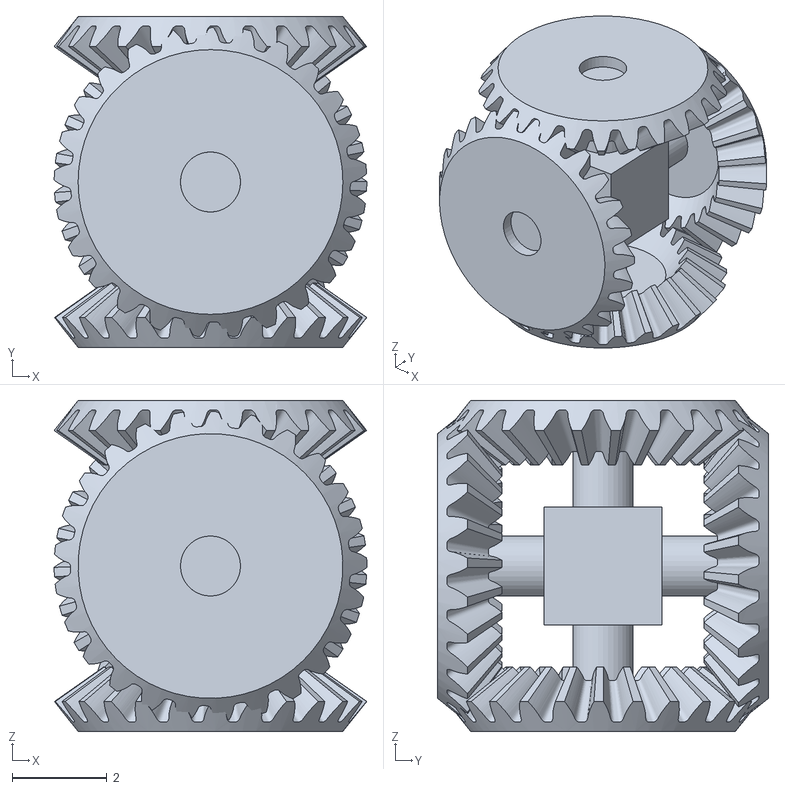
[picture p83: CAD file, 2019-10-14]
MATLAB/Conceptual Design/STL/Link5.STL
6.61 x 7.00 x 7.00
