treydufrene/meiosis_dev/MATLAB/Circle Test Animation Final/STL/Link2belt.STL

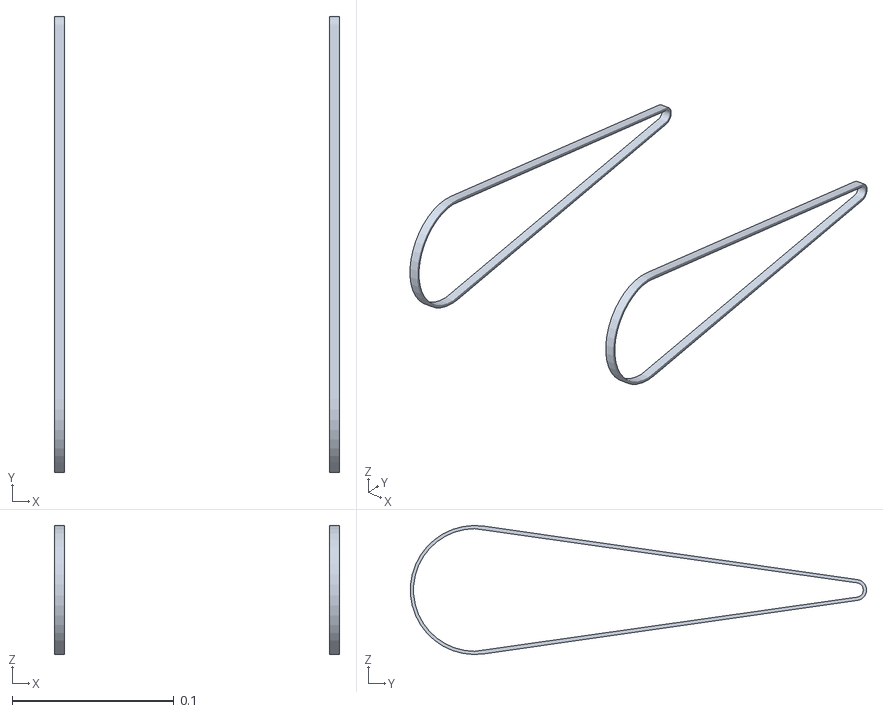
[picture p84: CAD file, 2019-12-04]
MATLAB/Circle Test Animation Final/STL/Link2belt.STL
0.176 x 0.282 x 0.0799
