treydufrene/meiosis_dev/MATLAB/Conceptual Design/STL/Base.STL

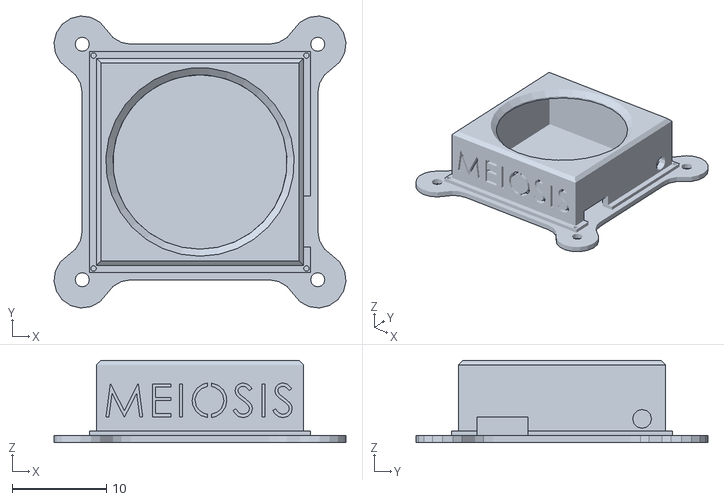
[picture p85: CAD file, 2019-10-12]
MATLAB/Conceptual Design/STL/Base.STL
31.0 x 31.0 x 8.75
