treydufrene/meiosis_dev/MATLAB/Circle Test Animation Final/STL/Link6motor.STL

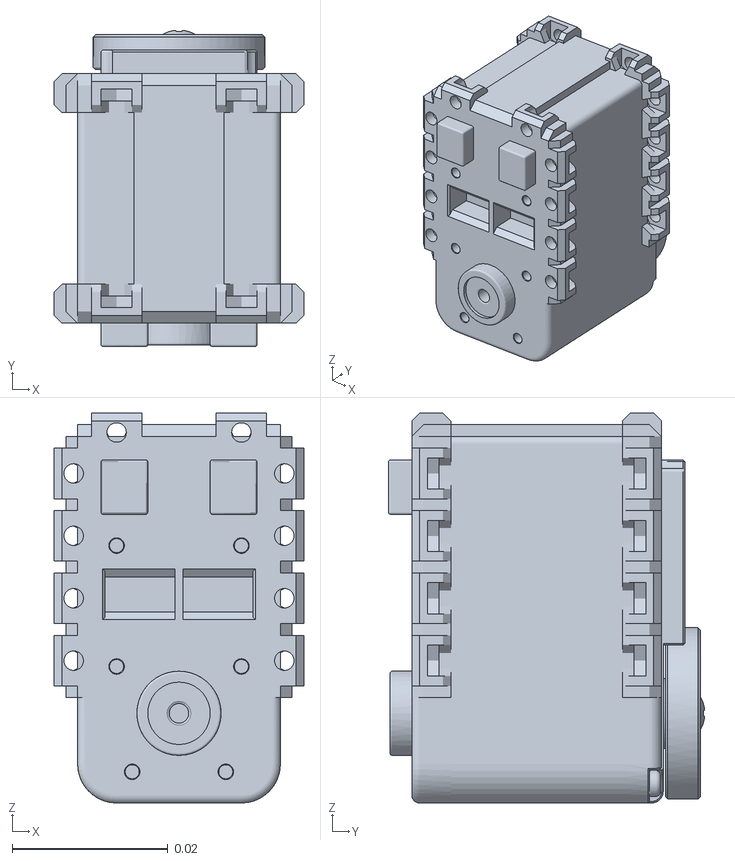
[picture p86: CAD file, 2019-12-04]
MATLAB/Circle Test Animation Final/STL/Link6motor.STL
0.032 x 0.0405 x 0.05
