treydufrene/meiosis_dev/MATLAB/Circle Test Animation Final/STL/Link3belt.STL

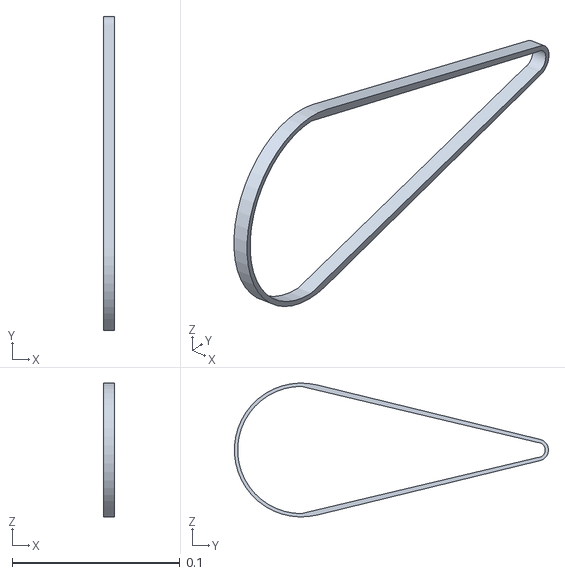
[picture p87: CAD file, 2019-12-04]
MATLAB/Circle Test Animation Final/STL/Link3belt.STL
0.00635 x 0.187 x 0.0799
