treydufrene/meiosis_dev/MATLAB/Circle Test Animation Final/STL/Link2tube.STL

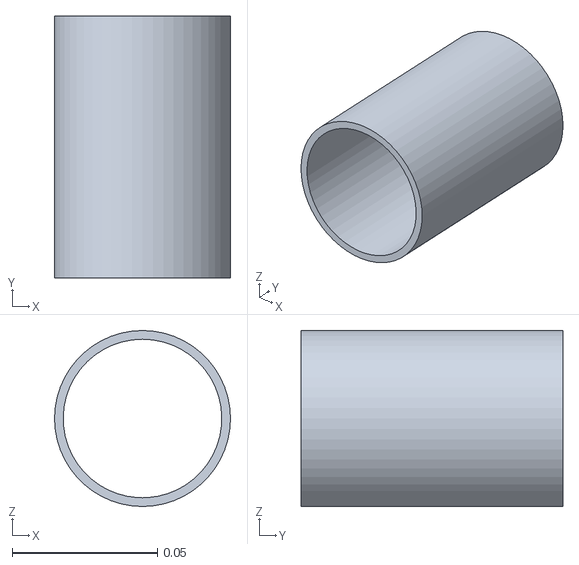
[picture p88: CAD file, 2019-12-04]
MATLAB/Circle Test Animation Final/STL/Link2tube.STL
0.0605 x 0.09 x 0.0605
