treydufrene/meiosis_dev/MATLAB/Circle Test Animation Final/STL/Base.STL

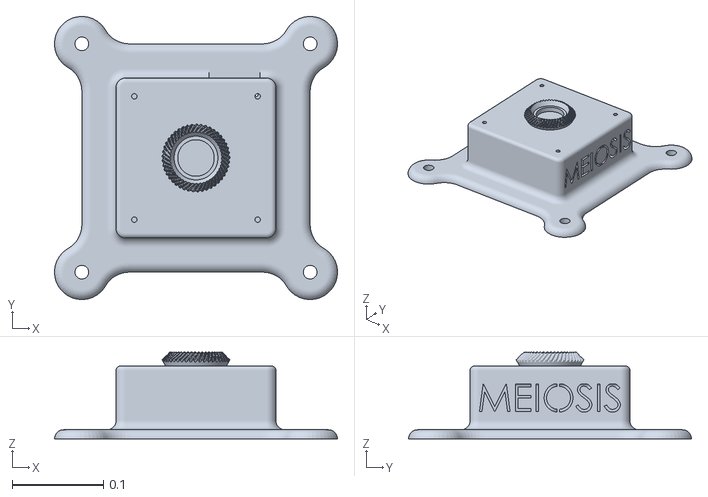
[picture p89: CAD file, 2019-11-24]
MATLAB/Circle Test Animation Final/STL/Base.STL
0.31 x 0.31 x 0.095
