treydufrene/meiosis_dev/MATLAB/Circle Test Animation Final/STL/Link4.STL

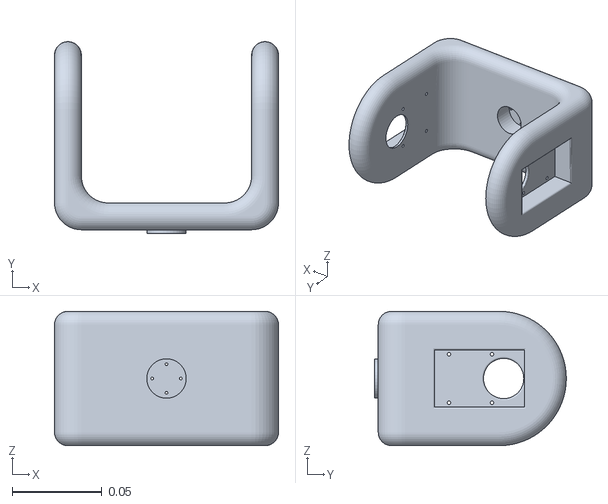
[picture p90: CAD file, 2019-11-24]
MATLAB/Circle Test Animation Final/STL/Link4.STL
0.125 x 0.107 x 0.075
