treydufrene/meiosis_dev/MATLAB/Circle Test Animation Final/STL/Link5.STL

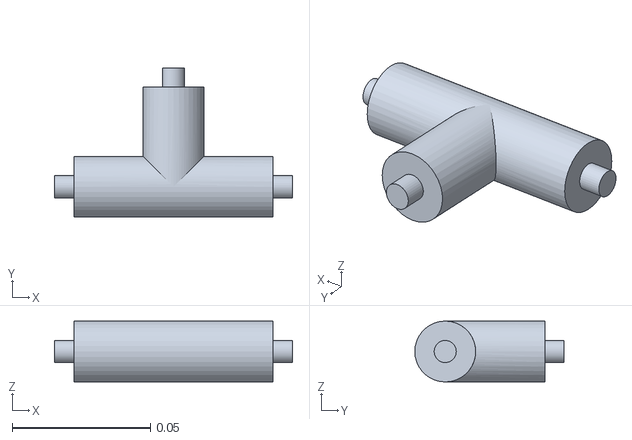
[picture p91: CAD file, 2019-11-24]
MATLAB/Circle Test Animation Final/STL/Link5.STL
0.086 x 0.054 x 0.022
