treydufrene/meiosis_dev/MATLAB/Circle Test Animation Final/STL/Link1.STL

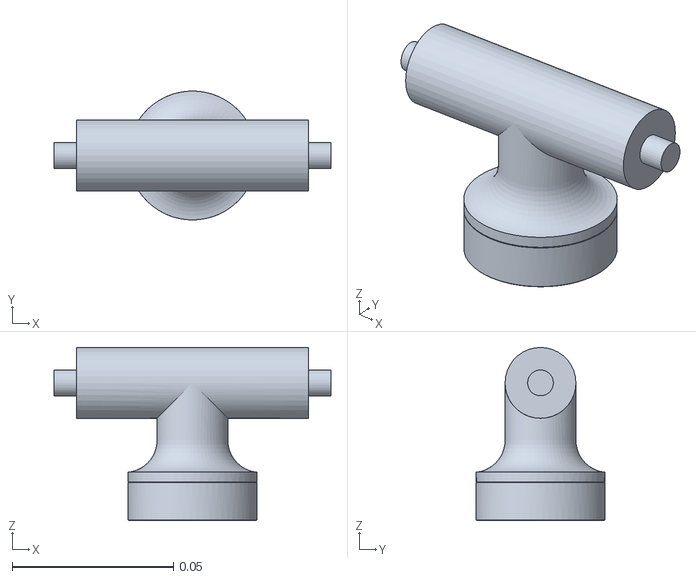
[picture p92: CAD file, 2019-11-24]
MATLAB/Circle Test Animation Final/STL/Link1.STL
0.086 x 0.04 x 0.0538
