treydufrene/meiosis_dev/MATLAB/Circle Test Animation Final/STL/Gear4.STL

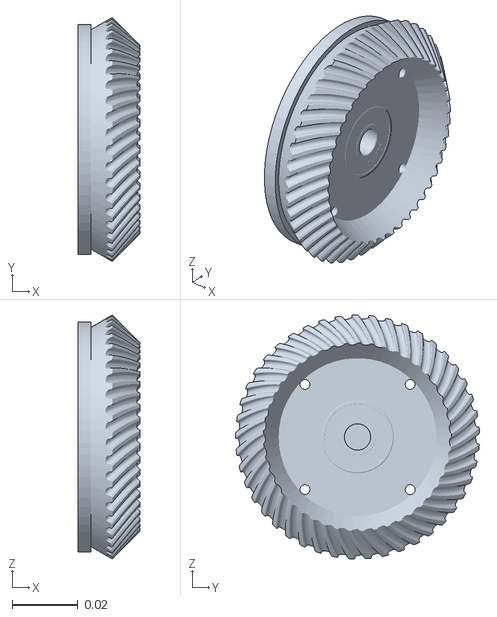
[picture p93: CAD file, 2019-11-24]
MATLAB/Circle Test Animation Final/STL/Gear4.STL
0.019 x 0.0742 x 0.0742
