treydufrene/meiosis_dev/(list of files, cad)

Other CAD files:
MATLAB/Circle Test Animation Final/STL/Pulley2.STL
MATLAB/Circle Test Animation Final/STL/Gear1.STL
MATLAB/Circle Test Animation Final/STL/Gear3.STL
MATLAB/Closed Loop Animation/STL2/Base.STL
MATLAB/Closed Loop Animation/STL2/Gear1.STL
MATLAB/Closed Loop Animation/STL2/Gear2.STL
MATLAB/Closed Loop Animation/STL2/Gear3.STL
MATLAB/Closed Loop Animation/STL2/Gear4.STL
MATLAB/Closed Loop Animation/STL2/Link1.STL
MATLAB/Closed Loop Animation/STL2/Link3.STL
MATLAB/Closed Loop Animation/STL2/Link4.STL
MATLAB/Closed Loop Animation/STL2/Link5.STL
MATLAB/Closed Loop Animation/STL2/Link6.STL
MATLAB/Open Loop Animation/STL/Base.STL
MATLAB/Open Loop Animation/STL/Link1.STL
MATLAB/Open Loop Animation/STL/Link2.STL
MATLAB/Open Loop Animation/STL/Link3.STL
MATLAB/Open Loop Animation/STL/Link4.STL
MATLAB/Open Loop Animation/STL/Link5.STL
MATLAB/Open Loop Animation/STL/Link6.STL
MATLAB/Open Loop Animation/STL2/Base.STL
MATLAB/Open Loop Animation/STL2/Gear1.STL
MATLAB/Open Loop Animation/STL2/Gear2.STL
MATLAB/Open Loop Animation/STL2/Gear3.STL
MATLAB/Open Loop Animation/STL2/Gear4.STL
MATLAB/Open Loop Animation/STL2/Link1.STL
MATLAB/Open Loop Animation/STL2/Link3.STL
MATLAB/Open Loop Animation/STL2/Link4.STL
MATLAB/Open Loop Animation/STL2/Link5.STL
MATLAB/Open Loop Animation/STL2/Link6.STL
MATLAB/STL/Base.STL
MATLAB/STL/Link1.STL
MATLAB/STL/Link2.STL
MATLAB/STL/Link3.STL
MATLAB/STL/Link4.STL
MATLAB/STL/Link5.STL
MATLAB/STL/Link6.STL
