treydufrene/meiosis_dev/MATLAB/Closed Loop Animation/test.pdf

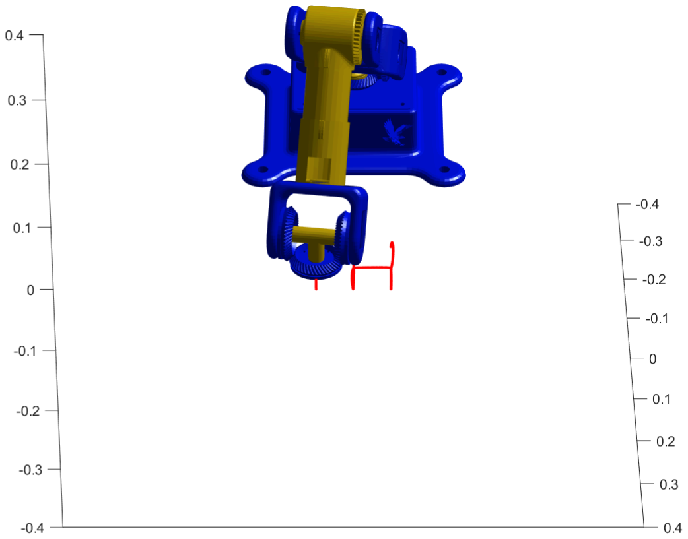
[picture p107: page 1]
