treydufrene/meiosis_dev/python/todo.md

### Utility Functions
- Servo commands, from C.L. to "servo-space"
- Encoder

### Higher Level 
- Jacobian
- H,d,G
- Path Planning
- Trajectory Generation
- GUI
