treydufrene/meiosis_dev/MATLAB/Circle Test Animation Final/JointAnglePlot.pdf

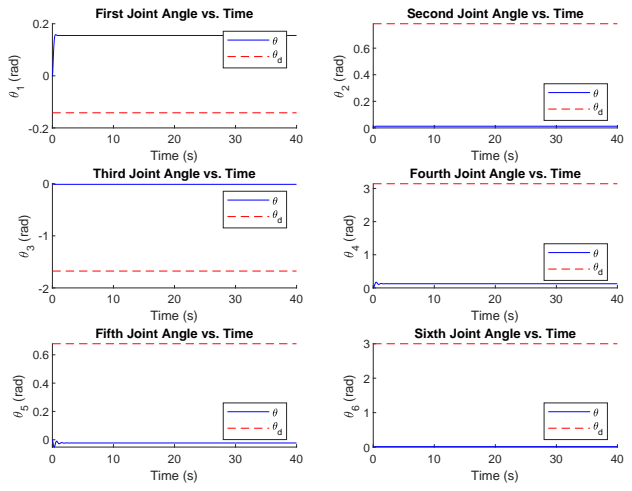
[picture p108: page 1]
Time (s); 1 (rad); 2 (rad); 3 (rad); 4 (rad); 5 (rad); 6 (rad)

First Joint Angle vs. Time

Second Joint Angle vs. Time

Third Joint Angle vs. Time

Fourth Joint Angle vs. Time

Fifth Joint Angle vs. Time

Sixth Joint Angle vs. Time
