treydufrene/meiosis_dev/LaTeX/cdr/images/ElectricalSchematic2.pdf

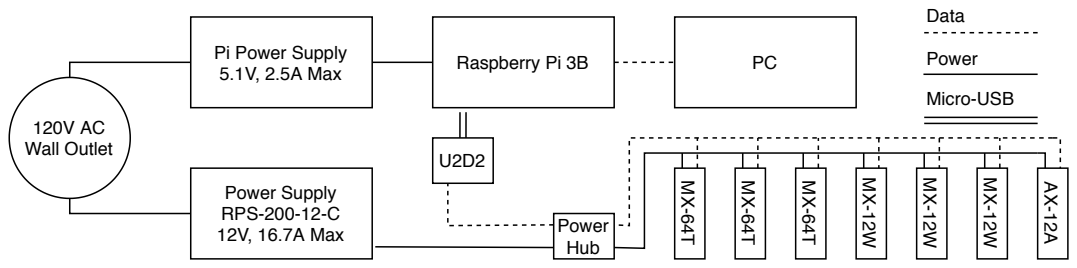
[picture p109: page 1]
Power Supply RPS-200-12-C 12V, 16.7A Max; 5.1V, 2.5A Max; Raspberry Pi 3B; Power Hub; Data; Power; Micro-USB

Pi Power Supply

120V AC Wall Outlet
