treydufrene/meiosis_dev/LaTeX/cdr/images/drawings.PDF

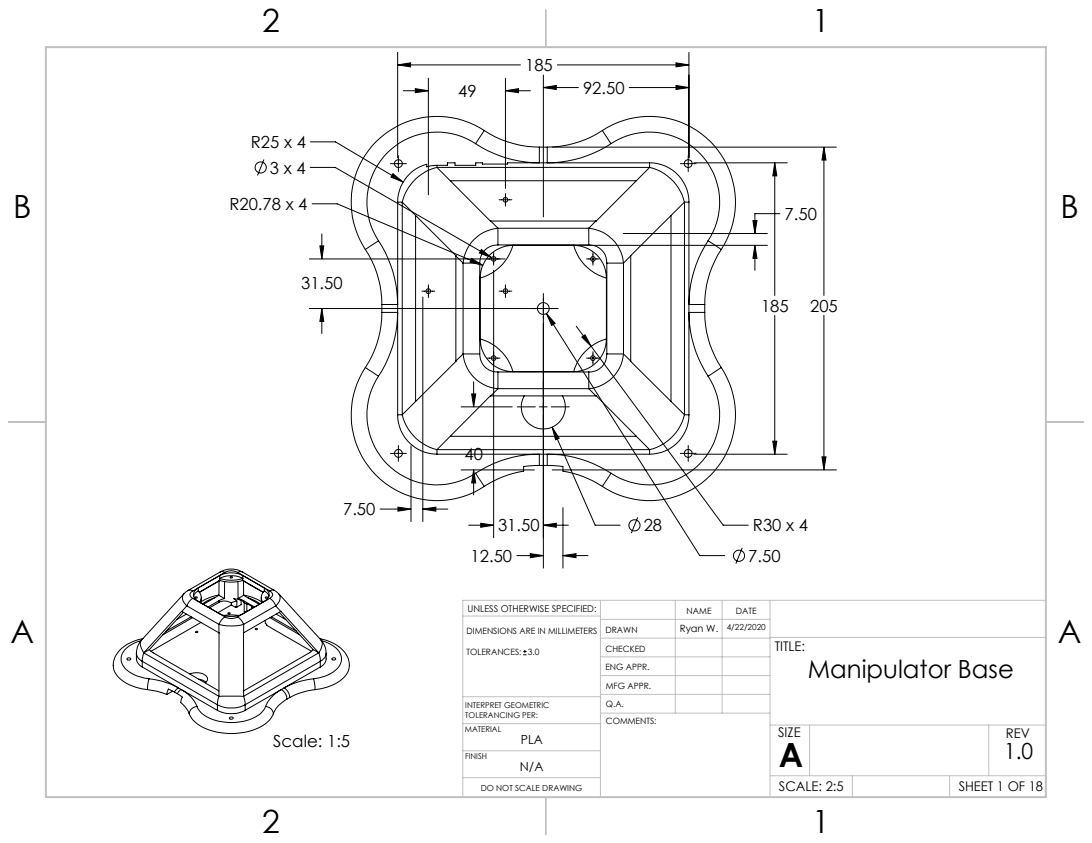
[picture p110: page 1]
Scale: 1:5; DO NOT SCALE DRAWING; SHEET 1 OF 18; SCALE: 2:5; N/A FINISH

UNLESS OTHERWISE SPECIFIED: | | NAME | DATE
DIMENSIONS ARE IN MILLIMETERS TOLERANCES: 3.0 | DRAWN | Ryan W. | 4/22/2020

CHECKED | | | TITLE: Manipulator Base

ENG APPR.
MFG APPR.

INTERPRET GEOMETRIC TOLERANCING PER: | Q.A.

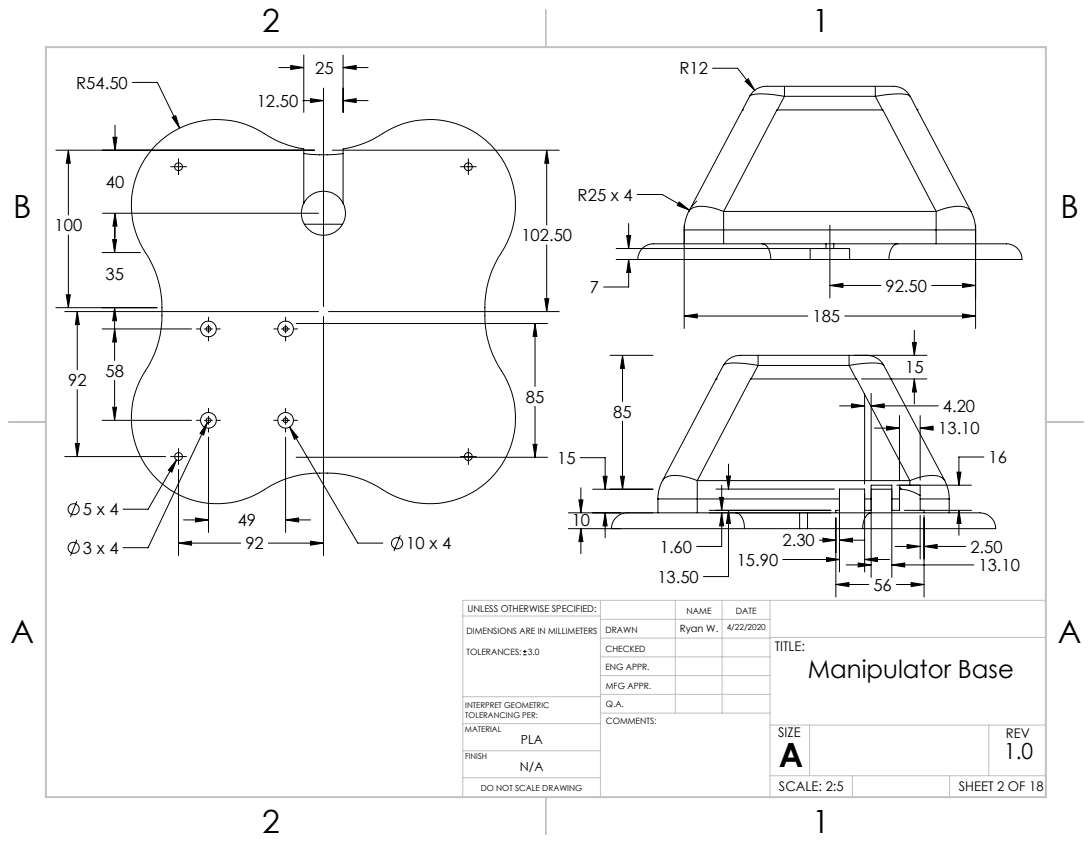
[picture p111: page 2]
SCALE: 2:5; N/A FINISH

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

CHECKED | | | TITLE: Manipulator Base

ENG APPR.
MFG APPR.

INTERPRET GEOMETRIC TOLERANCING PER: | Q.A.

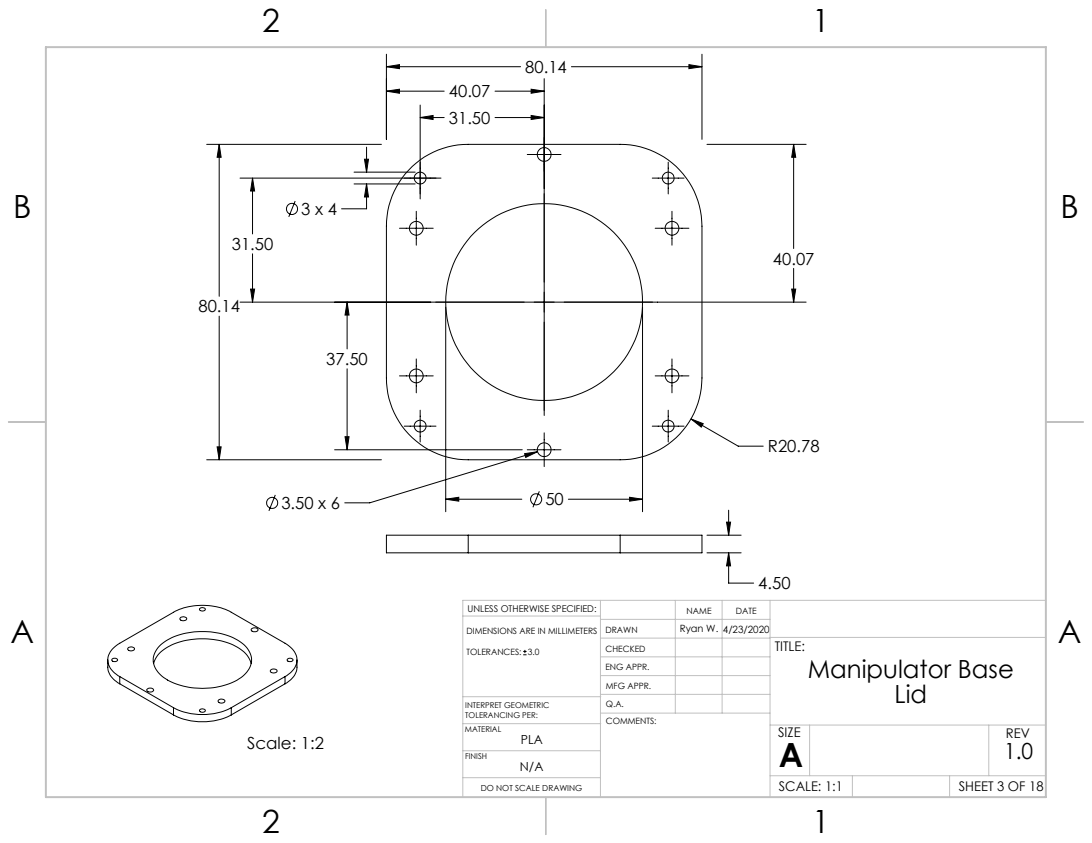
[picture p112: page 3]
Scale: 1:2; SCALE: 1:1; N/A FINISH

UNLESS OTHERWISE SPECIFIED: | | NAME | DATE
DIMENSIONS ARE IN MILLIMETERS TOLERANCES: 3.0 | DRAWN | Ryan W. | 4/23/2020

CHECKED | | | TITLE: Manipulator Base Lid

ENG APPR.
MFG APPR.

INTERPRET GEOMETRIC TOLERANCING PER: | Q.A.

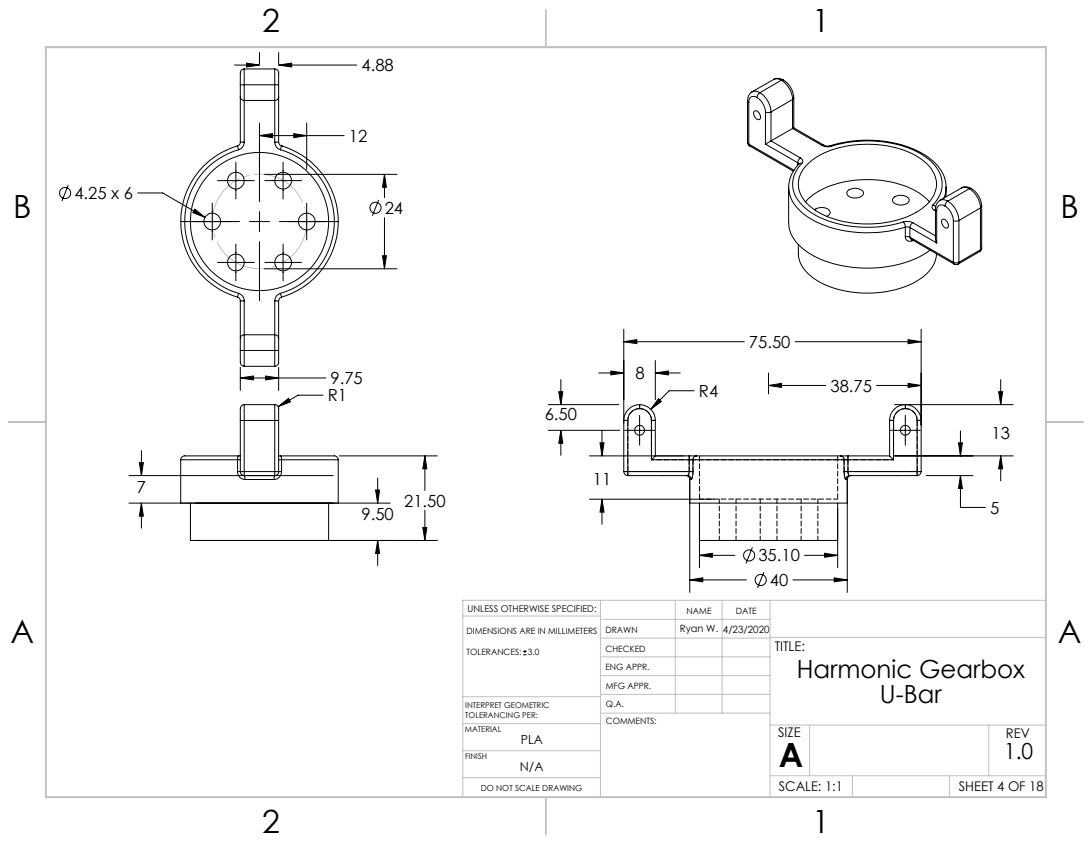
[picture p113: page 4]
N/A FINISH

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

CHECKED | | | TITLE: Harmonic Gearbox U-Bar

ENG APPR.
MFG APPR.

INTERPRET GEOMETRIC TOLERANCING PER: | Q.A.

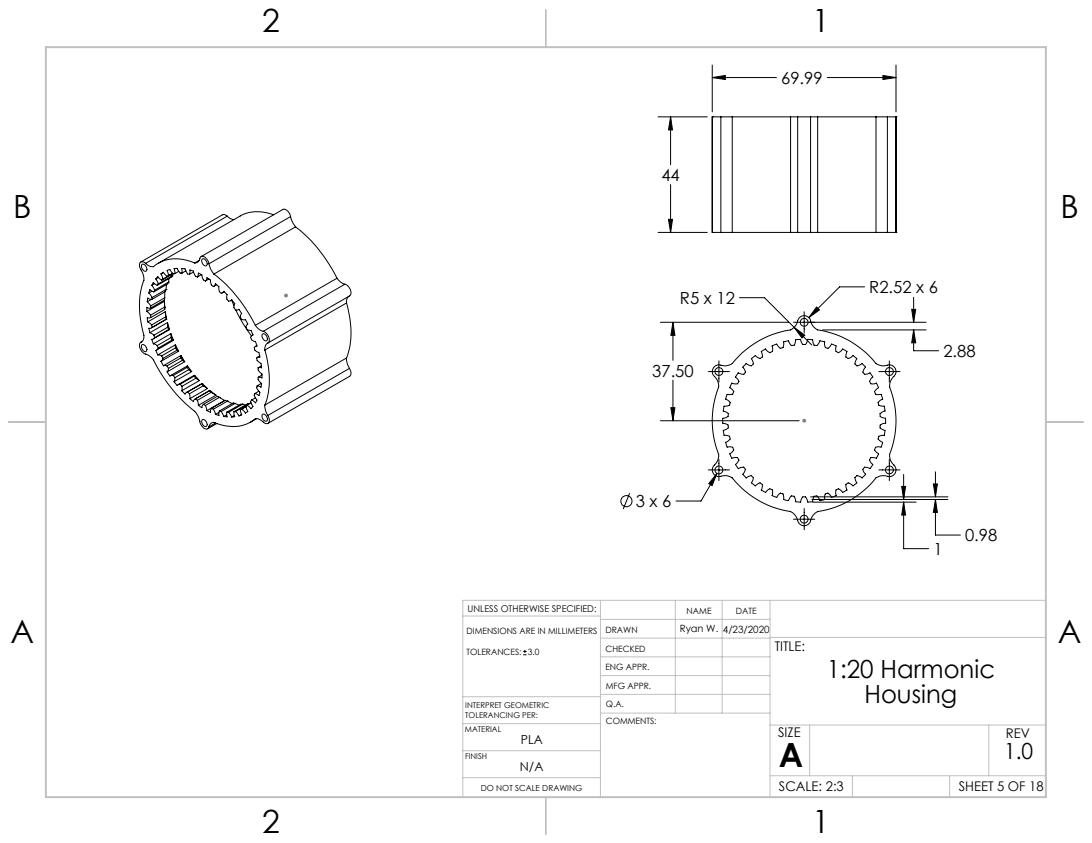
[picture p114: page 5]
SCALE: 2:3; N/A FINISH

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

CHECKED | | | TITLE: 1:20 Harmonic Housing

ENG APPR.
MFG APPR.

INTERPRET GEOMETRIC TOLERANCING PER: | Q.A.

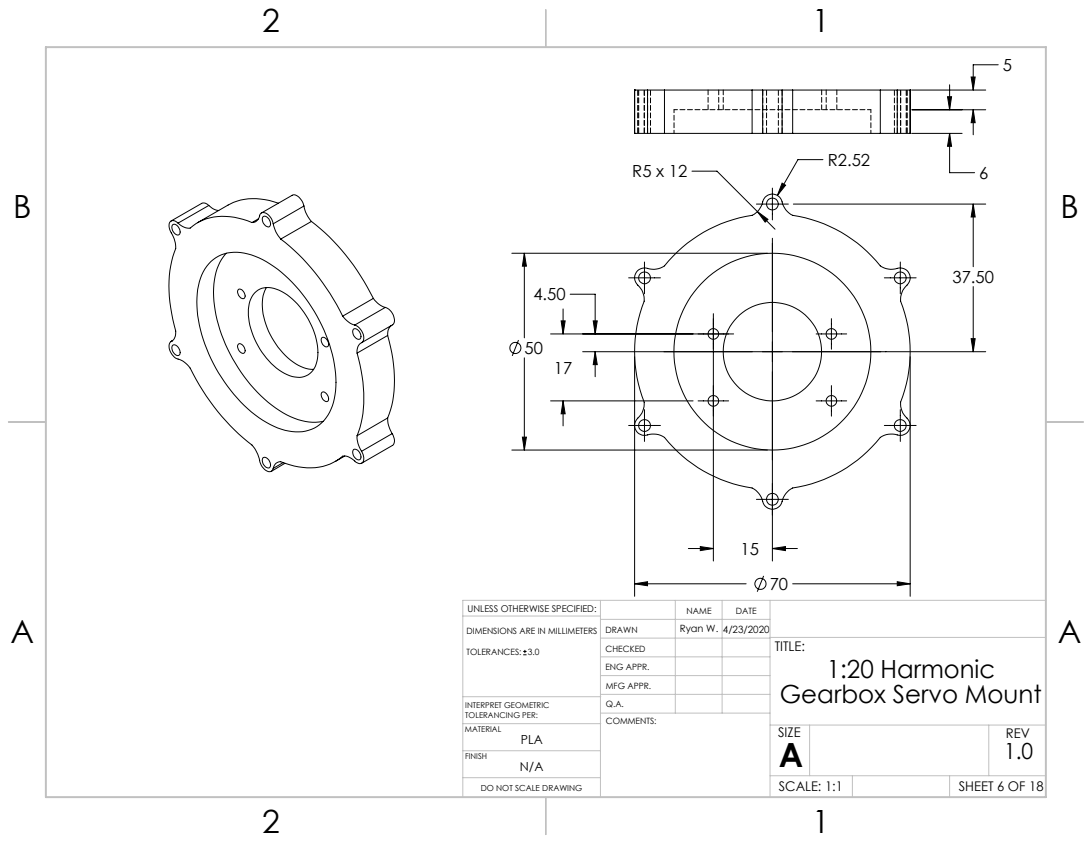
[picture p115: page 6]
N/A FINISH

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

CHECKED | | | TITLE: 1:20 Harmonic Gearbox Servo Mount

ENG APPR.
MFG APPR.

INTERPRET GEOMETRIC TOLERANCING PER: | Q.A.

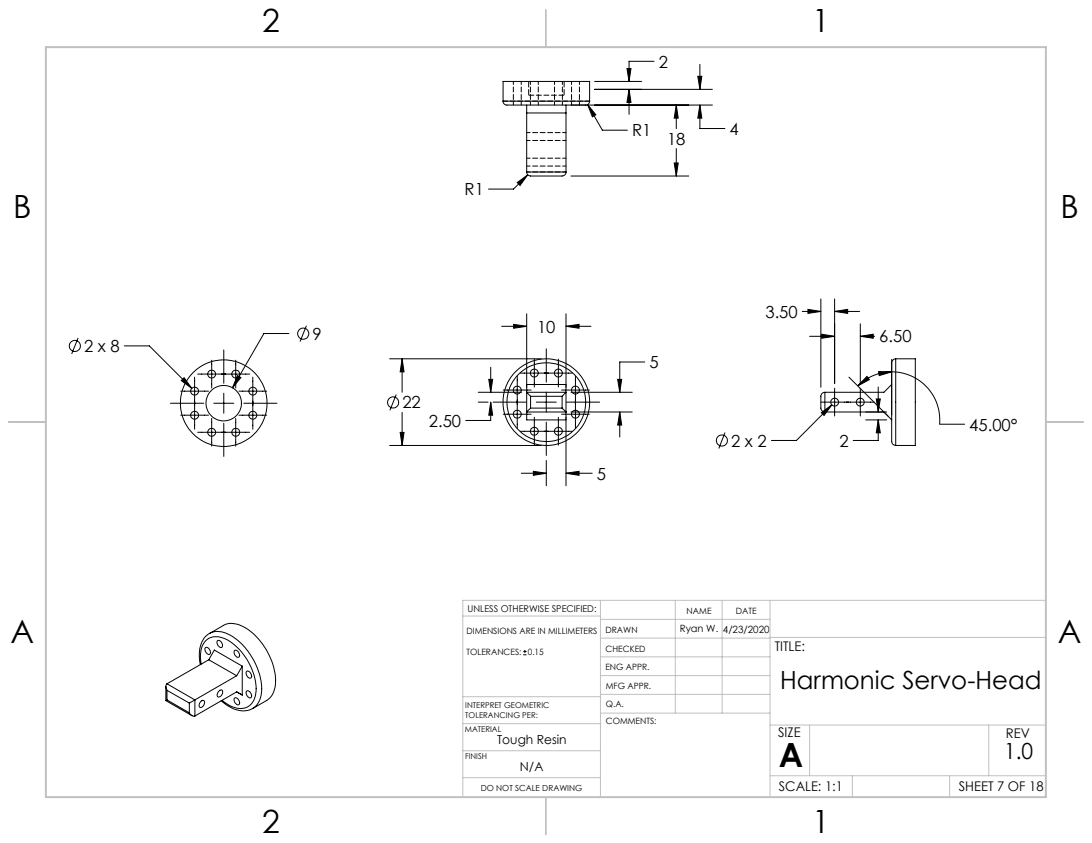
[picture p116: page 7]
Tough Resin; N/A FINISH

UNLESS OTHERWISE SPECIFIED: | | NAME | DATE
DIMENSIONS ARE IN MILLIMETERS TOLERANCES: 0.15 | DRAWN | Ryan W. | 4/23/2020

CHECKED | | | TITLE: Harmonic Servo-Head

ENG APPR.
MFG APPR.

INTERPRET GEOMETRIC TOLERANCING PER: | Q.A.

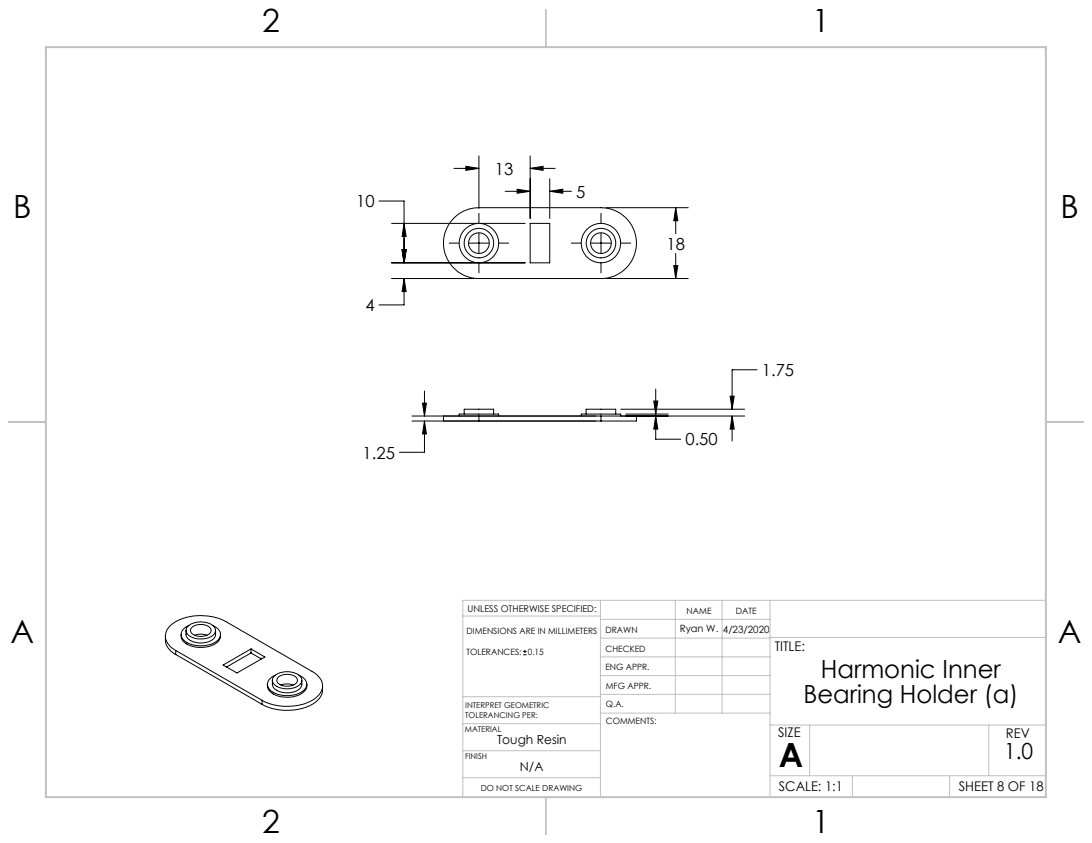
[picture p117: page 8]
Tough Resin; N/A FINISH

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

CHECKED | | | TITLE: Harmonic Inner Bearing Holder (a)

ENG APPR.
MFG APPR.

INTERPRET GEOMETRIC TOLERANCING PER: | Q.A.

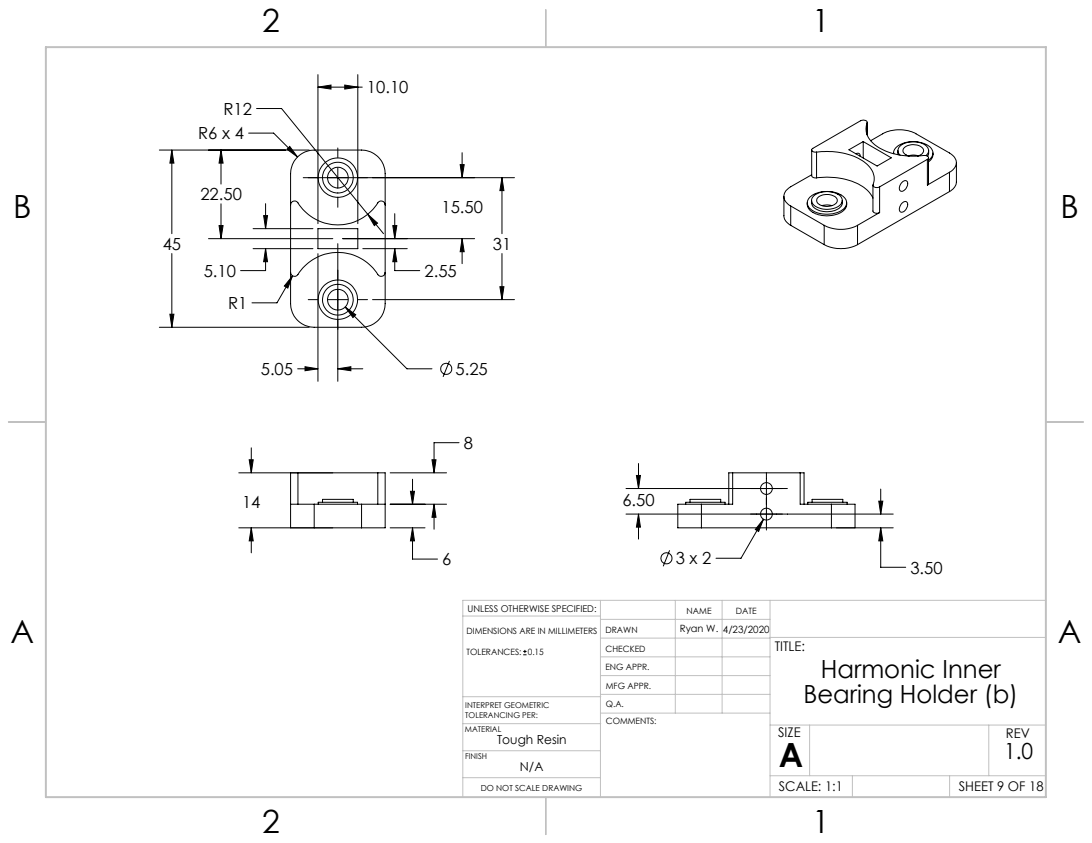
[picture p118: page 9]
Tough Resin; N/A FINISH

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

CHECKED | | | TITLE: Harmonic Inner Bearing Holder (b)

ENG APPR.
MFG APPR.

INTERPRET GEOMETRIC TOLERANCING PER: | Q.A.

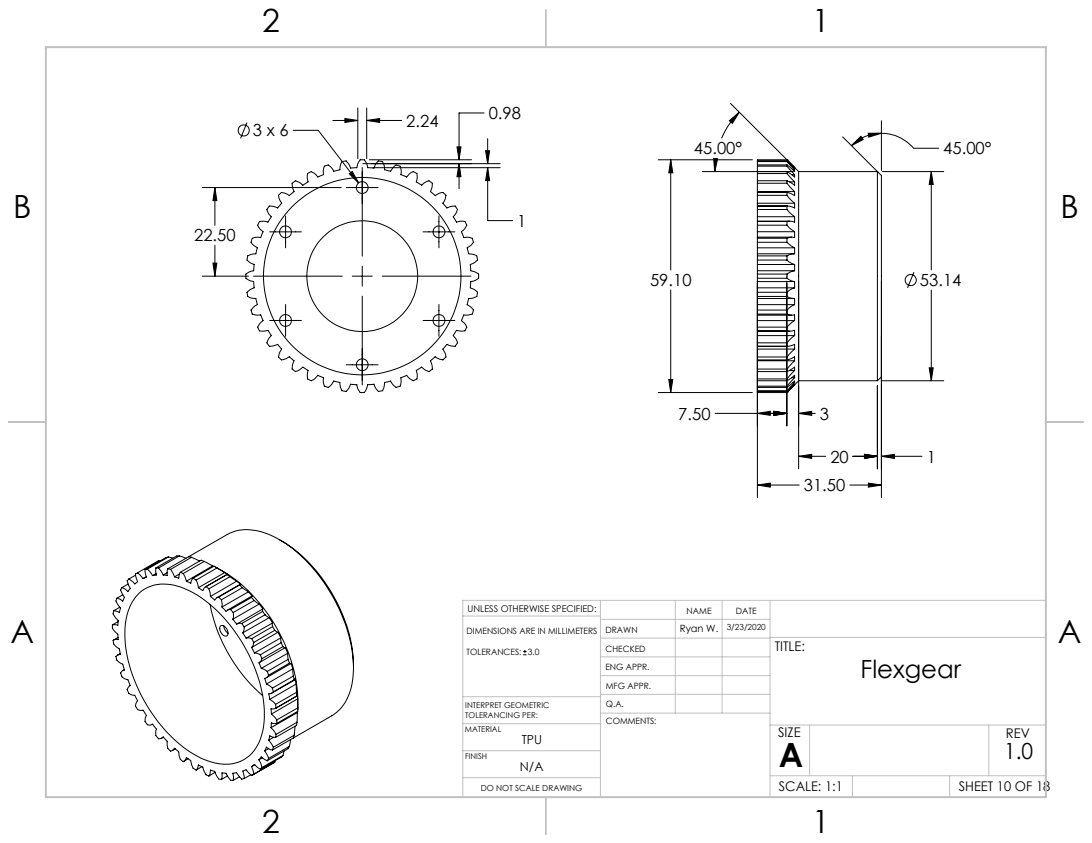
[picture p119: page 10]
N/A FINISH

UNLESS OTHERWISE SPECIFIED: | | NAME | DATE
DIMENSIONS ARE IN MILLIMETERS TOLERANCES: 3.0 | DRAWN | Ryan W. | 3/23/2020

CHECKED | | | TITLE: Flexgear

ENG APPR.
MFG APPR.

INTERPRET GEOMETRIC TOLERANCING PER: | Q.A.

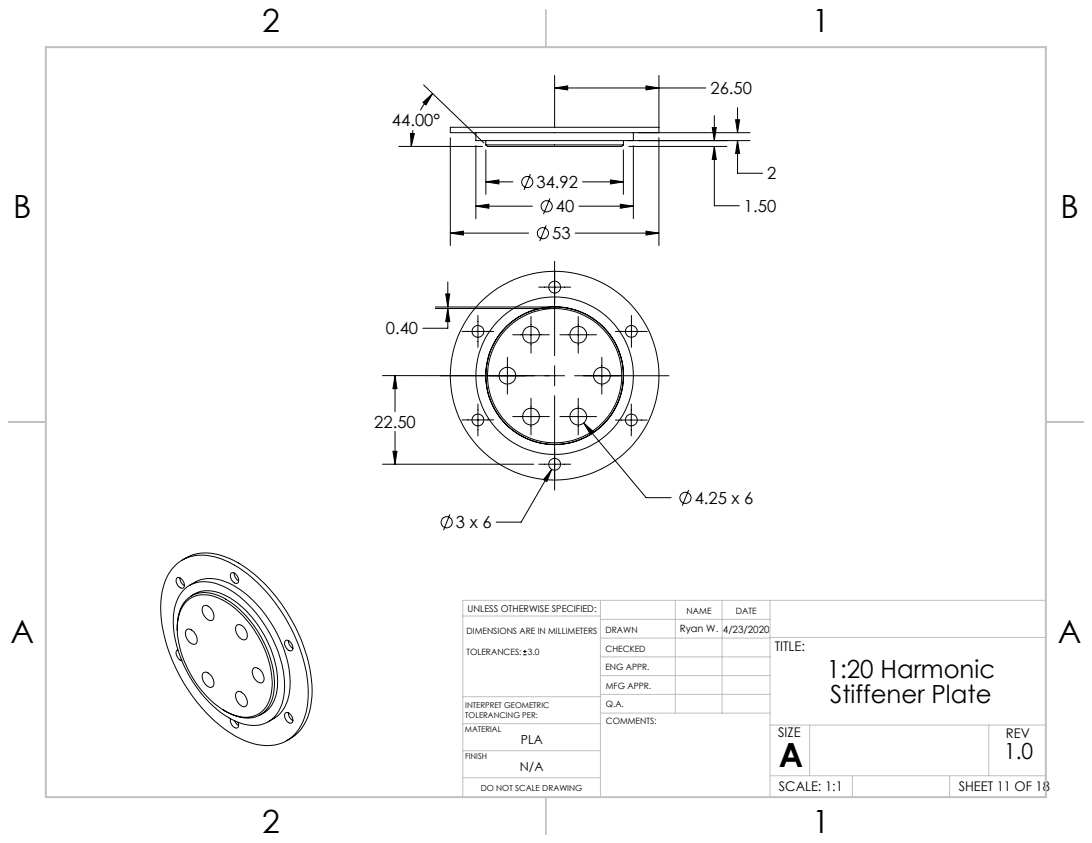
[picture p120: page 11]
N/A FINISH

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

CHECKED | | | TITLE: 1:20 Harmonic Stiffener Plate

ENG APPR.
MFG APPR.

INTERPRET GEOMETRIC TOLERANCING PER: | Q.A.

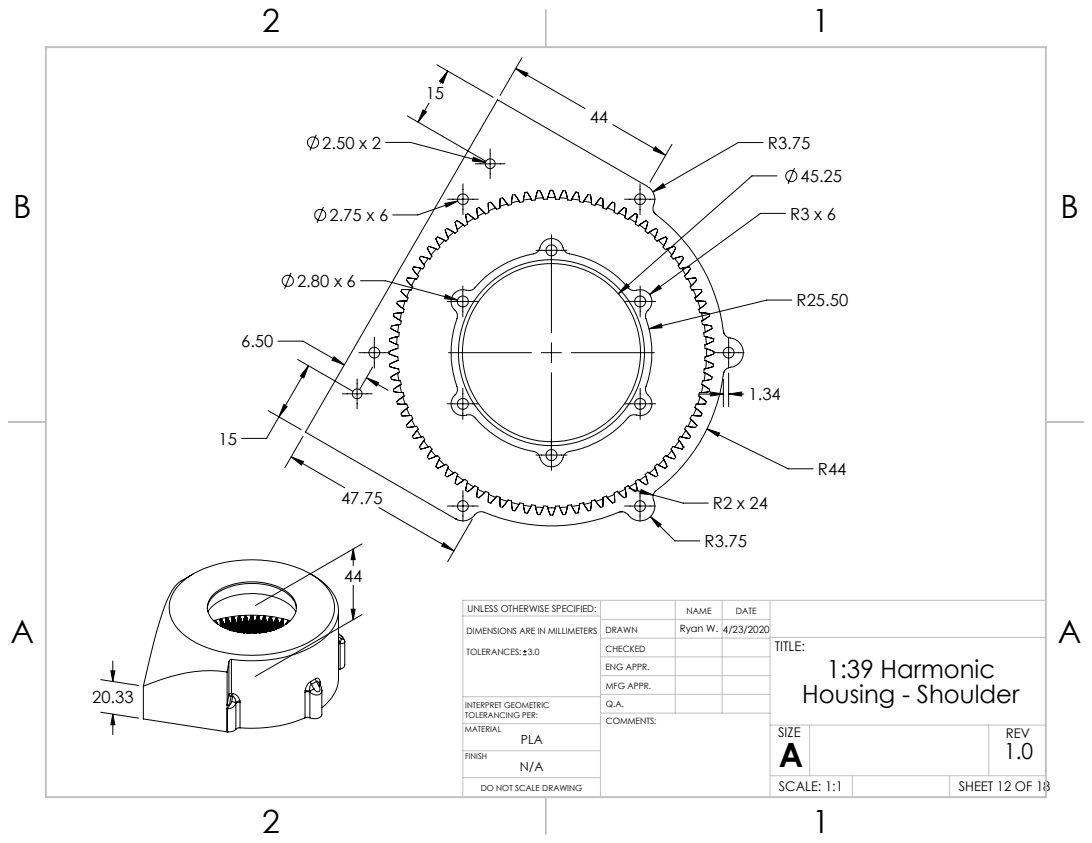
[picture p121: page 12]
N/A FINISH

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

CHECKED | | | TITLE: 1:39 Harmonic Housing - Shoulder

ENG APPR.
MFG APPR.

INTERPRET GEOMETRIC TOLERANCING PER: | Q.A.

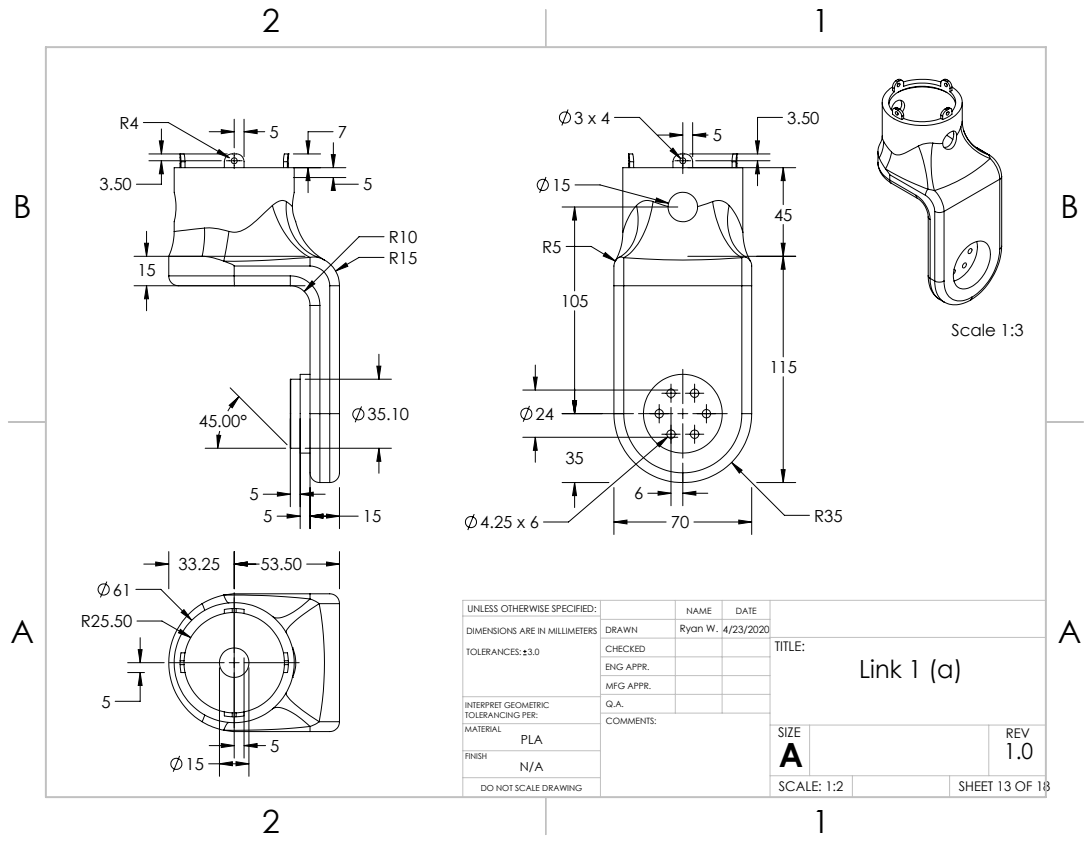
[picture p122: page 13]
Scale 1:3; N/A FINISH

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

CHECKED | | | TITLE: Link 1 (a)

ENG APPR.
MFG APPR.

INTERPRET GEOMETRIC TOLERANCING PER: | Q.A.

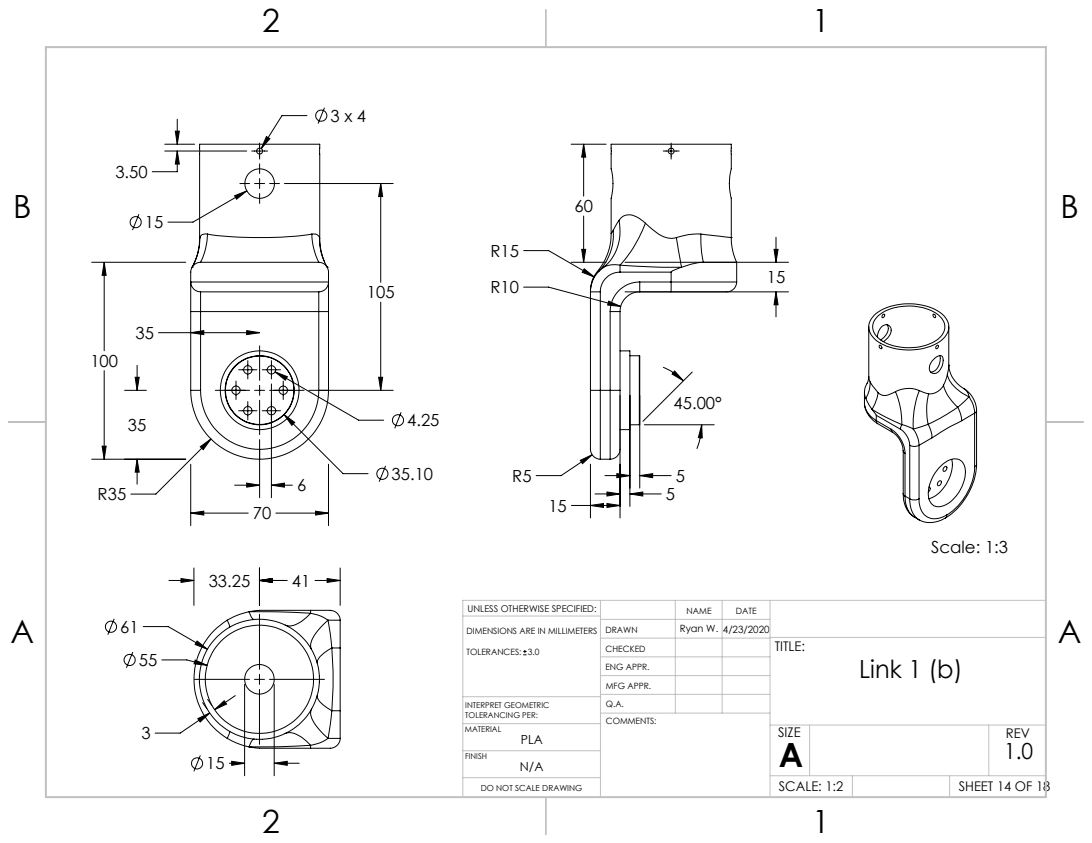
[picture p123: page 14]
Scale: 1:3; N/A FINISH

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

CHECKED | | | TITLE: Link 1 (b)

ENG APPR.
MFG APPR.

INTERPRET GEOMETRIC TOLERANCING PER: | Q.A.

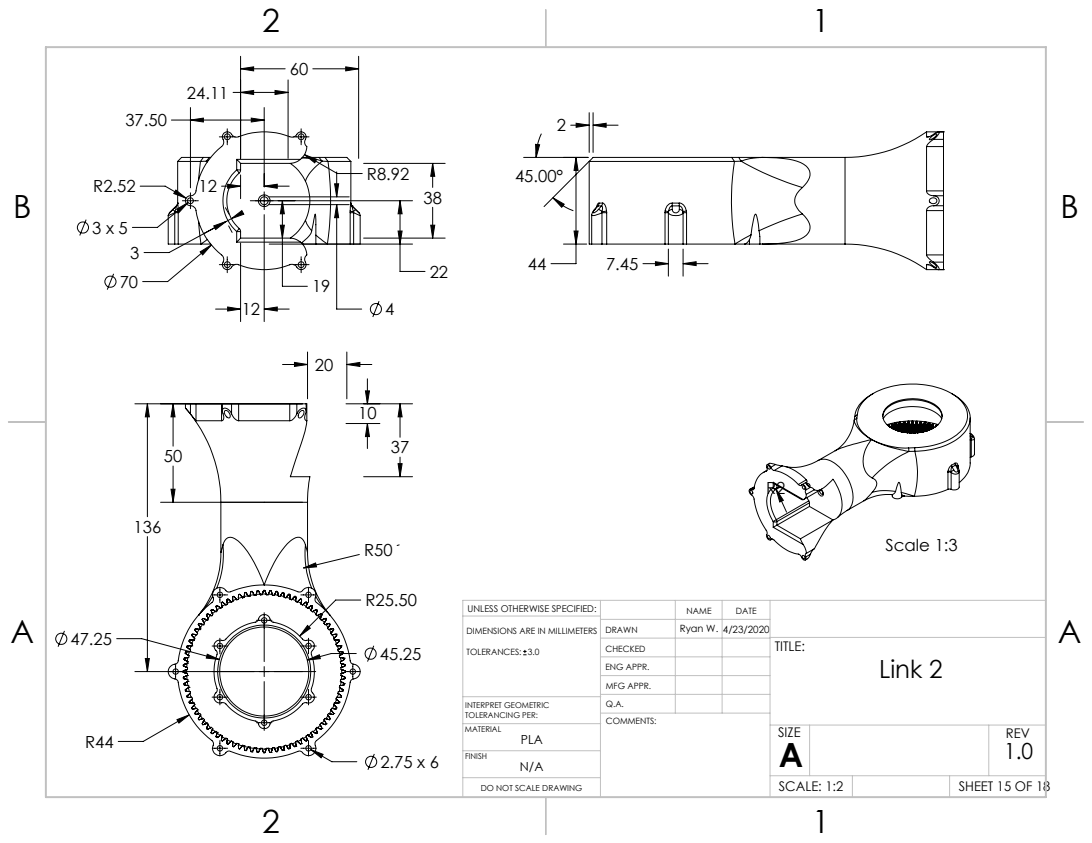
[picture p124: page 15]
Scale 1:3; N/A FINISH

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

CHECKED | | | TITLE: Link 2

ENG APPR.
MFG APPR.

INTERPRET GEOMETRIC TOLERANCING PER: | Q.A.

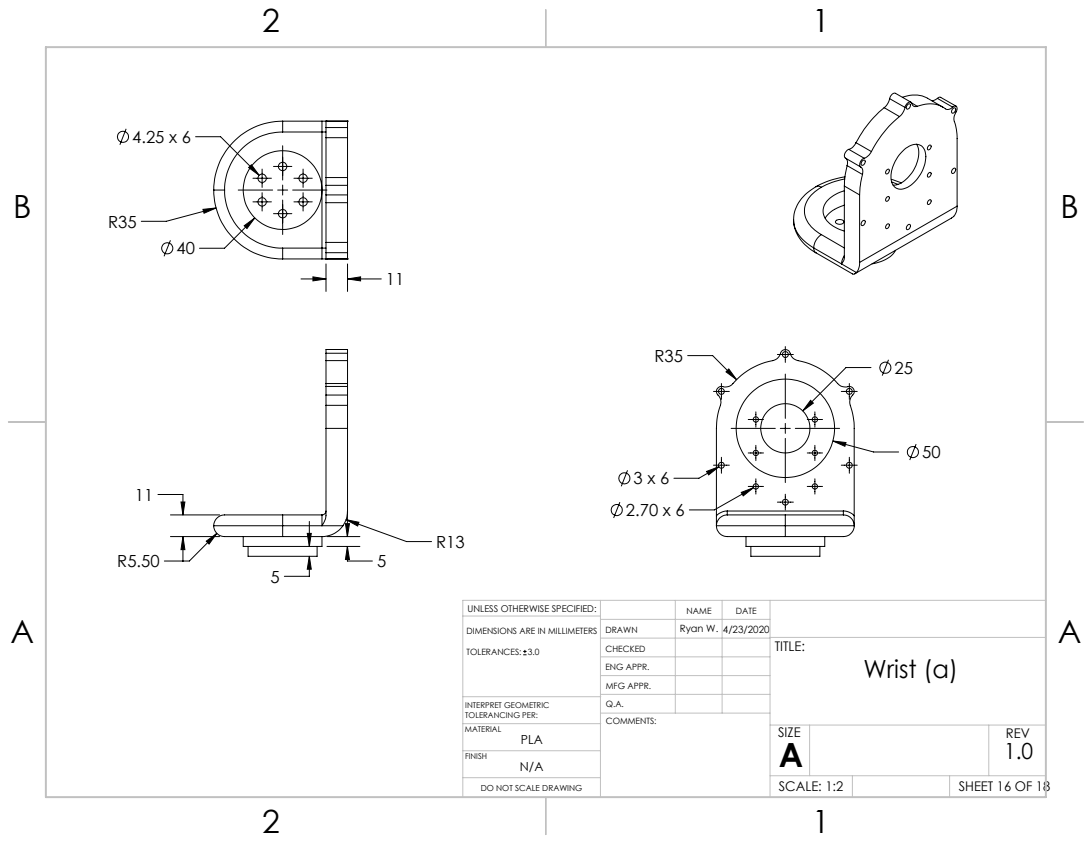
[picture p125: page 16]
N/A FINISH

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

CHECKED | | | TITLE: Wrist (a)

ENG APPR.
MFG APPR.

INTERPRET GEOMETRIC TOLERANCING PER: | Q.A.

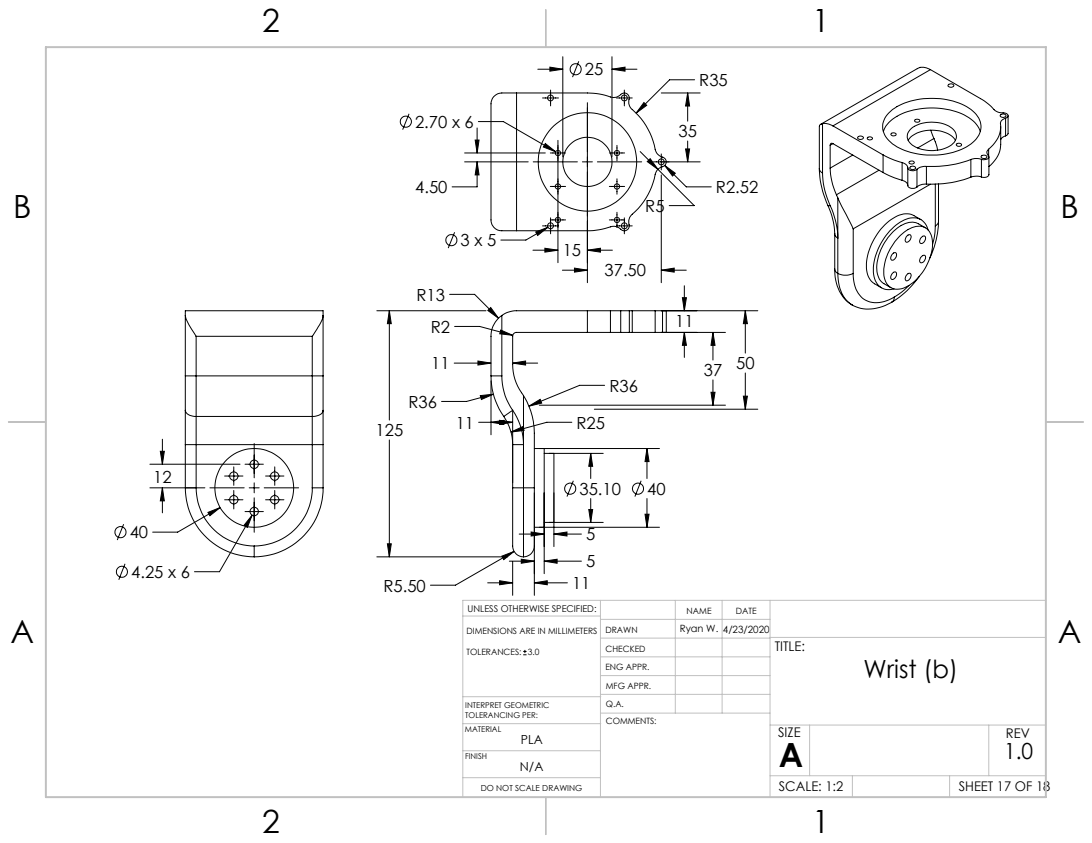
[picture p126: page 17]
N/A FINISH

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

CHECKED | | | TITLE: Wrist (b)

ENG APPR.
MFG APPR.

INTERPRET GEOMETRIC TOLERANCING PER: | Q.A.

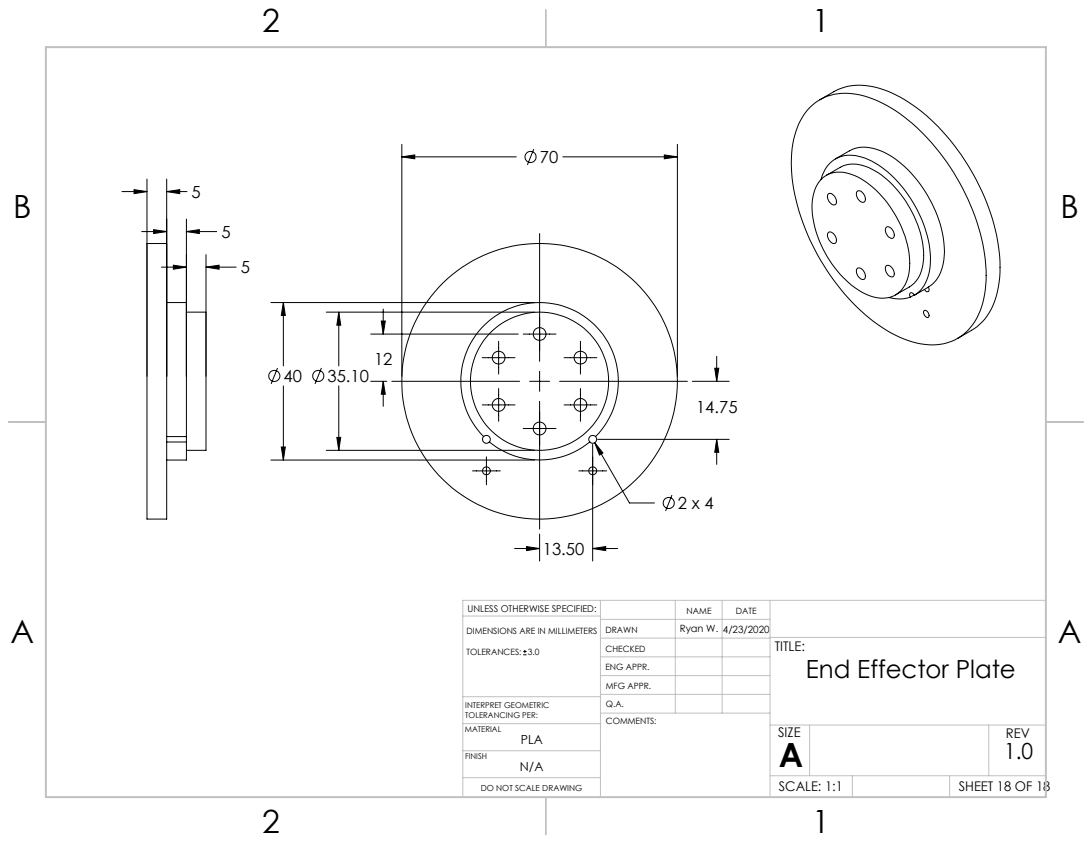
[picture p127: page 18]
N/A FINISH

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

CHECKED | | | TITLE: End Effector Plate

ENG APPR.
MFG APPR.

INTERPRET GEOMETRIC TOLERANCING PER: | Q.A.
