treydufrene/meiosis_dev/LaTeX/cdr/images/pulleys.pdf

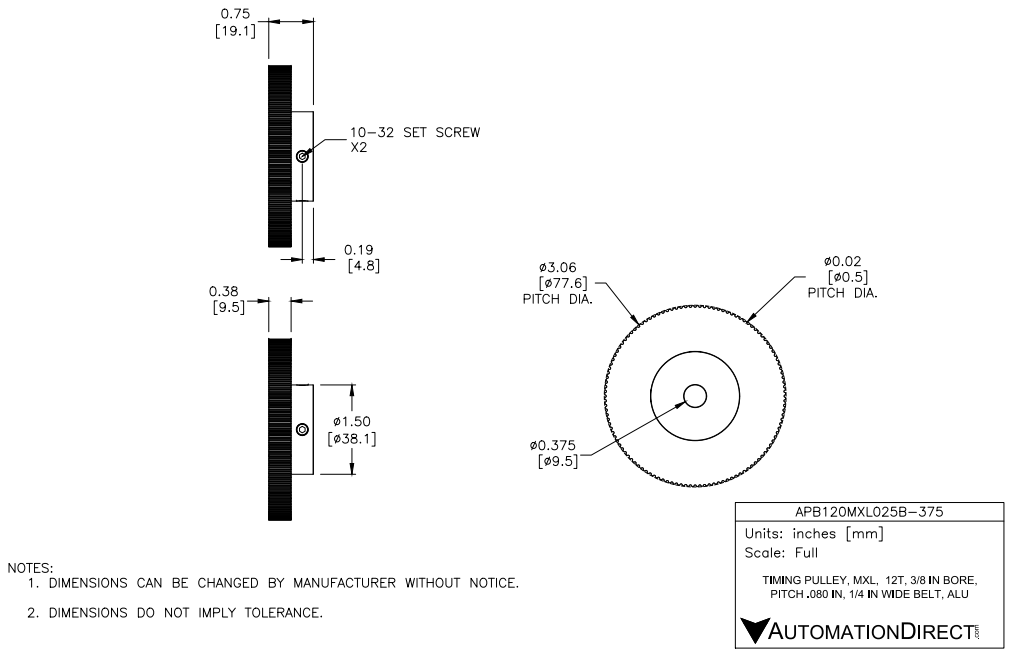
[picture p128: page 1]
TIMING PULLEY, MXL,; 12T, 3/8 IN BORE,

PITCH .080 IN, 1/4 IN WIDE BELT, ALU
AUTOMATIONDIRECT.com

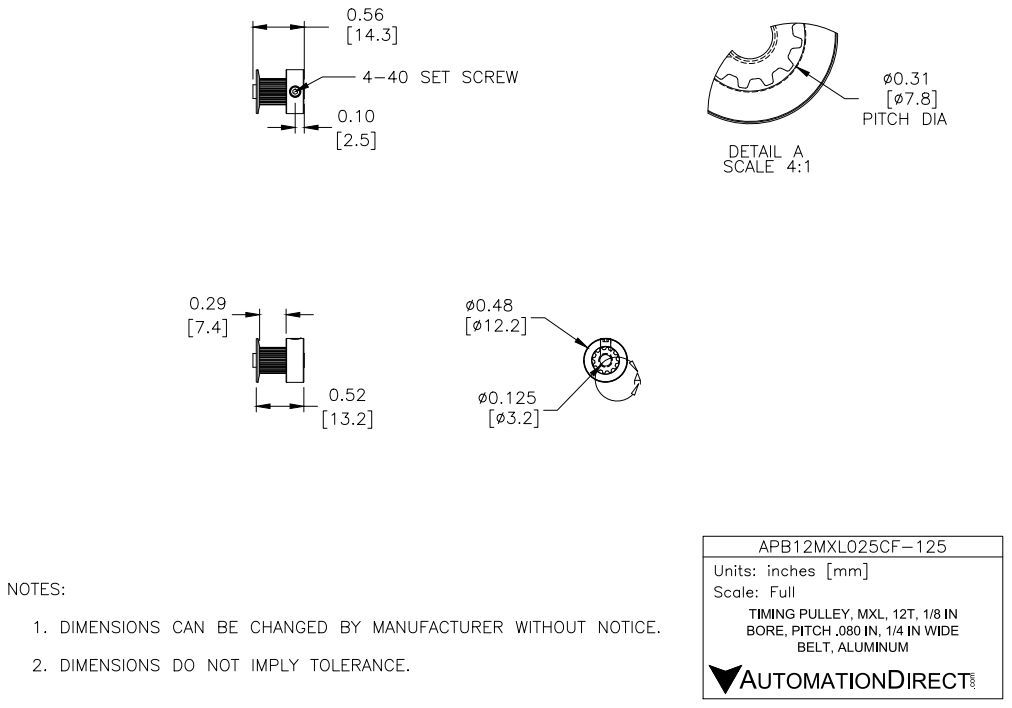
[picture p129: page 2]
BELT, ALUMINUM

TIMING PULLEY, MXL, 12T, 1/8 IN
BORE, PITCH .080 IN, 1/4 IN WIDE
AUTOMATIONDIRECT.com
