treydufrene/meiosis_dev/LaTeX/cdr/images/sf2.pdf

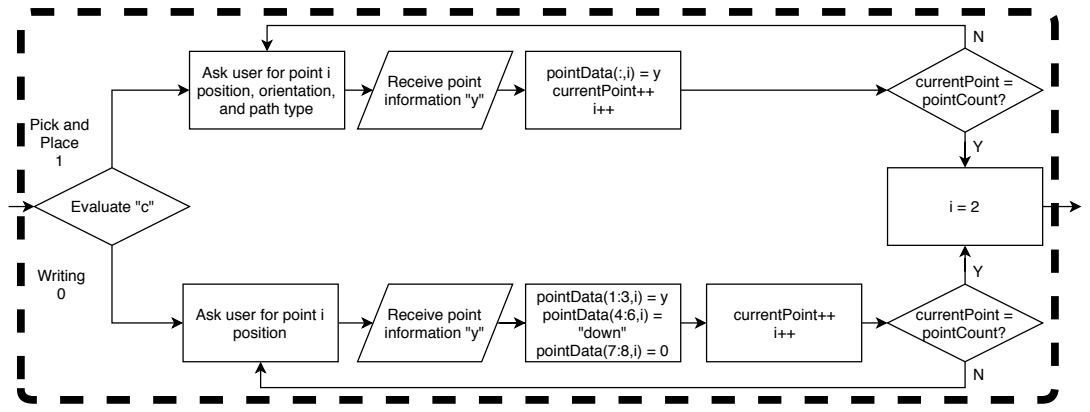
[picture p130: page 1]
Evaluate "c"; currentPoint = pointCount?; Receive point information "y"; pointData(:,i) = y currentPoint++ i++; pointData(1:3,i) = y pointData(4:6,i) = "down" pointData(7:8,i) = 0; currentPoint++ i++; Writing 0; Pick and Place 1

Ask user for point i
position, orientation,
and path type

position
