treydufrene/meiosis_dev/LaTeX/cdr/images/sf6.pdf

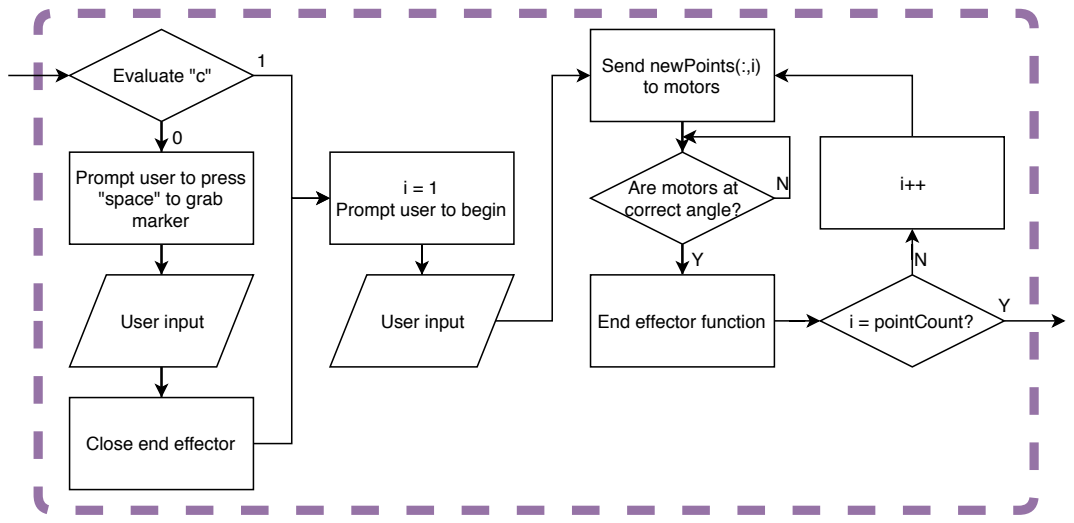
[picture p131: page 1]
Evaluate "c"; Send newPoints(:,i) to motors; i = pointCount?; Are motors at; correct angle?; User input; End effector function

Prompt user to press
"space" to grab
marker

Prompt user to begin

Close end effector
