treydufrene/meiosis_dev/LaTeX/cdr/images/soverall.pdf

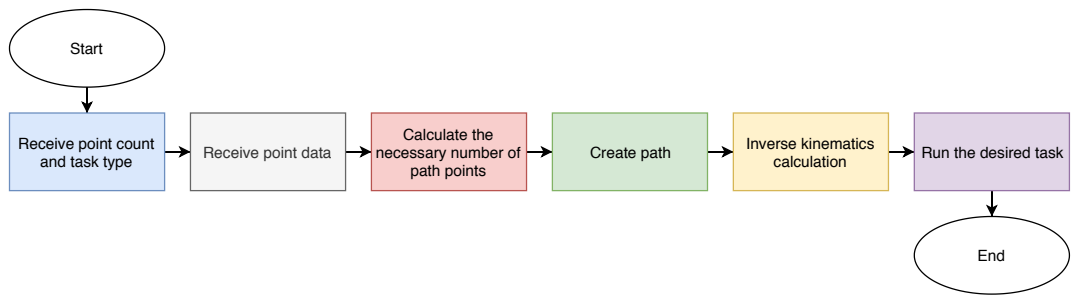
[picture p132: page 1]
Start; and task type; Receive point data; Create path; Inverse kinematics; calculation; Run the desired task; End

Calculate the
necessary number of
path points

Receive point count
