treydufrene/meiosis_dev/LaTeX/cdr/images/cljplots1.pdf

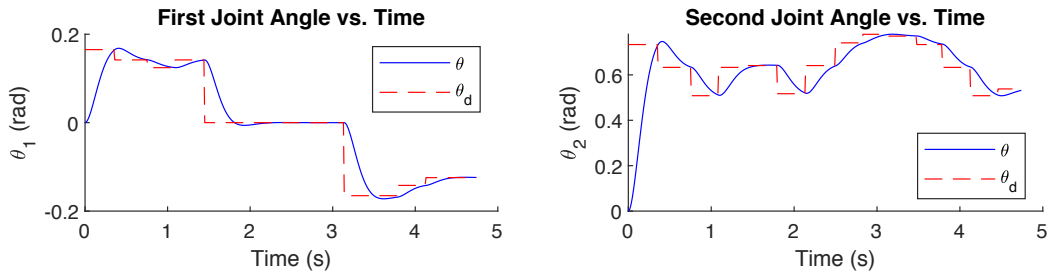
[picture p133: page 1]
Time (s); 1 (rad); 2 (rad)

First Joint Angle vs. Time

Second Joint Angle vs. Time
