treydufrene/meiosis_dev/LaTeX/cdr/images/cljplots2.pdf

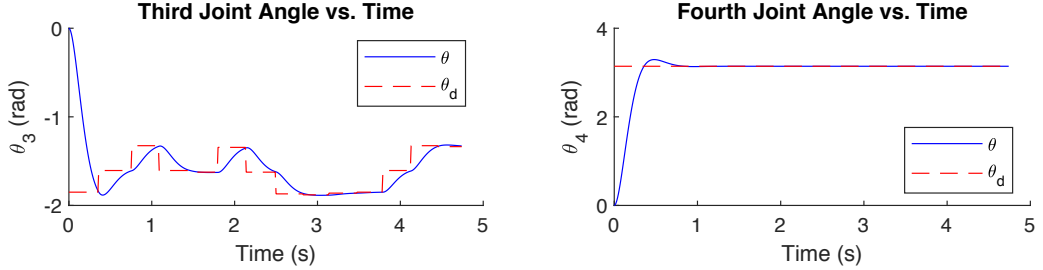
[picture p134: page 1]
Time (s); 3 (rad); 4 (rad)

Third Joint Angle vs. Time

Fourth Joint Angle vs. Time
