treydufrene/meiosis_dev/LaTeX/cdr/images/oljplots3.pdf

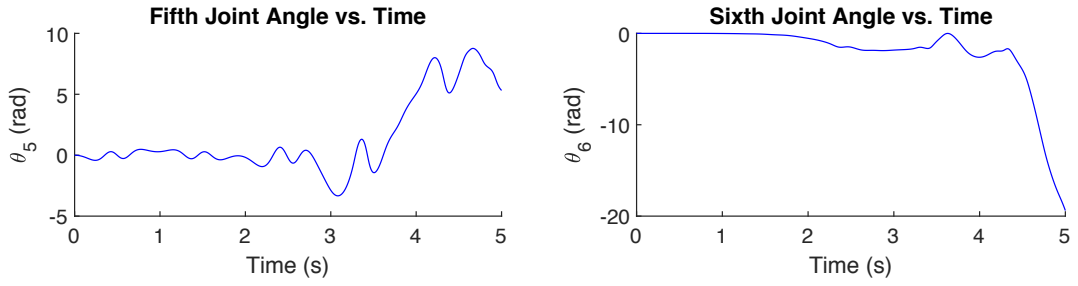
[picture p138: page 1]
Time (s); 5 (rad); 6 (rad)

Fifth Joint Angle vs. Time

Sixth Joint Angle vs. Time
