treydufrene/meiosis_dev/LaTeX/cdr/images/sflow.pdf

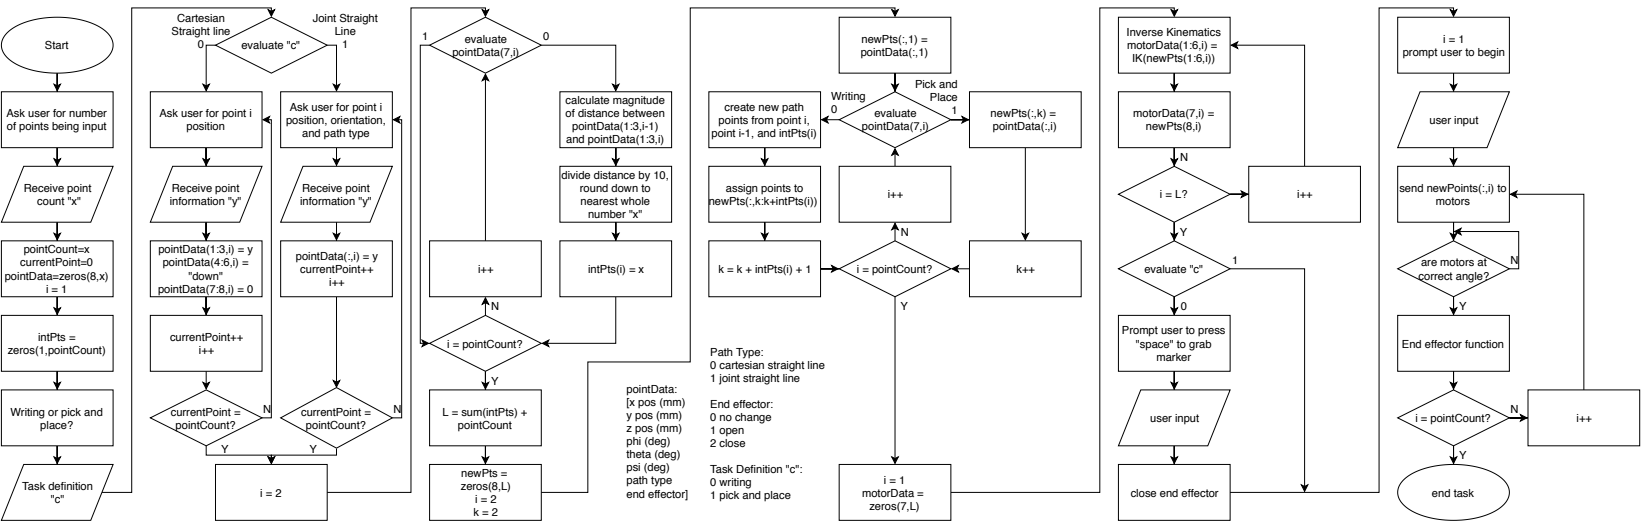
[picture p139: page 1]
Start; Task definition "c"; Receive point count "x"; pointCount=x currentPoint=0 pointData=zeros(8,x) i = 1; evaluate "c"; currentPoint = pointCount?; Receive point information "y"; pointData(:,i) = y currentPoint++ i++; pointData(1:3,i) = y pointData(4:6,i) = "down" pointData(7:8,i) = 0; currentPoint++ i++; intPts = zeros(1,pointCount); evaluate pointData(7,i); intPts(i) = x; i = pointCount?; newPts = zeros(8,L) i = 2 k = 2; newPts(:,1) = pointData(:,1); newPts(:,k) = pointData(:,i)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

prompt user to begin

calculate magnitude
of distance between
pointData(1:3,i-1)
and pointData(1:3,i)

Ask user for number
of points being input

Ask user for point i
position

position, orientation,
and path type

create new path
points from point i,
point i-1, and intPts(i)

divide distance by 10,
round down to
nearest whole
number "x"

assign points to
newPts(:,k:k+intPts(i))

send newPoints(:,i) to

are motors at
correct angle?

Prompt user to press
"space" to grab
marker

End effector function

Path Type:
0 cartesian straight line
1 joint straight line

Writing or pick and
place?

End effector:
0 no change
1 open
2 close Task Definition "c":

0 writing
1 pick and place

close end effector
