treydufrene/meiosis_dev/LaTeX/cdr/images/eschem.pdf

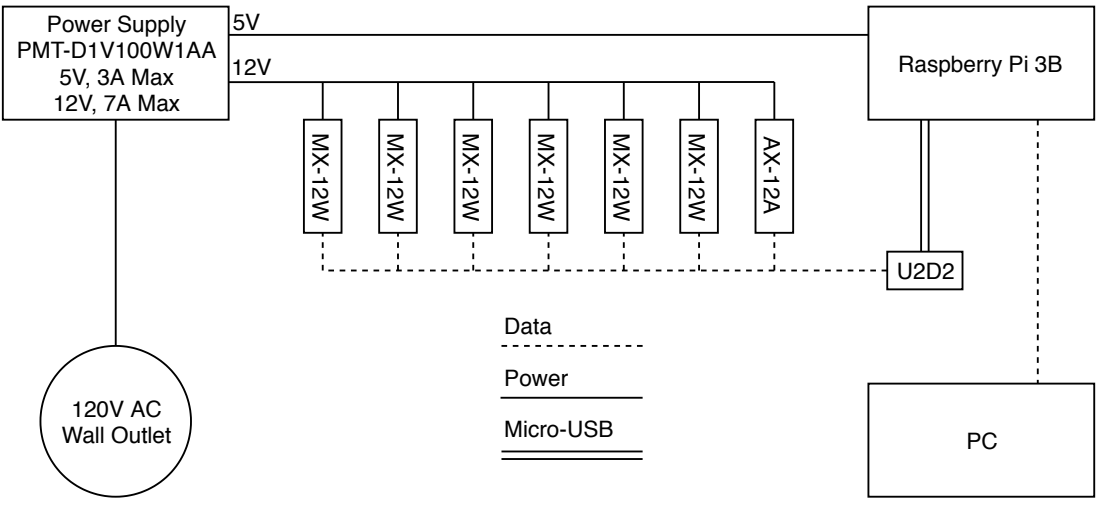
[picture p140: page 1]
120V AC Wall Outlet; Power Supply PMT-D1V100W1AA 5V, 3A Max 12V, 7A Max; Raspberry Pi 3B; Data; Power; Micro-USB
