treydufrene/meiosis_dev/LaTeX/cdr/images/sblock.pdf

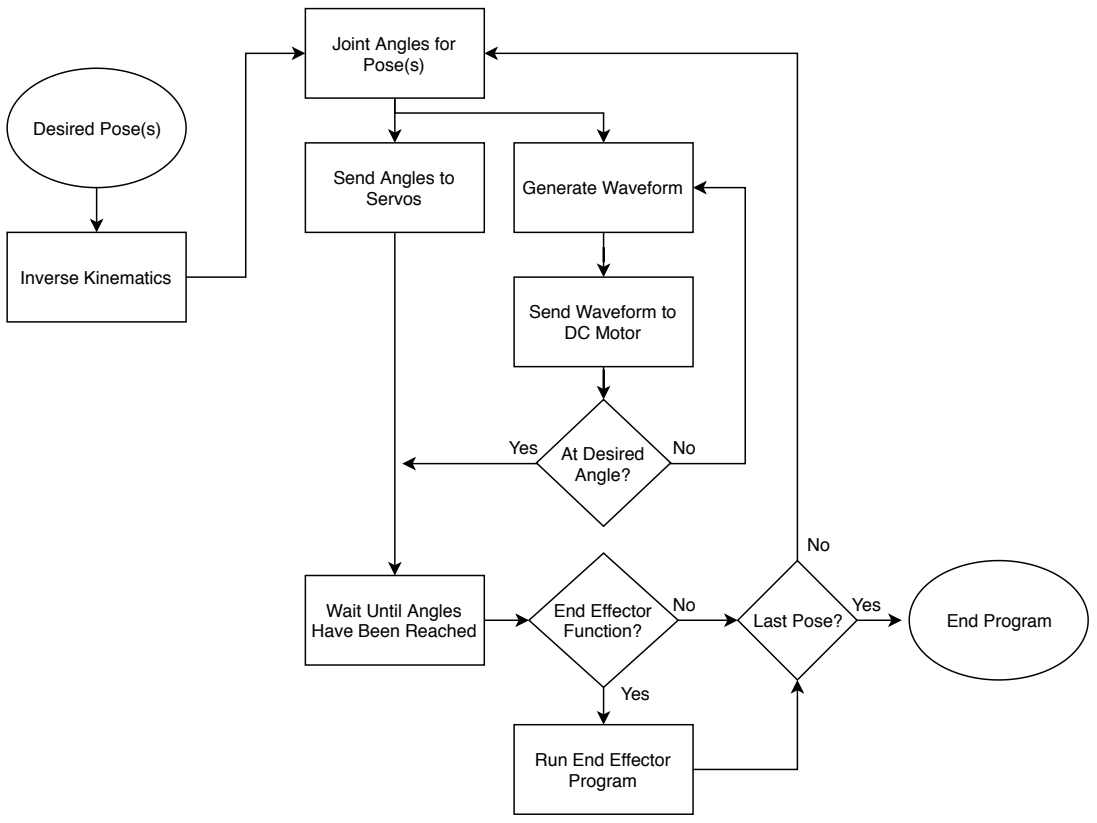
[picture p141: page 1]
Inverse Kinematics; End Effector Function?; Last Pose?; End Program; Yes; Generate Waveform; At Desired Angle?; Desired Pose(s)

Joint Angles for
Pose(s)

Send Angles to
Servos

Send Waveform to
DC Motor

Wait Until Angles
Have Been Reached

Run End Effector
Program
