treydufrene/meiosis_dev/MATLAB/dynamixel/exp.pdf

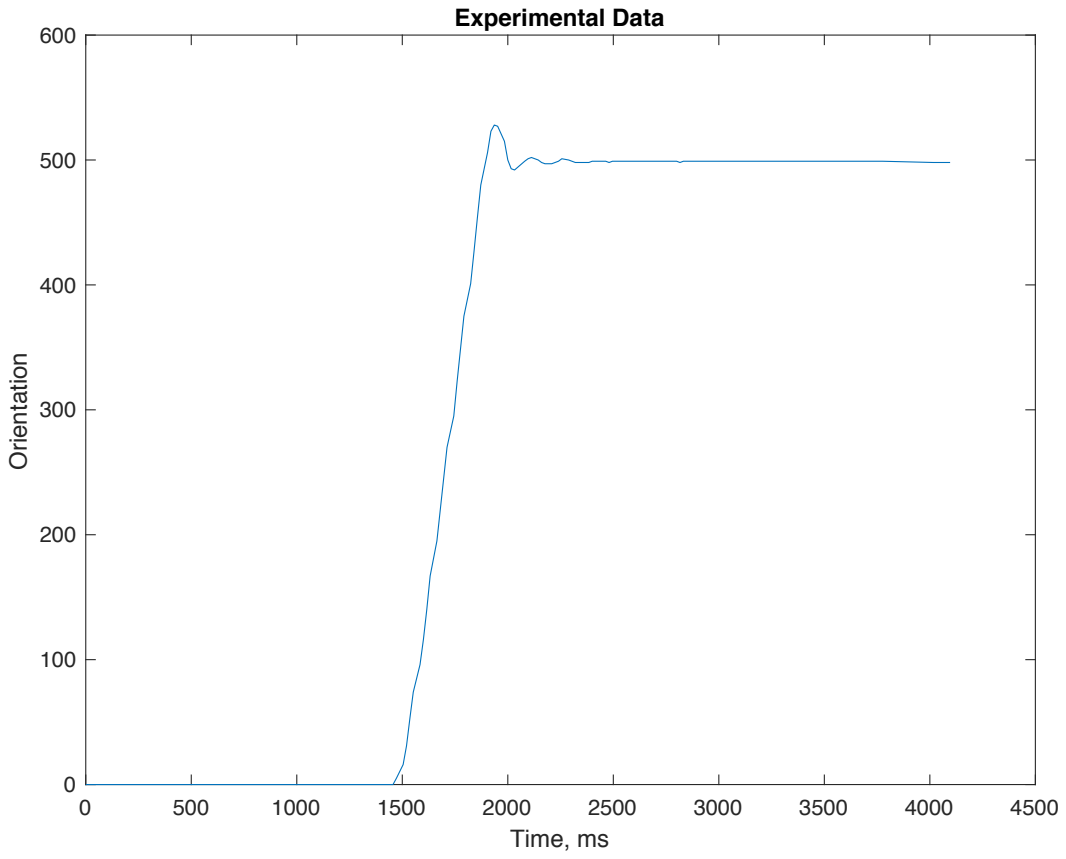
[picture p142: page 1]
Time, ms; Orientation; Experimental Data
