treydufrene/meiosis_dev/MATLAB/dynamixel/et cetera/AX-12.pdf

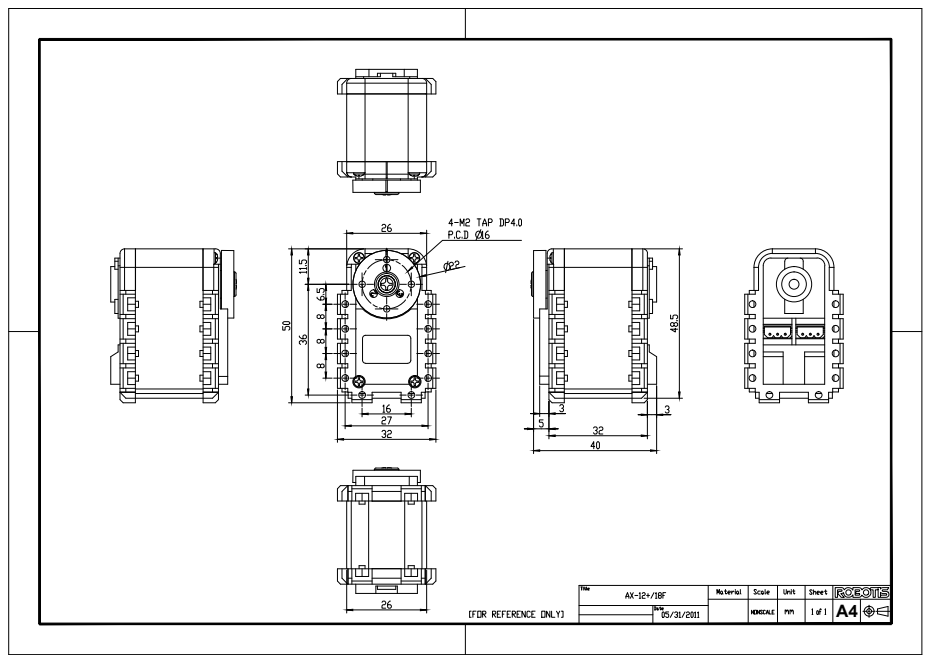
[picture p143: page 1]
