treydufrene/meiosis_dev/(commit log)

2019-10-12 initial matlab commit
    [Base.STL, Link1.STL, Link2.STL, Link3.STL]
2019-11-04 started motor model
    [512.csv]
2019-11-08 after test load 1
    [AX12A_LOAD_1.csv, AX12A_NOLOAD_1.csv, AX12A_NOLOAD_2.csv, AX18A_NOLOAD_1.csv, AX18A_NOLOAD_2.csv]
2019-11-08 updated filenames
    [AX12A_LOAD1_1.csv, AX12A_LOAD1_2.csv]
2019-11-13 added test load 3 and stuff
    [AX12A_LOAD1_1.csv, AX12A_LOAD1_2.csv, AX12A_LOAD1_3.csv, AX12A_LOAD2_1.csv, AX12A_LOAD2_2.csv, AX12A_LOAD2_3.csv, AX12A_LOAD3_1.csv, AX12A_LOAD3_2.csv]
2019-11-15 higher baudrate
    [AX12A_LOAD1_1.csv, AX12A_LOAD1_2.csv, AX12A_LOAD1_3.csv, AX12A_LOAD2_1.csv, AX12A_LOAD2_2.csv, AX12A_LOAD2_3.csv, AX12A_LOAD3_1.csv, AX12A_LOAD3_2.csv]
2019-11-15 started typing up motor dynamics section
2019-11-17 adding motor dynamics
2019-11-17 sort of finished motor dynamics section
2019-11-22 open loop animation snapshots and joint plots
2019-11-22 cleaned up folder structure
    [AX12A_LOAD1_1.csv, AX12A_LOAD1_2.csv, AX12A_LOAD1_3.csv, AX12A_LOAD2_1.csv, AX12A_LOAD2_2.csv, AX12A_LOAD2_3.csv, AX12A_LOAD3_1.csv, AX12A_LOAD3_2.csv]
2020-01-17 Add files via upload
    torque calculations
2020-01-24 made a servo script
2020-01-27 made an encoder talker
2020-02-24 added to servo functions and twolink
